woreno/IBM-PC-XT-compatible/8 adapter boards schematics.png

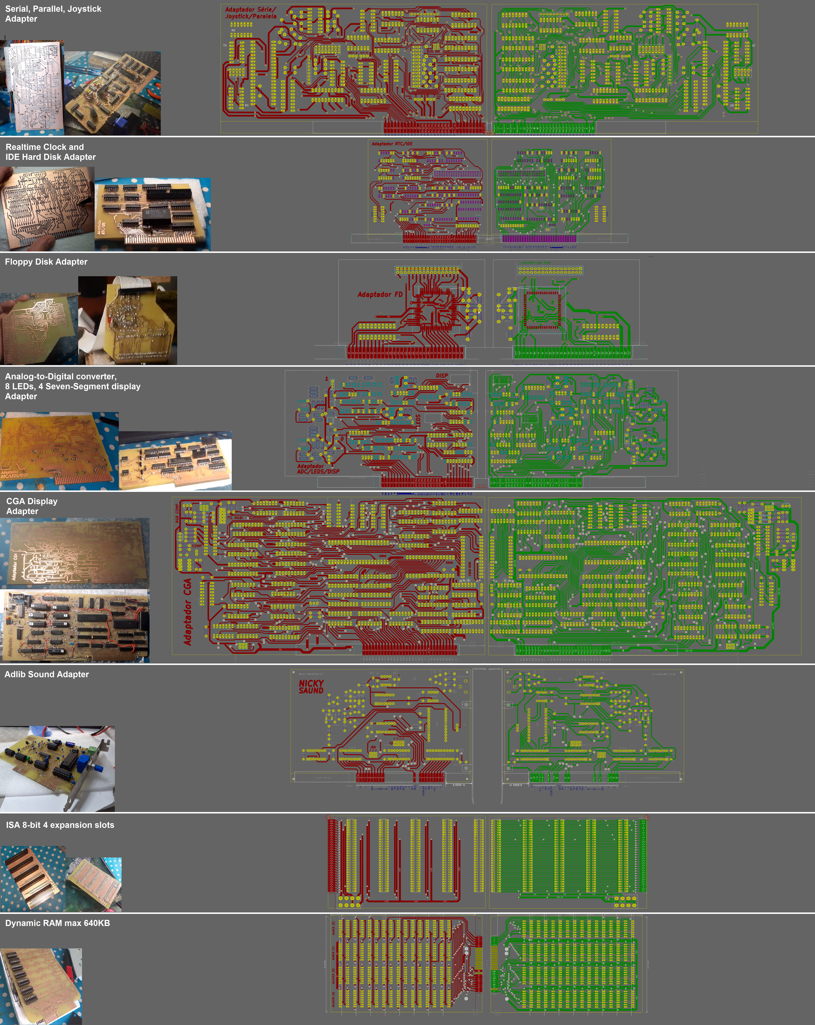
8 adapter boards schematics.png
