woreno/IBM-PC-XT-compatible/README.md

# IBM PC XT compatible (2022)
This is a IBM XT compatible built from scratch along 8 boards, 6 of them ISA 8-bit cards.

The design of the boards done here, is a bit personal. As other pcbs i do in-house, they are projected to be transfered with iron, drilled, then etched with iron perchlorate, using throught-hole chips, as many electronic and microcomputer hobbyists once did. To minimize errors on these manual procedures, circuits tracks and vias are made thicker. This project is about creating an IBM XT Compatible. This began in 2014, when i started to documenting home computer systems, like older and newer PCs, older systems like ZX Spectrum, MSX, Commodore, Amiga, Apple II, Macintosh, home and portable Sega, Nintendo and Sony entretainment systems, mainly for coding emulators. The IBM PC XT, was the second architecture to fully take notes after the ZX Spectrum.
In 2021, after manually designing and building an Apple 2 compatible computer and an Adlib card, i ask my self "it would be possible to build a bigger system like an IBM PC XT compatible using the same methods and tools???" (it seemed a big task by then). When i began, i wanted to be 8086 compatible, but the 16-bit bus and 16-bit memory organization logic, would make it impossible to fit in the maximum dimensions allowed by my own tools (A4 copper sheets), further the capacitance and thus distortion would be more pronounced on circuits.
Most components on IBM PC XT are Intel, DRAM, ROM ICs. Some control, demuxes and muxes, buffers, latches, and other glue logic is done using 74 series.

**BIOS**

* The BIOS is compiled with TASM using DOSBOX. 
* The BIOS was written from scratch except the INT10h (video services). The computer started without a videocard; first i built and relied on a ISA-card that displayed 4 seven-segment digits and 8 leds. Being the only way of displaying information from the computer, this board was very important, so after being built manually i tested rigorously the I/O with an ISA raiser, flipping buttons and multimeter, then, installing it on a Pentium PC and C Code. The BIOS has slowly developed step by step using this display board, so there's code everywhere that makes I/O to this board (including step and errors). After, i built the insane CGA card. At the first it used a primitive INT10h without a VBLANK wait (so a lot of white rain when printing), and at the end, since i was a bit exausted, i prefered to copy the original IBM PC XT INT10h code for having full compatiblity.
* After building the IDE/RTC card i had problems booting DOS. I had to CRC at each block at INT13h and do a comparasion with the groundtruth in another PC. So i end up to include also Single-Step and Breakpoint features, and debugging code traces at INT13h that can be activated by code. 
* The BIOS has a CGA welcome screen (compacted with RLE) and digitilized voices for digits (compacted with DeltaMod) these resources are glued and placed at 0xFB900. At the beggining at 0xF8000 there is the CRC and signature, and pointers to the previous resources. Theres a jump at 0xFFFF0 to the begining of the code. The voices were intended for announcing the time (with the RTC board) after POST, but at the end i decided to no call the feature, because it was too fancy.
* In the last revision of this computer, i added a switch to allow the PROMs to be written, and the BIOS can be updated via serial port, wifi or diskettes, so FAT code has added. Wifi was planned to added to the Paralllel/Serial/Joystick board, by adding a ESP8266 as the serial port (but i didn't finish this part); Wifi settings are stored in RTC memory along other BIOS settings. The make script composes a package to that goal.

**References**.
  * The Indispensable PC Hardware Book - Hans Peter Messmer; 1994
  * Digital Systems Project / Projecto de Sistemas Digitais (ISEL) - Victor Pimenta Rodrigues, Mário Seia de Araujo; 1988 (3th edition 2001)
  * IBM PC XT Technical Reference; 1983
  * Electrónica AC/DC/Analise circuitos - Santos, Guimarães e Oliveira, SA. Porto; 1980s
  * Interfacing to the IBM Personal Computer; Lewis C. Eggebrecht; 1983
  * Vintage Computer Federation (VCF)
  * GALBlast by Manfred Winterhoff
  * AT2XT Keyboard Adapter by Charles Guzis
  * XT-IDE by Charles Guzis, Vintage Computer Federation member (VCF)
  * HelpPC Reference Library by David Jurgens
  * Ben Eater's EEPROM arduino programmer
  * Dr Dobbs journal delta modulation
  * Every datasheet you can think of.

**Thanks to people i actually e-mailed them...**
  - CFG register will set the GALs scheme? Manfred Winterhoff, the author of GALBlast project
  - Can HTC lag on XT-IDE? Charles Guzis, the author of XT-IDE, XT2PS2 project
  - Whats the use of this diode on Adlib? the author of an Adlib, Sergey Malinov
