woreno/IBM-PC-XT-compatible/BIOS.png

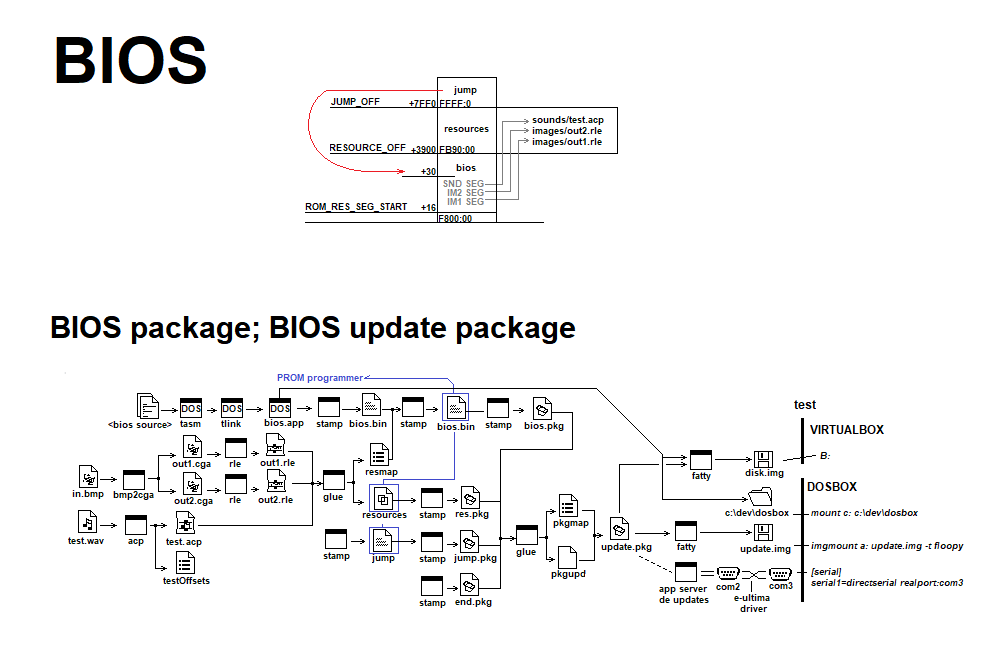
BIOS.png
