woreno/IBM-PC-XT-compatible/KICAD/ide/XT-IDE - Register map.jpg

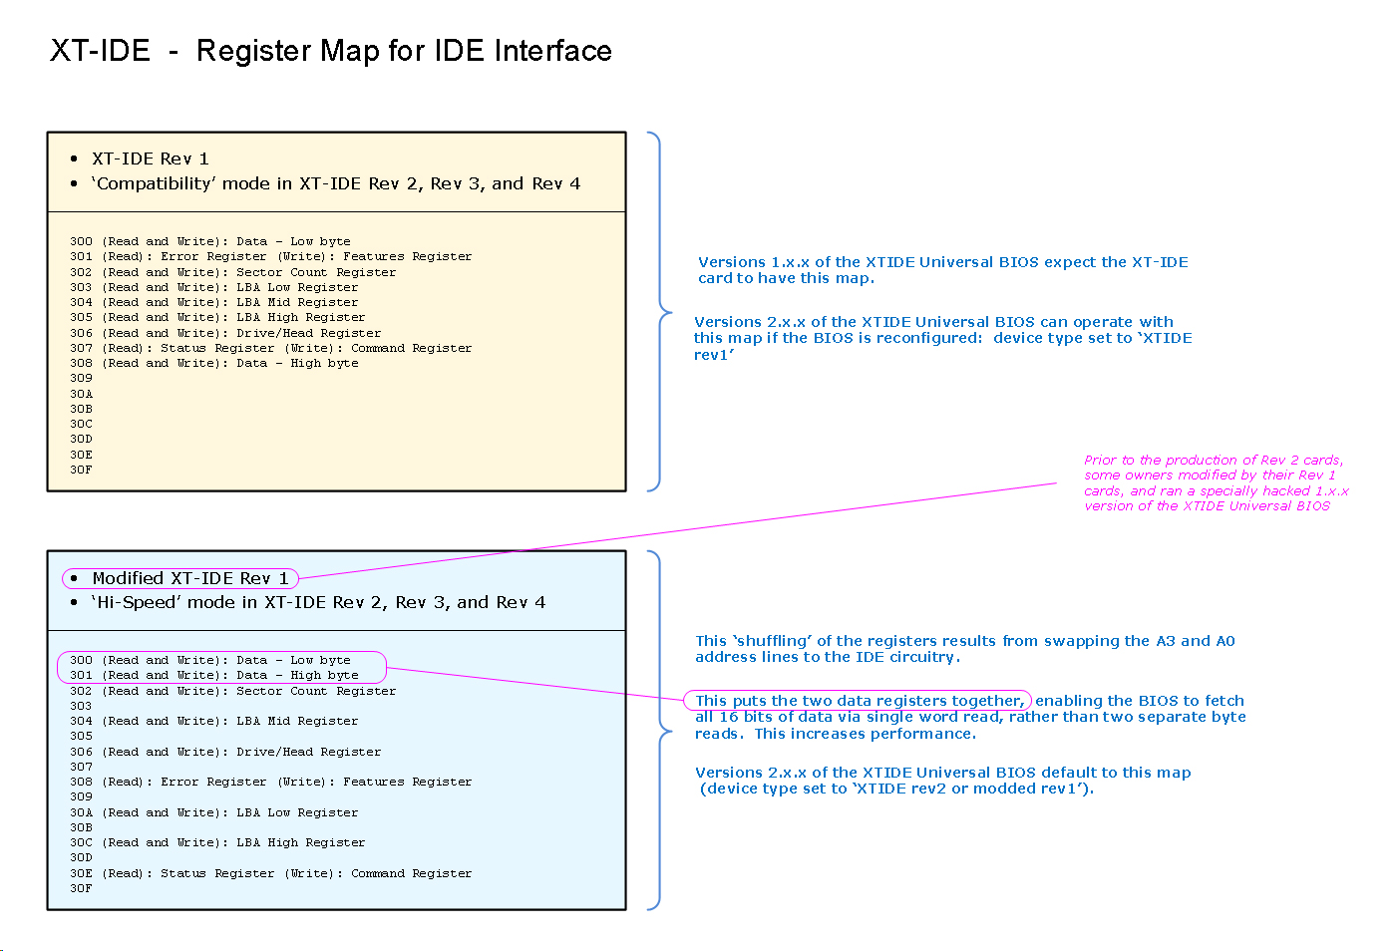
KICAD/ide/XT-IDE - Register map.jpg
