woreno/IBM-PC-XT-compatible/KICAD/ports/plel.png

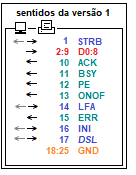
KICAD/ports/plel.png
