woreno/IBM-PC-XT-compatible/Main board schematic.png

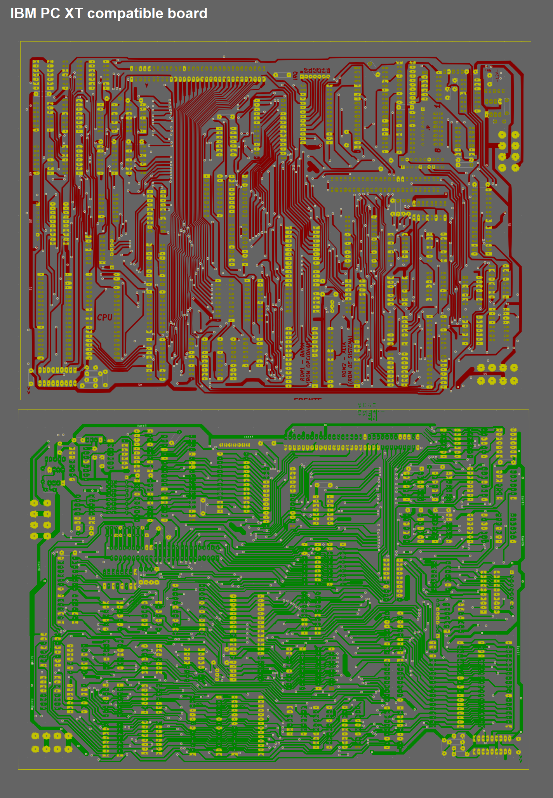
Main board schematic.png
