woreno/IBM-PC-XT-compatible/rom_test/BIOS/images/in.bmp

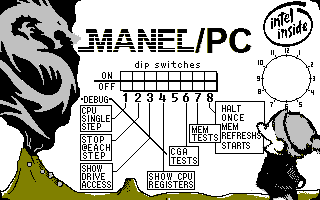
rom_test/BIOS/images/in.bmp
