woreno/IBM-PC-XT-compatible/KICAD/xt.kicad_pcb

## KiCad design KICAD/xt.kicad_pcb (2026-11-09)

Schematic: xt.sch

Parts:
C1: 5-30p; standard_2pins_half
C2, C4, C7, C9: 47p; standard_2pins_half
C3: .047; standard_2pins_half
C53: .01; standard_2pins_half
J1: IRQ8-15-Set; PinSocket_1x07_P2.54mm_Vertical
J9: xt_keyb_con; Conector1x5_Oval
P3: xt_speaker_con; Conector1x5_Oval
R1, R2: 510; standard_2pins
R3, R8, R9, R11, R12, R13, R17, R18, R19, R21, R22, R23, R24: R; standard_2pins
R4, R7: R
R4N_1, R4N_2, R4N_3, R4N_4: 30; standard_2pins
R5: 470; standard_2pins
R6: 33; standard_2pins
R15, R16: 4.7K; standard_2pins
R25: 8.2K; standard_2pins
RN1, RN2, RN3: 4.7K; R_Array_SIP9
RN4, RN5: 4.7K; R_Array_SIP10
RN4_0: 30; standard_2pins
SW1: SW_DIP_x08; Conector2x8_Oval
SW2: SW_DIP_x01
TD1: delay DS1000-100; standard_DIP_14OvalPins
U1: i8284_clockgen; standard_DIP_18pins_thin_body
U2, U9, U15: 74LS245; standard_DIP_20pins_thin_body
U3: i8088-CPU; standard_DIP_40pins_doubleBody_thinpins
U4, U19: PPROM_28C65_256; standard_DIP_28pins_thin_doubleBody
U5, U7: 74LS373; standard_DIP_20pins_thin_body
U6, U12, U14, U16, U17, U41: 74LS244; standard_DIP_20pins_thin_body
U8: 8288_busctrl; standard_DIP_20pins_thin_body
U10: 74LS670; standard_DIP_16OvalPins
U11: XD2ADDR-DMA; standard_DIP_20pins_thin_body
U13: 74LS243; standard_DIP_14OvalPins
U18: i8087-NPU; standard_DIP_40pins_doubleBody_thinpins
U20: ISA8-Edge; Conector2x31_Oval_0.65_rightangle
U21: 74LS175_separado; standard_DIP_16OvalPins
U22, U71, U220: 74LS04; standard_DIP_14OvalPins
U23: 74LS27; standard_DIP_14OvalPins
U24, U74: 74LS00; standard_DIP_14OvalPins
U25: i8259-PIC0; standard_DIP_28pins_thin_doubleBody
U26: 8255-PPI; standard_DIP_40pins_doubleBody_thinpins
U27: 74LS322; standard_DIP_20pins_thin_body
U28: i8254-PIT; standard_DIP_24pins_thin_doubleBody
U29, U57: 74LS20; standard_DIP_14OvalPins
U30: flipSwitch; mini_flipswitch2.54
U31: 74_175; standard_DIP_16OvalPins
U32, U38: manel-xt-pwer; manel-xt-power
U34: 8237-DMAC; standard_DIP_40pins_doubleBody_thinpins
U35, U36, U69: 74S00; standard_DIP_14OvalPins
U37: i8259-PIC1; standard_DIP_28pins_thin_doubleBody
U39, U40, U84: 74LS158; standard_DIP_16OvalPins
U42, U43: 74LS138; standard_DIP_16OvalPins
U44: flipSwitch
U55: 74S08; standard_DIP_14OvalPins
U56: 74S138; standard_DIP_16OvalPins
U58, U90: 74LS32; standard_DIP_14OvalPins
U68: 7407; standard_DIP_14OvalPins
U70: 74S74; standard_DIP_14OvalPins
U72: 74LS10; standard_DIP_14OvalPins
U73, U78, U86: 74LS74; standard_DIP_14OvalPins
U85: 75477_dual_peripheral_drvs; standard_DIP_8pins
U87: 74LS08; standard_DIP_14OvalPins
U89: 74S04; standard_DIP_14OvalPins
U100: xt-ram-exp; Conector2x25_Oval_0.65_rightangle
Y1: Crystal; standard_2pins

Connections:
/5V: C3.1, C4.1, J9.5 (VCC), P3.4 (VCC), R3.1, R4.1, R7.1, R8.2, R9.2, R11.1, R12.2, R13.2, R15.1, R16.2, R17.1, R18.1, R19.1, R21.2, R22.2, R23.1, R24.2, R25.2, RN1.1 (common), RN2.1 (common), RN3.1 (common), RN5.1 (common), TD1.14 (VCC), U1.18 (VCC), U2.20 (VCC), U3.40 (VCC), U4.28 (VCC), U5.20 (VCC), U6.20 (VCC), U7.20 (VCC), U8.20 (VCC), U9.20 (VCC), U10.16 (VCC), U11.20 (VCC), U12.20 (VCC), U13.14 (VCC), U14.20 (VCC), U15.20 (VCC), U16.20 (VCC), U17.20 (VCC), U18.40 (VCC), U19.28 (VCC), U20.3 (+5V), U20.29 (+5V), U21.16 (VCC), U22.14 (VCC), U23.14 (VCC), U24.14 (VCC), U25.28 (VCC), U26.26 (VCC), U27.20 (VCC), U28.11 (GATE0), U28.14 (GATE1), U28.24 (VCC), U29.14 (VCC), U31.16 (VCC), U32.3 (+5V), U32.4 (+5V), U34.5 (PIN5), U34.31 (VCC), U35.14 (VCC), U36.14 (VCC), U37.28 (VCC), U38.3 (+5V), U38.4 (+5V), U39.16 (VCC), U40.16 (VCC), U41.20 (VCC), U42.16 (VCC), U43.16 (VCC), U55.14 (VCC), U56.16 (VCC), U57.14 (VCC), U58.14 (VCC), U68.14 (VCC), U69.14 (VCC), U70.14 (VCC), U71.14 (VCC), U72.14 (VCC), U73.14 (VCC), U74.14 (VCC), U78.14 (VCC), U84.16 (VCC), U85.1 (S), U85.5 (CLAMP), U85.8 (VCC), U86.14 (VCC), U87.14 (VCC), U89.14 (VCC), U90.14 (VCC), U220.14 (VCC); also elsewhere on the board
/12V: U32.1 (+12V), U38.1 (+12V)
/+12V: U20.23 (IRQ5)
/-5V: U20.27 (TC), U32.5 (-5V), U38.5 (-5V)
/-12V: U20.25 (IRQ3), U32.2 (-12V), U38.2 (-12V)
/A0: U5.9 (O3), U12.18 (O0a), U17.11 (I0b), U20.62 (A0)
/A1: U5.12 (O4), U12.3 (O3b), U17.8 (I3a), U20.61 (A1)
/A2: U5.15 (O5), U12.16 (O1a), U17.13 (I1b), U20.60 (A2)
/A3: U5.6 (O2), U12.5 (O2b), U17.6 (I2a), U20.59 (A3)
/A4: U5.5 (O1), U12.14 (O2a), U17.15 (I2b), U20.58 (A4)
/A5: U5.16 (O6), U12.7 (O1b), U17.4 (I1a), U20.57 (A5)
/A6: U5.19 (O7), U12.9 (O0b), U17.2 (I0a), U20.56 (A6)
/A7: U5.2 (O0), U12.12 (O3a), U17.17 (I3b), U20.55 (A7)
/A8: U6.18 (O0a), U11.2 (O0), U16.15 (I2b), U20.54 (A8)
/A9: U6.16 (O1a), U11.5 (O1), U16.6 (I2a), U20.53 (A9)
/A10: U6.14 (O2a), U11.6 (O2), U16.17 (I3b), U20.52 (A10)
/A11: U6.12 (O3a), U11.9 (O3), U16.2 (I0a), U20.51 (A11)
/A12: U7.12 (O4), U11.12 (O4), U16.4 (I1a), U20.50 (A12)
/A13: U7.9 (O3), U11.15 (O5), U14.11 (I0b), U20.49 (A13)
/A14: U7.15 (O5), U11.16 (O6), U14.8 (I3a), U20.48 (A14)
/A15: U7.6 (O2), U11.19 (O7), U14.13 (I1b), U20.47 (A15)
/A16: U7.16 (O6), U10.10 (Q1), U14.6 (I2a), U20.46 (A16), U36.10
/A17: U7.5 (O1), U10.9 (Q2), U14.15 (I2b), U20.45 (A17), U35.4
/A18: U7.2 (O0), U10.7 (Q3), U14.4 (I1a), U20.44 (A18), U35.1, U35.2, U36.4
/A19: U7.19 (O7), U10.6 (Q4), U14.17 (I3b), U20.43 (A19), U35.10, U36.1, U36.2, U36.9
/AA8: U3.8 (A8), U6.2 (I0a), U18.8 (AD8)
/AA9: U3.7 (A9), U6.4 (I1a), U18.7 (AD9)
/AA10: U3.6 (A10), U6.6 (I2a), U18.6 (AD10)
/AA11: U3.5 (A11), U6.8 (I3a), U18.5 (AD11)
/AA12: U3.4 (A12), U7.13 (D4), U18.4 (AD12)
/AA13: U3.3 (A13), U7.8 (D3), U18.3 (AD13)
/AA14: U3.2 (A14), U7.14 (D5), U18.2 (AD14)
/AA15: U3.39 (A15), U7.7 (D2), U18.39 (AD15)
/AA16: U3.38 (A16.S3), U7.17 (D6), U18.38 (A16.S3)
/AA17: U3.37 (A17.S5), U7.4 (D1), U18.37 (A17.S4)
/AA18: U3.36 (A18.S6), U7.3 (D0), U18.36 (A18.S5)
/AA19: U3.35 (A19.S4), U7.18 (D7), U18.35 (A19.S6)
/AD0: U2.2 (A0), U3.16 (AD0), U5.8 (D3), U18.16 (AD0)
/AD1: U2.3 (A1), U3.15 (AD1), U5.13 (D4), U18.15 (AD1)
/AD2: U2.4 (A2), U3.14 (AD2), U5.14 (D5), U18.14 (AD2)
/AD3: U2.5 (A3), U3.13 (AD3), U5.7 (D2), U18.13 (AD3)
/AD4: U2.6 (A4), U3.12 (AD4), U5.4 (D1), U18.12 (AD4)
/AD5: U2.7 (A5), U3.11 (AD5), U5.17 (D6), U18.11 (AD5)
/AD6: U2.8 (A6), U3.10 (AD6), U5.18 (D7), U18.10 (AD6)
/AD7: U2.9 (A7), U3.9 (AD7), U5.3 (D0), U18.9 (AD7)
/ADDRSEL: TD1.3 (60NS), U39.1 (S), U40.1 (S), U84.1 (S)
/ADSTB: U11.11 (LE), U34.8 (ADSTB)
/AEN: U16.9 (O0b), U20.42 (AEN)
/AENBOARD: U5.1 (OE), U6.1 (OEa), U7.1 (OE), U8.6 (~AEN), U15.19 (CE), U16.11 (I0b), U17.1 (OEa), U17.19 (OEb), U31.2 (Q0), U31.5 (D1), U72.5, U74.4
/ALE: U5.11 (LE), U7.11 (LE), U8.5 (ALE), U20.4 (IRQ2/9)
/BA0: RN4.2 (R1), RN5.2 (R1), U39.4 (Za), U100.33 (~CAS0)
/BA1: RN4.3 (R2), RN5.3 (R2), U40.4 (Za), U100.32 (~RAS1)
/BA2: RN4.4 (R3), RN5.4 (R3), U39.7 (Zb), U100.31 (~CAS1)
/BA3: RN4.5 (R4), RN5.5 (R4), U40.7 (Zb), U100.30 (~RAS2)
/BA4: RN4.6 (R5), RN5.6 (R5), U39.9 (Zd), U100.29 (~CAS2)
/BA5: RN4.7 (R6), RN5.7 (R6), U40.9 (Zd), U100.28 (~RAS3)
/BA6: RN4.8 (R7), RN5.8 (R7), U39.12 (Zc), U100.27 (~CAS3)
/BA7: RN4.9 (R8), RN5.9 (R8), U40.12 (Zc), U100.26
/CLK: U16.7 (O1b), U20.12 (~MEMR), U31.9 (Cp), U89.9
/CLK88: U1.8 (CLK), U3.19 (CLK), U8.2 (CLK), U16.13 (I1b), U18.19 (CLK), U89.1
/CPU_GT0: RN1.2 (R1), U3.30 (HLDA.~RQ~/~GT1), U3.31 (HOLD.~RQ~/~GTO), U18.31 (~RQ/GTO)
/CPU_INT: U3.18 (INT), U25.17 (INT)
/CPU_NMI: U3.17 (NMI), U87.8
/D0: U2.18 (B0), U9.2 (A0), U15.2 (A0), U20.40 (D0)
/D1: U2.17 (B1), U9.3 (A1), U15.3 (A1), U20.39 (D1)
/D2: U2.16 (B2), U9.4 (A2), U15.4 (A2), U20.38 (D2)
/D3: U2.15 (B3), U9.5 (A3), U15.5 (A3), U20.37 (D3)
/D4: U2.14 (B4), U9.6 (A4), U15.6 (A4), U20.36 (D4)
/D5: U2.13 (B5), U9.7 (A5), U15.7 (A5), U20.35 (D5)
/D6: U2.12 (B6), U9.8 (A6), U15.8 (A6), U20.34 (D6)
/D7: U2.11 (B7), U9.9 (A7), U15.9 (A7), U20.33 (D7)
/DACK0: U56.4 (E1), U69.13, U220.4
/DATABUS_DIR: U2.1 (A->B), U8.4 (DT/~R)
/DATABUS_EN: U2.19 (CE), U22.12
/DBLCLK: U34.12 (CLK), U74.8
/DRAM_MODHI: U14.3 (O3b), U42.2 (A1), U43.6 (E3), U56.2 (A1)
/DRAM_MODLO: U36.11, U42.1 (A0), U56.1 (A0)
/DREQ0: U34.19 (DREQ0), U73.9 (Q)
/DREQ1: U20.14 (~IOR), U34.18 (DREQ1)
/DREQ2: U20.26 (~DACK2), U34.17 (DREQ2)
/DREQ3: U20.16 (DRQ3), U34.16 (DREQ3)
/ENRAMPCK: U26.22 (PB4)
/HOLDA: U31.4 (D0), U34.7 (HLDA), U73.5 (Q)
/HRQDMA: U29.5, U34.10 (HRQ), U73.1 (~R)
/IOCHRDY: R23.2, U20.41 (IO_READY), U78.10 (~S)
/IRQ0: U25.18 (IR0), U28.10 (OUT0)
/IRQ1: U25.19 (IR1), U27.1 (G), U70.5 (Q)
/IRQ2: U25.20 (IR2), U37.17 (INT)
/IRQ3: U20.7 (-12V), U25.21 (IR3)
/IRQ4: U20.8 (UNUSED), U25.22 (IR4)
/IRQ5: U20.9 (+12V), U25.23 (IR5)
/IRQ6: U20.10 (GND), U25.24 (IR6)
/IRQ7: U20.11 (~MEMW), U25.25 (IR7)
/IRQ8: J1.1, U37.18 (IR0)
/IRQ9: U20.28 (ALE), U37.19 (IR1)
/IRQ10: J1.2, U37.20 (IR2)
/IRQ11: J1.3, U37.21 (IR3)
/IRQ12: J1.4, U37.22 (IR4)
/IRQ13: J1.5, U37.23 (IR5)
/IRQ14: J1.6, U37.24 (IR6)
/IRQ15: J1.7, U37.25 (IR7)
/KBDCLK: C2.2, J9.1 (KBDCLK), R18.2, U21.4 (D0), U68.6
/KBDCLK2: U21.6 (~Q1), U27.11 (Clk), U70.3 (C)
/KBDDATA: C7.2, J9.2 (KBDDATA), R17.2, U27.17 (D1), U68.8
/MA8: RN4.10 (R9), RN5.10 (R9), U84.4 (Za), U100.25 (5V)
/MD0: U9.11 (B7), U100.3 (A2)
/MD1: U9.12 (B6), U100.2 (A1)
/MD2: U9.13 (B5), U100.1 (A0)
/MD3: U9.14 (B4), U100.50 (D0)
/MD4: U9.15 (B3), U100.49 (D1)
/MD5: U9.16 (B2), U100.48 (D2)
/MD6: U9.17 (B1), U100.46 (D4)
/MD7: U9.18 (B0), U100.47 (D3)
/NPU_INT: U18.32 (INT), U69.9
/NP_INSTALLED: RN3.3 (R2), SW1.2, U41.4 (I1a)
/OPTION1: RN3.2 (R1), SW1.1, U41.2 (I0a)
/OSC: U1.12 (OSC), U20.2 (RESET)
/PCLK: U1.2 (PCLK), U21.9 (CLK)
/PIC_CAS0: U25.12 (CAS0), U37.12 (CAS0)
/PIC_CAS1: U25.13 (CAS1), U37.13 (CAS1)
/PIC_CAS2: U25.15 (CAS2), U37.15 (CAS2)
/PIT_T1_OUT: U28.13 (OUT1), U73.11 (C), U100.6 (A5), U100.45 (D5)
/PIT_T2_OUT: U28.17 (OUT2), U87.13, U100.8 (A7), U100.43 (D7)
/PLANARRAM0: RN3.4 (R3), SW1.3, U41.6 (I2a)
/PLANARRAM1: RN3.5 (R4), SW1.4, U41.8 (I3a)
/PPI_JPR4: RN3.9 (R8), SW1.8, U26.17 (PC3), U41.12 (O3a)
/PPI_JPR5: RN3.8 (R7), SW1.7, U26.16 (PC2), U41.14 (O2a)
/PPI_JPR6: RN3.7 (R6), SW1.6, U26.15 (PC1), U41.16 (O1a)
/PPI_JPR7: RN3.6 (R5), SW1.5, U26.14 (PC0), U41.18 (O0a)
/PPI_PA0: U26.4 (PA0), U27.13 (H/Qh)
/PPI_PA1: U26.3 (PA1), U27.7 (G/Qg)
/PPI_PA2: U26.2 (PA2), U27.14 (F/Qf)
/PPI_PA3: U26.1 (PA3), U27.6 (E/Qe)
/PPI_PA4: U26.40 (PA4), U27.15 (D/Qd)
/PPI_PA5: U26.39 (PA5), U27.5 (C/Qc)
/PPI_PA6: U26.38 (PA6), U27.16 (B/Qb)
/PPI_PA7: U26.37 (PA7), U27.4 (A/Qa)
/PPI_PB3: R25.1, U26.21 (PB3), U41.1 (OEa), U100.11, U100.40, U220.1
/PPI_PB5: U26.23 (PB5), U89.13
/PPI_PB6: U26.24 (PB6), U68.5
/PPI_PB7: U26.25 (PB7), U27.8 (OE), U89.5
/PPI_PC4: U26.13 (PC4)
/PPI_PC5: U26.12 (PC5)
/PPI_PC6: U26.11 (PC6), U72.11, U74.2, U74.11
/PULLUP1: RN2.8 (R7), U18.33 (~RQ/GT1), U18.34 (~BHE/~S7)
/PWERGOOD: U1.11 (~RES)
/QS0: U3.25 (QS0.ALE), U18.25 (QS0)
/QS1: U3.24 (QS1.~INTA), U18.24 (QS1)
/RAS: TD1.1 (IN), U56.6 (E3), U69.6, U69.12
/RDYTODMA: U34.6 (READY), U87.3
/READY: U1.5 (READY), U3.22 (RDY), U18.22 (RDY)
/RESET: U1.10 (RESET), U3.21 (RST), U18.21 (RST), U26.35 (RESET), U34.13 (RESET), U89.3
/RESETDRV: U20.30 (OSC), U71.6
/RN1_6: RN1.3 (R2), U3.23 (~TEST), U18.23 (BUSY)
/RN1_7: RN1.8 (R7)
/RN1_9: RN1.9 (R8), U57.13
/ROMCS: U23.5, U24.8; also elsewhere on the board
/SPK: C53.1, R6.1, U85.6 (2Y)
/SPKRDATA: U26.19 (PB1), U87.12
/SS0: U3.34 (~SS0.HIGH)
/TIM2GATESPK: U26.18 (PB0), U28.16 (GATE2), U100.14 (GND), U100.37
/TIMER_CLK: U21.10 (Q2), U28.9 (CLK0), U28.15 (CLK1), U28.18 (CLK2), U100.13 (GND), U100.38 (~WR)
/T\C: U20.5 (-5V), U220.8
/X1: C1.2, R1.1, U1.17 (X1)
/X2: R2.1, U1.16 (X2), Y1.2
/XA0: U4.10 (A0), U10.14 (Wa), U12.2 (I0a), U17.9 (O0b), U19.10 (A0), U25.27 (A0), U26.9 (A0), U28.19 (A0), U34.32 (A0), U37.27 (A0), U39.2 (I0a)
/XA1: U4.9 (A1), U10.13 (Wb), U12.17 (I3b), U17.12 (O3a), U19.9 (A1), U26.8 (A1), U28.20 (A1), U34.33 (A1), U40.2 (I0a), U100.15 (GND), U100.36
/XA2: U4.8 (A2), U12.4 (I1a), U17.7 (O1b), U19.8 (A2), U34.34 (A2), U39.5 (I0b)
/XA3: U4.7 (A3), U12.15 (I2b), U17.14 (O2a), U19.7 (A3), U34.35 (A3), U40.5 (I0b)
/XA4: U4.6 (A4), U12.6 (I2a), U17.5 (O2b), U19.6 (A4), U34.37 (A4), U39.11 (I0d), U58.2, U58.4
/XA5: U4.5 (A5), U12.13 (I1b), U17.16 (O1a), U19.5 (A5), U34.38 (A5), U40.11 (I0d); also elsewhere on the board
/XA6: U4.4 (A6), U12.11 (I0b), U17.18 (O0a), U19.4 (A6), U34.39 (A6), U39.14 (I0c); also elsewhere on the board
/XA7: U4.3 (A7), U12.8 (I3a), U17.3 (O3b), U19.3 (A7), U34.40 (A7), U40.14 (I0c); also elsewhere on the board
/XA8: U4.25 (A8), U16.5 (O2b), U19.25 (A8), U40.3 (I1a), U44.3 (line2), U58.1; also elsewhere on the board
/XA9: U4.24 (A9), U16.14 (O2a), U19.24 (A9), U23.2, U39.6 (I1b); also elsewhere on the board
/XA10: U4.21 (A10), U16.3 (O3b), U19.21 (A10), U40.6 (I1b)
/XA11: U4.23 (A11), U16.18 (O0a), U19.23 (A11), U39.10 (I1d)
/XA12: U4.2 (A12), U16.16 (O1a), U19.2 (A12), U40.10 (I1d)
/XA13: U4.26 (A13), U14.9 (O0b), U19.26 (A13), U39.13 (I1c)
/XA14: U4.1 (A14), U14.12 (O3a), U19.1 (A14), U39.3 (I1a)
/XA15: U14.7 (O1b), U40.13 (I1c), U43.1 (A0)
/XA16: U14.14 (O2a), U43.2 (A1), U84.2 (I0a)
/XA17: U14.5 (O2b), U43.3 (A2), U84.3 (I1a)
/XA18: U14.16 (O1a), U24.1, U24.2; also elsewhere on the board
/XD0: U4.11 (D0), U10.15 (D1), U11.3 (D0), U15.18 (B0), U19.11 (D0), U25.11 (D0), U26.34 (D0), U28.8 (D0), U34.30 (D0), U37.11 (D0)
/XD1: U4.12 (D1), U10.1 (D2), U11.4 (D1), U15.17 (B1), U19.12 (D1), U25.10 (D1), U26.33 (D1), U28.7 (D1), U34.29 (D1), U37.10 (D1)
/XD2: U4.13 (D2), U10.2 (D3), U11.7 (D2), U15.16 (B2), U19.13 (D2), U25.9 (D2), U26.32 (D2), U28.6 (D2), U34.28 (D2), U37.9 (D2)
/XD3: U4.15 (D3), U10.3 (D4), U11.8 (D3), U15.15 (B3), U19.15 (D3), U25.8 (D3), U26.31 (D3), U28.5 (D3), U34.27 (D3), U37.8 (D3)
/XD4: U4.16 (D4), U11.13 (D4), U15.14 (B4), U19.16 (D4), U25.7 (D4), U26.30 (D4), U28.4 (D4), U34.26 (D4), U37.7 (D4)
/XD5: U4.17 (D5), U11.14 (D5), U15.13 (B5), U19.17 (D5), U25.6 (D5), U26.29 (D5), U28.3 (D5), U34.23 (D5), U37.6 (D5)
/XD6: U4.18 (D6), U11.17 (D6), U15.12 (B6), U19.18 (D6), U25.5 (D6), U26.28 (D6), U28.2 (D6), U34.22 (D6), U37.5 (D6)
/XD7: U4.19 (D7), U11.18 (D7), U15.11 (B7), U19.19 (D7), U25.4 (D7), U26.27 (D7), U28.1 (D7), U34.21 (D7), U37.4 (D7), U86.12 (D)
/XMEMR: U71.10, U72.4
/\eop: R19.2, U34.36 (~EOP), U220.9
/efi: U1.14 (EFI)
/~AEN: U8.15 (CEN), U31.3 (~Q0), U57.9; also elsewhere on the board
/~CAS: U42.5 (E2), U69.3
/~CAS0: U42.15 (O0), U100.20 (5V)
/~CAS1: U42.14 (O1), U100.21 (~5V)
/~CAS2: U42.13 (O2), U100.22 (~5V)
/~CAS3: U42.12 (O3), U100.23 (~5V)
/~DACK0: U16.12 (O3a), U20.13 (~IOW)
/~DACK0BRD: U16.8 (I3a), U24.4, U34.25 (~DACK0), U42.6 (E3), U72.3, U73.13 (~R), U78.12 (D), U220.3; also elsewhere on the board
/~DACK1: U20.15 (~DACK3), U34.24 (~DACK1)
/~DACK2: U10.4 (Rb), U20.6 (DRQ2), U34.14 (~DACK2)
/~DACK3: U10.5 (Ra), U20.17 (~DACK1), U34.15 (~DACK3)
/~DATABUS_EN: U8.16 (DEN), U22.13
/~DMACS: U34.11 (~CS), U90.13; also elsewhere on the board
/~DMAEN: U10.11 (~Er), U11.1 (OE), U12.1 (OEa), U12.19 (OEb), U13.1 (OEa), U13.13 (OEb), U74.6
/~DMAWAIT: U1.4 (RDY1), U31.6 (~Q1)
/~HDD_CS: R4.2, U23.9
/~INTA: RN2.6 (R5), U8.14 (~INTA), U24.13, U25.26 (~INTA), U37.26 (~INTA), U100.12 (GND), U100.39; also elsewhere on the board
/~IOCHK: R8.1, U20.32 (~IOCHK), U74.1
/~IOR: RN2.4 (R3), U8.13 (~IORC), U13.8 (B3), U20.18 (DRQ1)
/~IOW: RN2.2 (R1), U8.12 (~AIOWC), U13.10 (B1), U20.19 (~DACK0)
/~KBDRESET: C9.2, J9.3 (~KBDRESET), U21.1 (~MR), U31.1 (~Mr), U71.5, U86.13 (~R), U89.4
/~LOCK: U3.29 (~WR~.~LOCK), U29.1
/~MEMR: RN2.7 (R6), U8.7 (~MRDC), U13.11 (B0), U20.20 (CLK88), U57.12
/~MEMW: RN2.5 (R4), U8.8 (~AMWC), U13.9 (B2), U20.21 (IRQ7), U30.1 (line1)
/~MWTC: RN2.3 (R2), U8.9 (~MWTC), U57.10
/~PIC0CS: U25.1 (~CS); also elsewhere on the board
/~PIC1CS: U37.1 (~CS), U100.9 (A8), U100.42; also elsewhere on the board
/~PPICS: U26.6 (~CS), U58.6, U100.10, U100.41
/~RAMADDRSEL: U9.19 (CE), U24.6, U42.4 (E1), U56.5 (E2); also elsewhere on the board
/~RAS0: R4N_1.1, U100.16 (GND)
/~RAS1: R4N_2.1, U100.17
/~RAS2: R4N_3.1, U100.18
/~RAS3: R4N_4.1, U100.19 (5V)
/~RDY~\WAIT: U1.3 (~AEN1), U31.12 (D2), U78.9 (Q)
/~REFRESH_GATE: U55.1, U55.4, U55.10, U55.13, U69.11
/~ROMCS0: U4.20 (~CE), U4.22 (~OE), U24.9, U43.9 (O6); also elsewhere on the board
/~ROMCS1: U19.20 (~CE), U19.22 (~OE), U24.10, U43.7 (O7); also elsewhere on the board
/~ROMWR: U4.27 (~WE), U19.27 (~WE), U30.2 (short)
/~S0: U3.26 (~DEN.~S0), U8.19 (~S0), U18.26 (~S0), U29.4
/~S1: U3.27 (DT/~R~.~S1), U8.3 (~S1), U18.27 (~S1), U29.2
/~S2: U3.28 (IO/~M~.~S2), U8.18 (~S2), U18.28 (~S2)
/~TCCS: U28.21 (~CS); also elsewhere on the board
/~WE: RN4_0.1, U100.35
/~WRTDMAPGREG: U10.12 (~Ew), U58.8
/~WRTNMIREG: U58.11, U86.11 (C)
/~XIOR: RN1.7 (R6), U13.6 (A3), U23.1, U23.10, U23.11, U25.3 (~RD), U26.5 (~RD), U28.22 (~RD), U34.1 (~IOR), U37.3 (~RD), U72.13, U100.7 (A6), U100.44 (D6)
/~XIOW: RN1.5 (R4), U13.4 (A1), U25.2 (~WR), U26.36 (~WR), U28.23 (~WR), U34.2 (~IOW), U37.2 (~WR), U58.10, U58.12, U72.1, U90.12
/~XMEMR: RN1.4 (R3), U9.1 (A->B), U13.3 (A0), U34.3 (~MEMR), U43.5 (E2), U69.5, U71.11
/~XMEMW: RN1.6 (R5), U13.5 (A2), U22.1, U34.4 (~MEMW), U69.4
Earth: C2.1, C3.2, C4.2, C7.1, C9.1, C53.2, J9.4 (GND), P3.3 (GND), R1.2, R2.2, RN4.1 (common), SW1.13, SW1.14, SW1.15, SW1.16, SW2.1, TD1.7 (GND), U1.1 (CSYNC), U1.6 (RDY2), U1.9 (GND), U1.13 (F/~C), U1.15 (~ASYNC), U2.10 (GND), U3.1 (GND), U3.20 (GND), U3.33 (MIN/~MAX), U4.14 (GND), U5.10 (GND), U6.10 (GND), U7.10 (GND), U8.1 (Multibus), U8.10 (GND), U9.10 (GND), U10.8 (GND), U11.10 (GND), U12.10 (GND), U13.7 (GND), U14.1 (OEa), U14.10 (GND), U14.19 (OEb), U15.10 (GND), U16.1 (OEa), U16.10 (GND), U16.19 (OEb), U17.10 (GND), U18.1 (GND), U18.20 (GND), U19.14 (GND), U20.1 (GND), U20.22 (IRQ6), U20.31 (GND), U21.8 (GND), U22.7 (GND), U23.7 (GND), U24.7 (GND), U25.14 (GND), U26.7 (GND), U26.10 (PC7), U27.10 (GND), U28.12 (GND), U29.7 (GND), U31.8 (GND), U32.7 (GND), U32.8 (GND), U34.20 (GND), U35.7 (GND), U36.7 (GND), U37.14 (GND), U37.16 (~SP~/~EN), U38.7 (GND), U38.8 (GND), U39.8 (GND), U39.15 (E), U40.8 (GND), U40.15 (E), U41.10 (GND), U42.3 (A2), U42.8 (GND), U43.8 (GND), U55.7 (GND), U56.8 (GND), U57.7 (GND), U58.7 (GND), U68.7 (GND), U69.7 (GND), U70.7 (GND), U71.7 (GND), U72.7 (GND), U73.7 (GND), U74.7 (GND), U78.7 (GND), U84.8 (GND), U84.15 (E), U85.4 (GND), U86.7 (GND), U87.7 (GND), U89.7 (GND), U90.7 (GND), U220.7 (GND); also elsewhere on the board
unnamed: C1.1, Y1.1
unnamed: P3.1 (KEY), R6.2
unnamed: R3.2, U30.3 (line2)
unnamed: R4N_1.2, U55.3
unnamed: R4N_2.2, U55.11
unnamed: R4N_3.2, U55.6
unnamed: R4N_4.2, U55.8
unnamed: R5.1, U89.8
unnamed: R5.2, U74.9
unnamed: R9.1, U69.10
unnamed: R11.2, U27.2 (S/P), U27.3 (D0), U27.18 (SE), U27.19 (DS)
unnamed: R12.1, U72.9
unnamed: R13.1, U86.10 (~S)
unnamed: R15.2, U1.7 (~AEN2)
unnamed: R16.1, U25.16 (~SP~/~EN)
unnamed: R21.1, U26.20 (PB2)
unnamed: R22.1, U73.10 (~S), U73.12 (D)
unnamed: R24.1, U56.3 (A2)
unnamed: RN4_0.2, U22.4
unnamed: SW1.9, U68.10
unnamed: SW1.10, U68.12
unnamed: SW1.11, U68.4
unnamed: SW1.12, U68.2
unnamed: SW2.2, U69.8, U72.10
unnamed: TD1.5 (100NS), U69.1
unnamed: U15.1 (A->B), U23.6
unnamed: U21.2 (Q0), U21.5 (D1)
unnamed: U21.11 (~Q2), U21.12 (D2)
unnamed: U22.2, U22.3
unnamed: U22.5, U90.11
unnamed: U22.6, U90.10
unnamed 302: U23.4, U24.11; also elsewhere on the board
unnamed: U23.3, U23.12
unnamed: U23.13, U44.2 (short)
unnamed 305: U24.3, U43.4 (E1); also elsewhere on the board
unnamed 306: U24.5, U35.8; also elsewhere on the board
unnamed: U27.9 (Clr), U70.1 (~R), U89.6
unnamed: U27.12 (Qh), U70.2 (D)
unnamed: U29.6, U90.9
unnamed: U31.7 (Q1), U74.5
unnamed: U31.11 (~Q2), U78.13 (~R), U87.2
unnamed: U31.13 (D3), U71.2
unnamed: U31.15 (Q3), U73.2 (D)
unnamed 318: U58.13; also elsewhere on the board
unnamed 319: U58.9; also elsewhere on the board
unnamed 320: U58.5; also elsewhere on the board
unnamed: U35.9, U35.11
unnamed: U35.6, U35.12
unnamed: U35.3, U35.5, U35.13
unnamed: U36.3, U36.5
unnamed: U36.6, U36.12
unnamed: U36.8, U36.13
unnamed: U44.1 (line1), U58.3
unnamed: U55.2, U56.11 (O4)
unnamed: U55.5, U56.9 (O6)
unnamed: U55.9, U56.7 (O7)
unnamed: U55.12, U56.10 (O5)
unnamed: U57.8, U69.2
unnamed: U68.9, U70.4 (~S), U70.6 (~Q)
unnamed: U71.1, U90.8
unnamed: U72.2, U72.6
unnamed: U72.8, U87.10
unnamed: U72.12, U78.11 (C)
unnamed: U73.3 (C), U74.10, U89.2
unnamed: U73.4 (~S), U73.6 (~Q)
unnamed: U74.3, U74.12
unnamed: U74.13, U89.12
unnamed: U78.8 (~Q), U87.1
unnamed: U85.7 (2A), U87.11
unnamed: U86.9 (Q), U87.9
unnamed: U68.1, U68.3, U68.11, U68.13, U220.2
unnamed: U24.12, U220.12
unnamed: U23.8, U220.13

Notes on the sheet:
O gerador de clocks produz apartir de OSC CLK : 1/3 de OSC, 33% duty PCLK : 1/6 de OSC, 50% duty
OSC é gerado apartir dum oscilador cristal a 14.31818MHz
presa do endereço alto
~OE + S/~P=LO => parallel load data in: clock ascendente
este driver para 2 cargas era suposto além de levar o sinal de out2 para speaker, levar o sinal MOTORON para o recorder por 1A-1Y, (no PC original desde PB3, substituido)
aqui esta esquizita forma de comutar os jumpers se PB3=LO passa o transceiver 244 com a parte baixa dos jumpers e o inversor fica a HI, não fazendo diferença os jumpers da parte alta; se PB3=HI a parte baxa não passa e o inversor fica à terra, deixando passar os jumpers na parte alta (porque ligam 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
este PIP está a contar que vai ser programado para que as linhas PPI_A e PPI_C serem de leitura (IN), PPI_B serem de escrita (OUT)
desde cpu e controlador DMA se CPU em ESTADO PASSIVO ou HALT e não lock, e houver request DMA então proceder
um pedido dum canal DMA, desde controlador DMA
confirmação de cedência para o controlador DMA
para gerador clocks
e ativar controlador DMA
para READY no controlador DMA (sinal anologo a /IOCHRDY mas para o DMA)
para fachada com bus local
para controlador bus
para clock controlador DMA
pedido de atualização de memória (canal 0) apenas se não houver confirmação do mesmo ainda
esta delay line foi substuido por resistência em versões post.
divisor da frequência de PCLK resulta numa freq. de 1.193180MHz vai para todos os contadores do PIT
temporizador 1 vai para pedido DMA canal 0, atualização de memória
> (aos slots)
transceiver <<>> se em dma (A->B, ex. MEMR <- XMEMR) normalmente (B->A, ex. MEMR -> XMEMR) (se em dma o BUS CTRL tem de se afastar de MEMRx, IOWx, etc)
presa 4x4 bits; guarda as páginas para cada canal DMA; se a flag de acesso I/O "WRTDMAPGREG" escreve em A16:A19, a página respetiva ao número em XA0:1 vinda de XD0:4 se em DMA "~DMAEN~", a página é exposta em A16:19 (no bus sistema)
presa de 8 bits; prende a "parte meia" do endereço (configurada no DMA para o canal ativo), passada por XD0:7 com o sinal "ADSTB" pelo controlador de DMA; expõem o endereço A8:15 (no bus de sistema)
ativa o registo para escrever os MSBs do endereço de memória para cada canal
0xC0 apaga ou faz set para (na verdade como clk) ao ff que ativa/inibe todas as NMIs
para expansão bus
este ff, guarda em Q o inibidor da NMI
descodifica endereço base I/O 0h, 20h, 40h, 60h e ativa o respetivo chip DMA,INT,PIT,PPI ou 80h registo de página DMA para escrever MSBs altos, ou A0h o ff para inibir/permitir as NMI
desde NPU
erro dispositivo (IOCHK lógica positiva)
desde slots, o dispositiivo tem de a pushar a zero se erro (na notação original este sinal está sem traço)
desde PPI (jumpers)
desde PPI
Alimentação tb vai à parte para a placa de expansão
dados/endereço multiplexado: parte baixa AD0:7
multiplexa o endereço para o endereço linha ou coluna É IMPORTANTE que XA0:7 seja o endereço RAS, porque o DMA roda o endereço baixo XA0:7 para atualização de memória
fachada com bus CPU <-> bus sistema ----------------------------------------- * ALE (desde controlador de bus) prende o endereço multiplexado nas presas e expõem ao bus de sistema * AENBRD (desde GEN SINALS) deixa em alta impedância os transceivers e presas com o CPU, para separâ-lo do bus de siste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
transceiver de dados desde/para a memória
buffer >>
> (para slots)
presa do endereço baixo
transceiver <<>>
CLK é CLK88 buffered
PC7: retirado PCK
Não permitir DMA em I/O que nao tenha (~AEN~=1 se dma não ativo)
6 e 7 são a ROM0 e ROM1 de 32KB
dma ativo (I/O que não faz DMA, afastar)
dma NÃO ativo (I/O sem DMA pode descodificar)
AEN=0 (slots) ~AEN=1 AENBRD=0 ~DMAEN=1
INICIO do CICLO BUS
ALE=1
No XT, existe um slot especial o 8, que leva ~YMEMW~, ~YMEMR~ e o restante XBUS
| | | | | | | |
para controlador bus e gerador de sinais dma >>
2ª parte não usada
flip flop ~SR~ com portas NAND (~IOCHK~, ~ENIOCHK~)
modificação REV2
não iniciar DMA se se está a configurar o controlador
modificação rev. 2
antes uma delay line e anti colisão 2 resistências
modificação rev. 2
para ~IOR/W, são aproveitadas as linhas livres de U32 (chipselect + ~IOR/W~)
aqui KBDATA por jumper (e usando um driver 75477) (saída c\ omplemento) pode ser conduzida por porta do PPI
opcao teclado
canal 0 e canal 1 partilham o mesmo registo
CLK88 (buffered)
~RESET~ (buffered)
esta modificações se calhar usar um 74S00
escolhe a coluna de módulos <DRAM_MODHI, DRAM_MODLO> 0: 256KB 1: 256KB 2:64KB 3:64KB
indica se o endereço pertence à região destinada para à DRAM < 640KB
estas linhas são ligadas à mão ex. IRQ8 ao RTC, IRQ14 ao disco, IRQ9 não está ligado e mapeado para IRQ2 (para compatibilidade com placas antigas)
dummy
aqui é um NAND OPEN COLETOR e falta um pullup 4.7K
transceiver<<>>
ligado com DATABUS_EN DATABUS_DIR=0 (leitura) <-- DATABUS_DIR=1 (escrita) -->
ligado normalmente (NÃO DMA) normalmente no sentido de escrita (D->XD) =0 (A<-B, leitura D<-XD) se <se leitura de integrado I/O> ou <ROM> ou <Envio ao cpu do vetor de interrupção> =1 caso contrário fica para (A->B, escrita D->XD)
~XMEMR~=0 , A<-B leitura ~XMEMR~=1 , A->B escrita
ligado se endereço é da RAM
ESTE NOT FOI TIRADO ESTAVA ERRADO!
OS PINOS ESTÃO ERRADOS - A CORRIGIR TAP3 60ns = pino 10 TAP5 100ns = pino 8
atenção o sinal RAS acontece mesmo nos acessos ROM, mas MODHI nesses casos desativa as linhas ~RASi
inserir WAITSTATE SE....
apenas ~CAS~ se leitura/escrita de memória ou DMA (este sinal só é USADO se NÃO /DACK0)
tem duty 50% igual a PCLK
isto foi uma modificação à ultima da hora, porque aloquei o RTC em 70h (antes o PPI estava a consumir 6xh e 7xh)!
se em atualização todas as linhas /RASi são selecionadas
---------------------------
aqui foi mudado para permitir que I/O integrado se refira apenas 00, 20, 40, etc e outras portas entre meio possam ser descodificadas por exemplo 70h (RTC) numa placa caso o switch esteja no outro lado, a placa descodifica todo o endereços IO de [0:0x100[
AEN=1 (slots) ~AEN=0 AENBRD=1 ~DMAEN=0
buffer A >> XA (quando DMA NÃO está em transferência)
estes buffers sao mutualmente exclusivos
buffer XA >> A (quando DMA está em transferência)
SEMPRE SE IOCHRDY=0
INSERIR se uma transferencia DMA de leitura mas não para atualização de memória
ou INSERIR se for um acesso I/O
este vai sincronizar com /RDY o qual fará o CPU inserir WAITSTATE.
há RESET assim que /WAIT
a ZERO para alguma NMI
se ff ativo deixa passar a NMI
temporizador 0 é usado pelo DOS para definir hora/data
temporizador 2 para o speaker

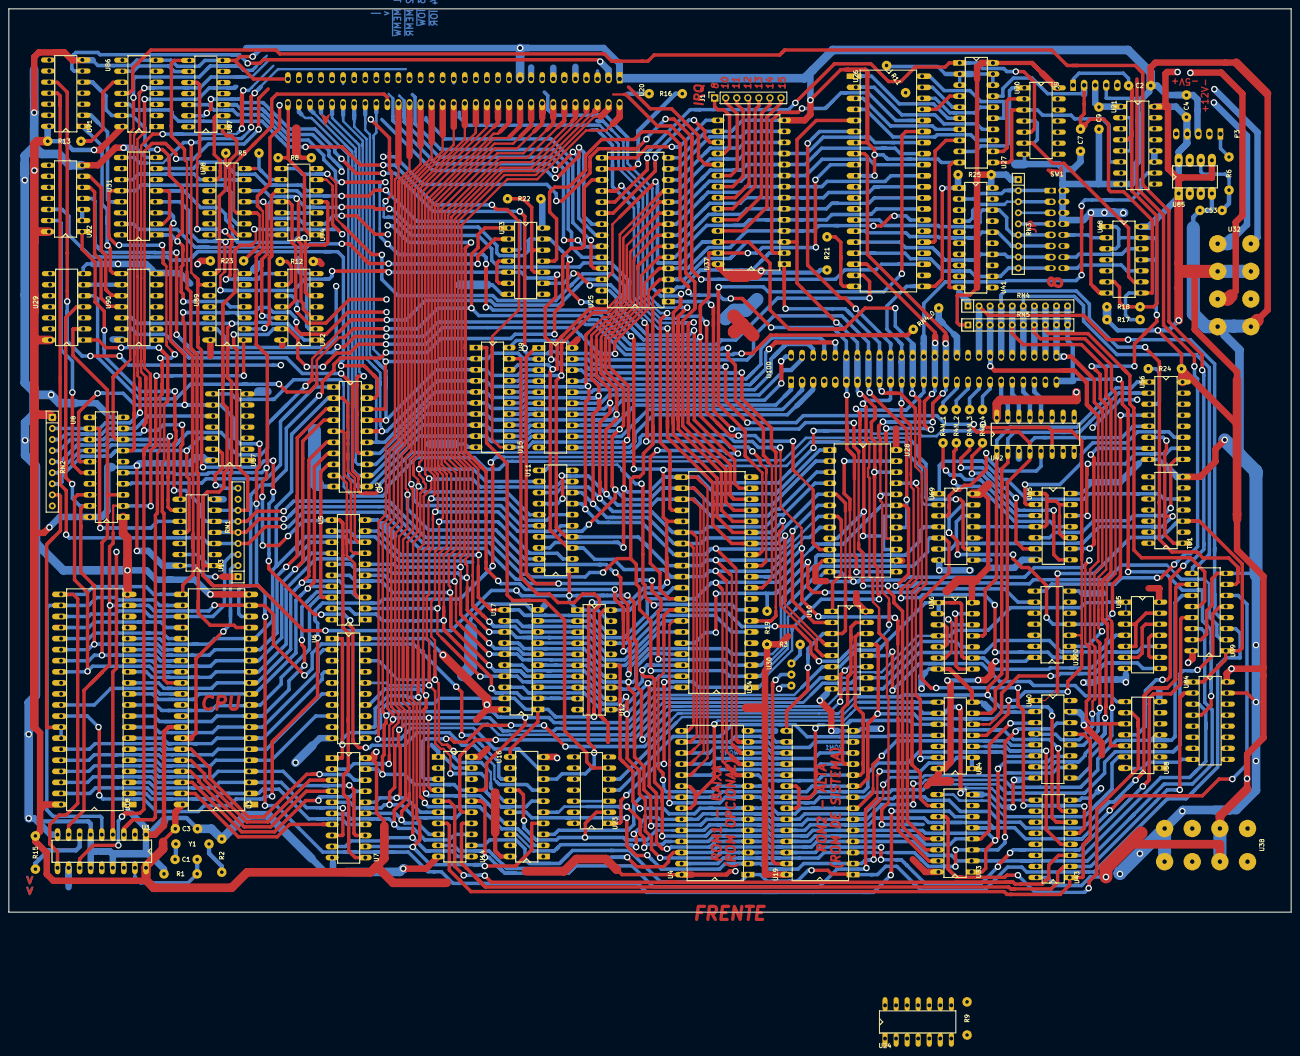
[picture p7: board xt.kicad_pcb from above]

Board: 2 copper layers, 294.5 x 207.5 mm, 107 parts (0 on the bottom side), 307 nets.

Other parts of the board:
U24#2: 74LS00; standard_DIP_14OvalPins
U33: 74LS138; standard_DIP_16OvalPins

Their connections:
/5V: U24#2.14, U33.16; also elsewhere on the board
/ROMCS: U24#2.8; also elsewhere on the board
/XA5: U33.1; also elsewhere on the board
/XA6: U33.2; also elsewhere on the board
/XA7: U33.3; also elsewhere on the board
/XA8: U33.4; also elsewhere on the board
/XA9: U33.5; also elsewhere on the board
/XA18: U24#2.1, U24#2.2; also elsewhere on the board
/~AEN: U33.6; also elsewhere on the board
/~DACK0BRD: U24#2.4; also elsewhere on the board
/~DMACS: U33.15; also elsewhere on the board
/~INTA: U24#2.12, U24#2.13; also elsewhere on the board
/~PIC0CS: U33.14; also elsewhere on the board
/~PIC1CS: U33.10; also elsewhere on the board
/~RAMADDRSEL: U24#2.6; also elsewhere on the board
/~ROMCS0: U24#2.9; also elsewhere on the board
/~ROMCS1: U24#2.10; also elsewhere on the board
/~TCCS: U33.13; also elsewhere on the board
Earth: U24#2.7, U33.8; also elsewhere on the board
unnamed 302: U24#2.11; also elsewhere on the board
unnamed 305: U24#2.3; also elsewhere on the board
unnamed 306: U24#2.5; also elsewhere on the board
unnamed 318: U33.9; also elsewhere on the board
unnamed 319: U33.11; also elsewhere on the board
unnamed 320: U33.12; also elsewhere on the board
