woreno/IBM-PC-XT-compatible/KICAD/ports/ports.kicad_pcb

## KiCad design KICAD/ports/ports.kicad_pcb (2026-11-09)

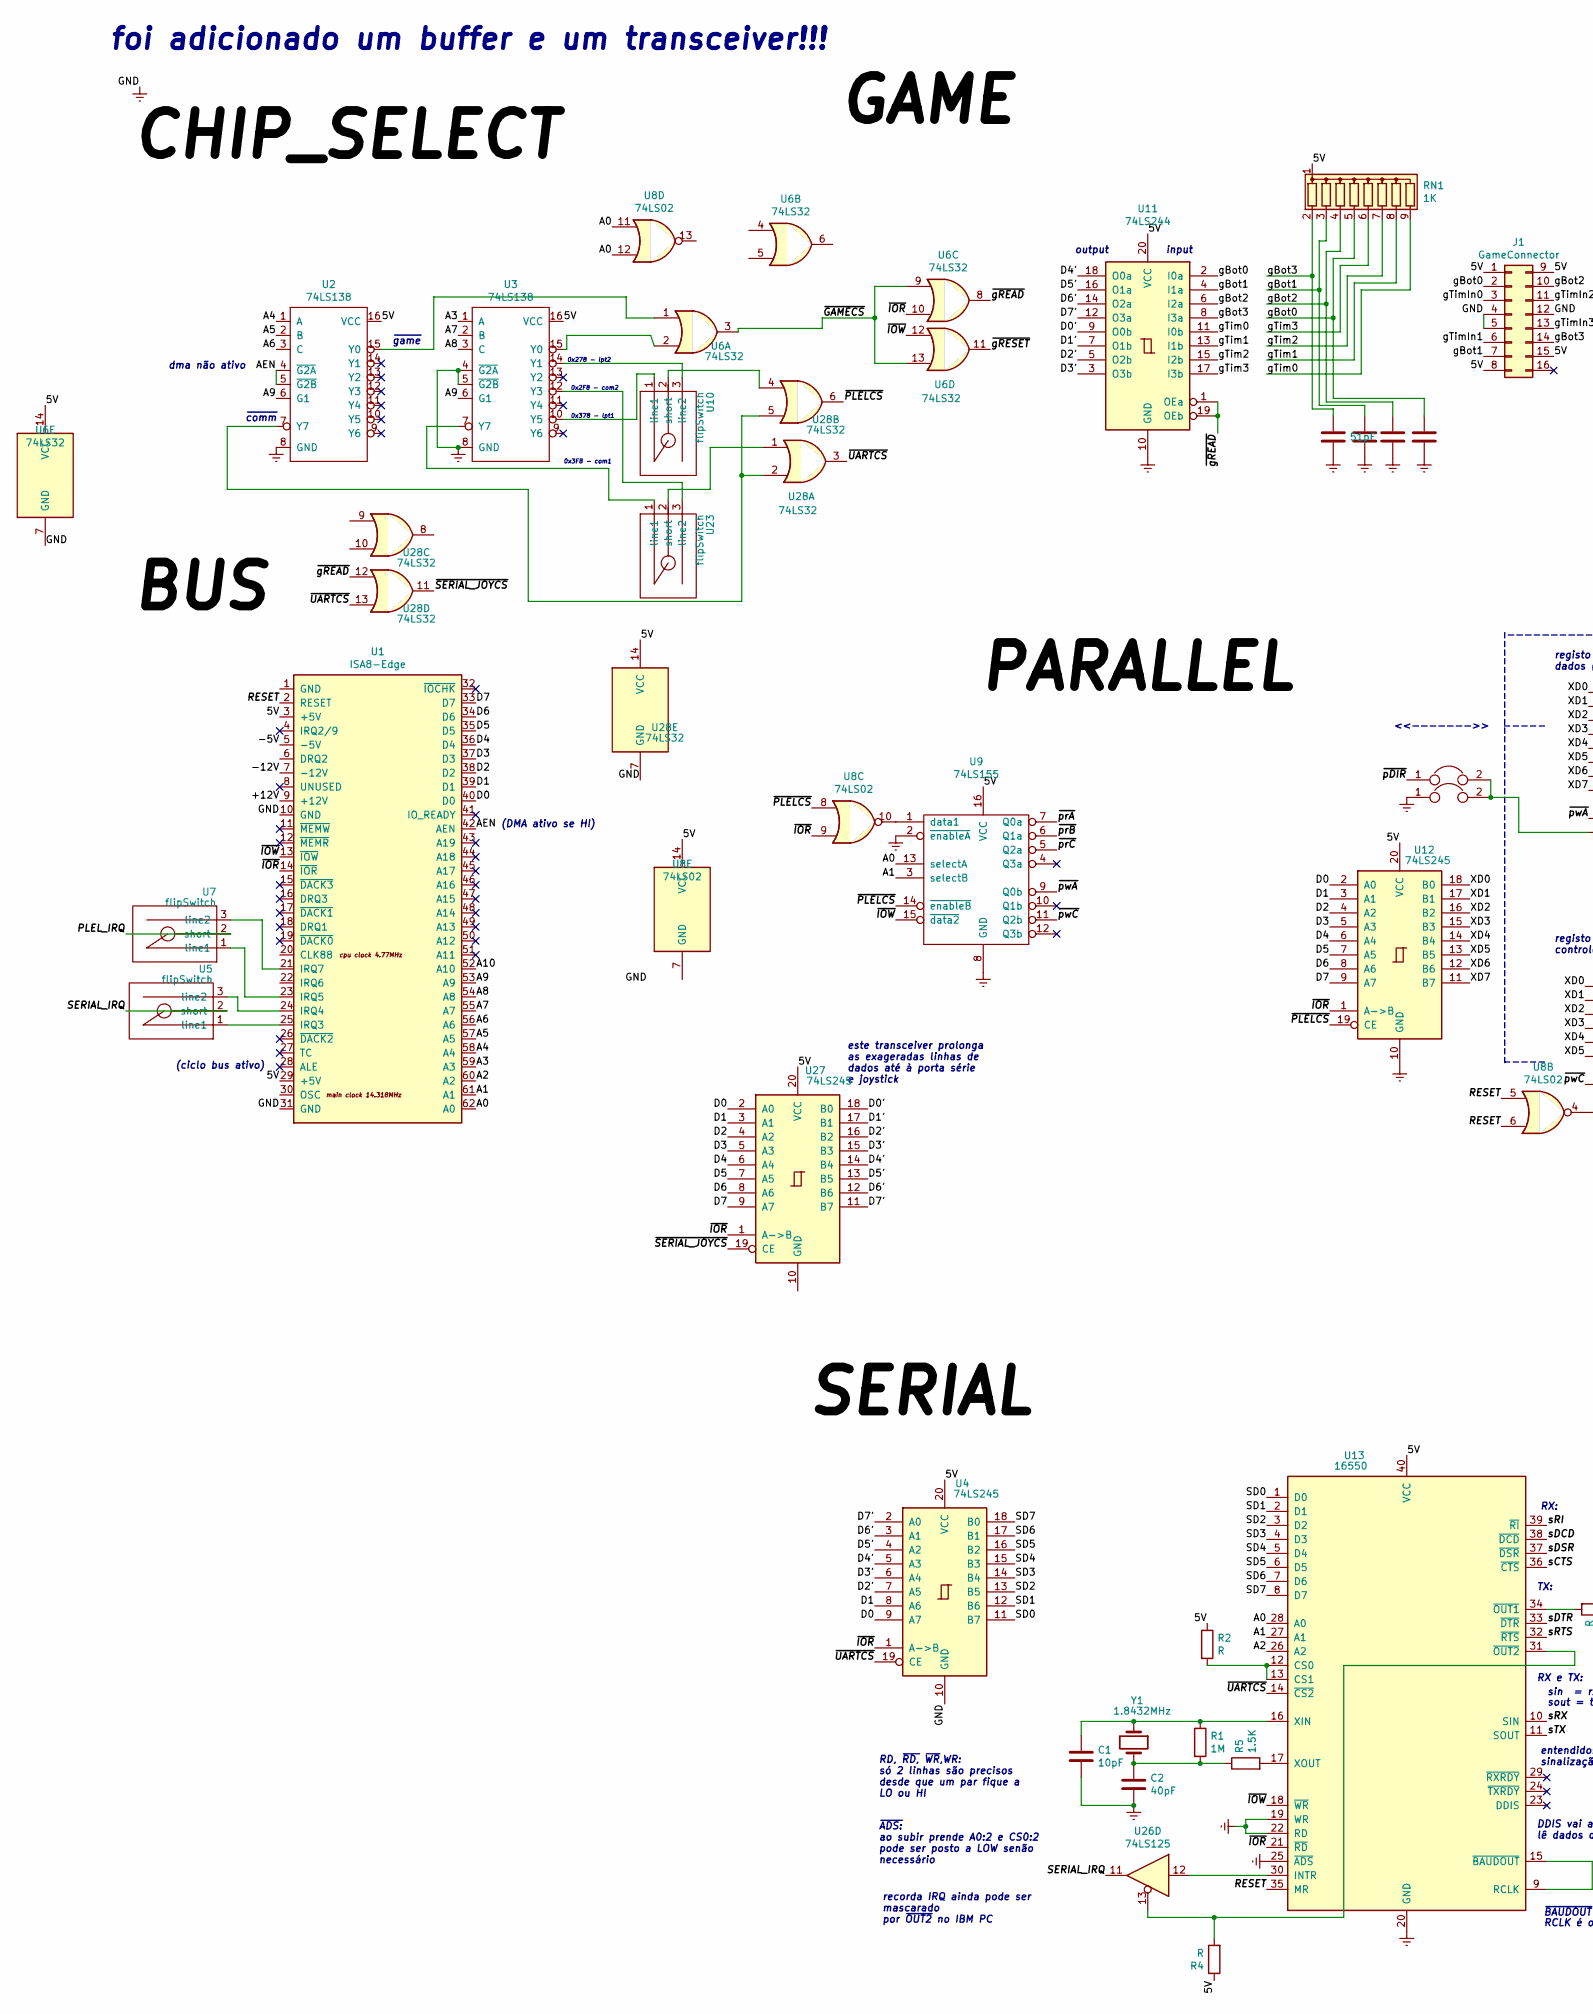
[picture p8: schematic ports.sch, part in row 1, column 1]

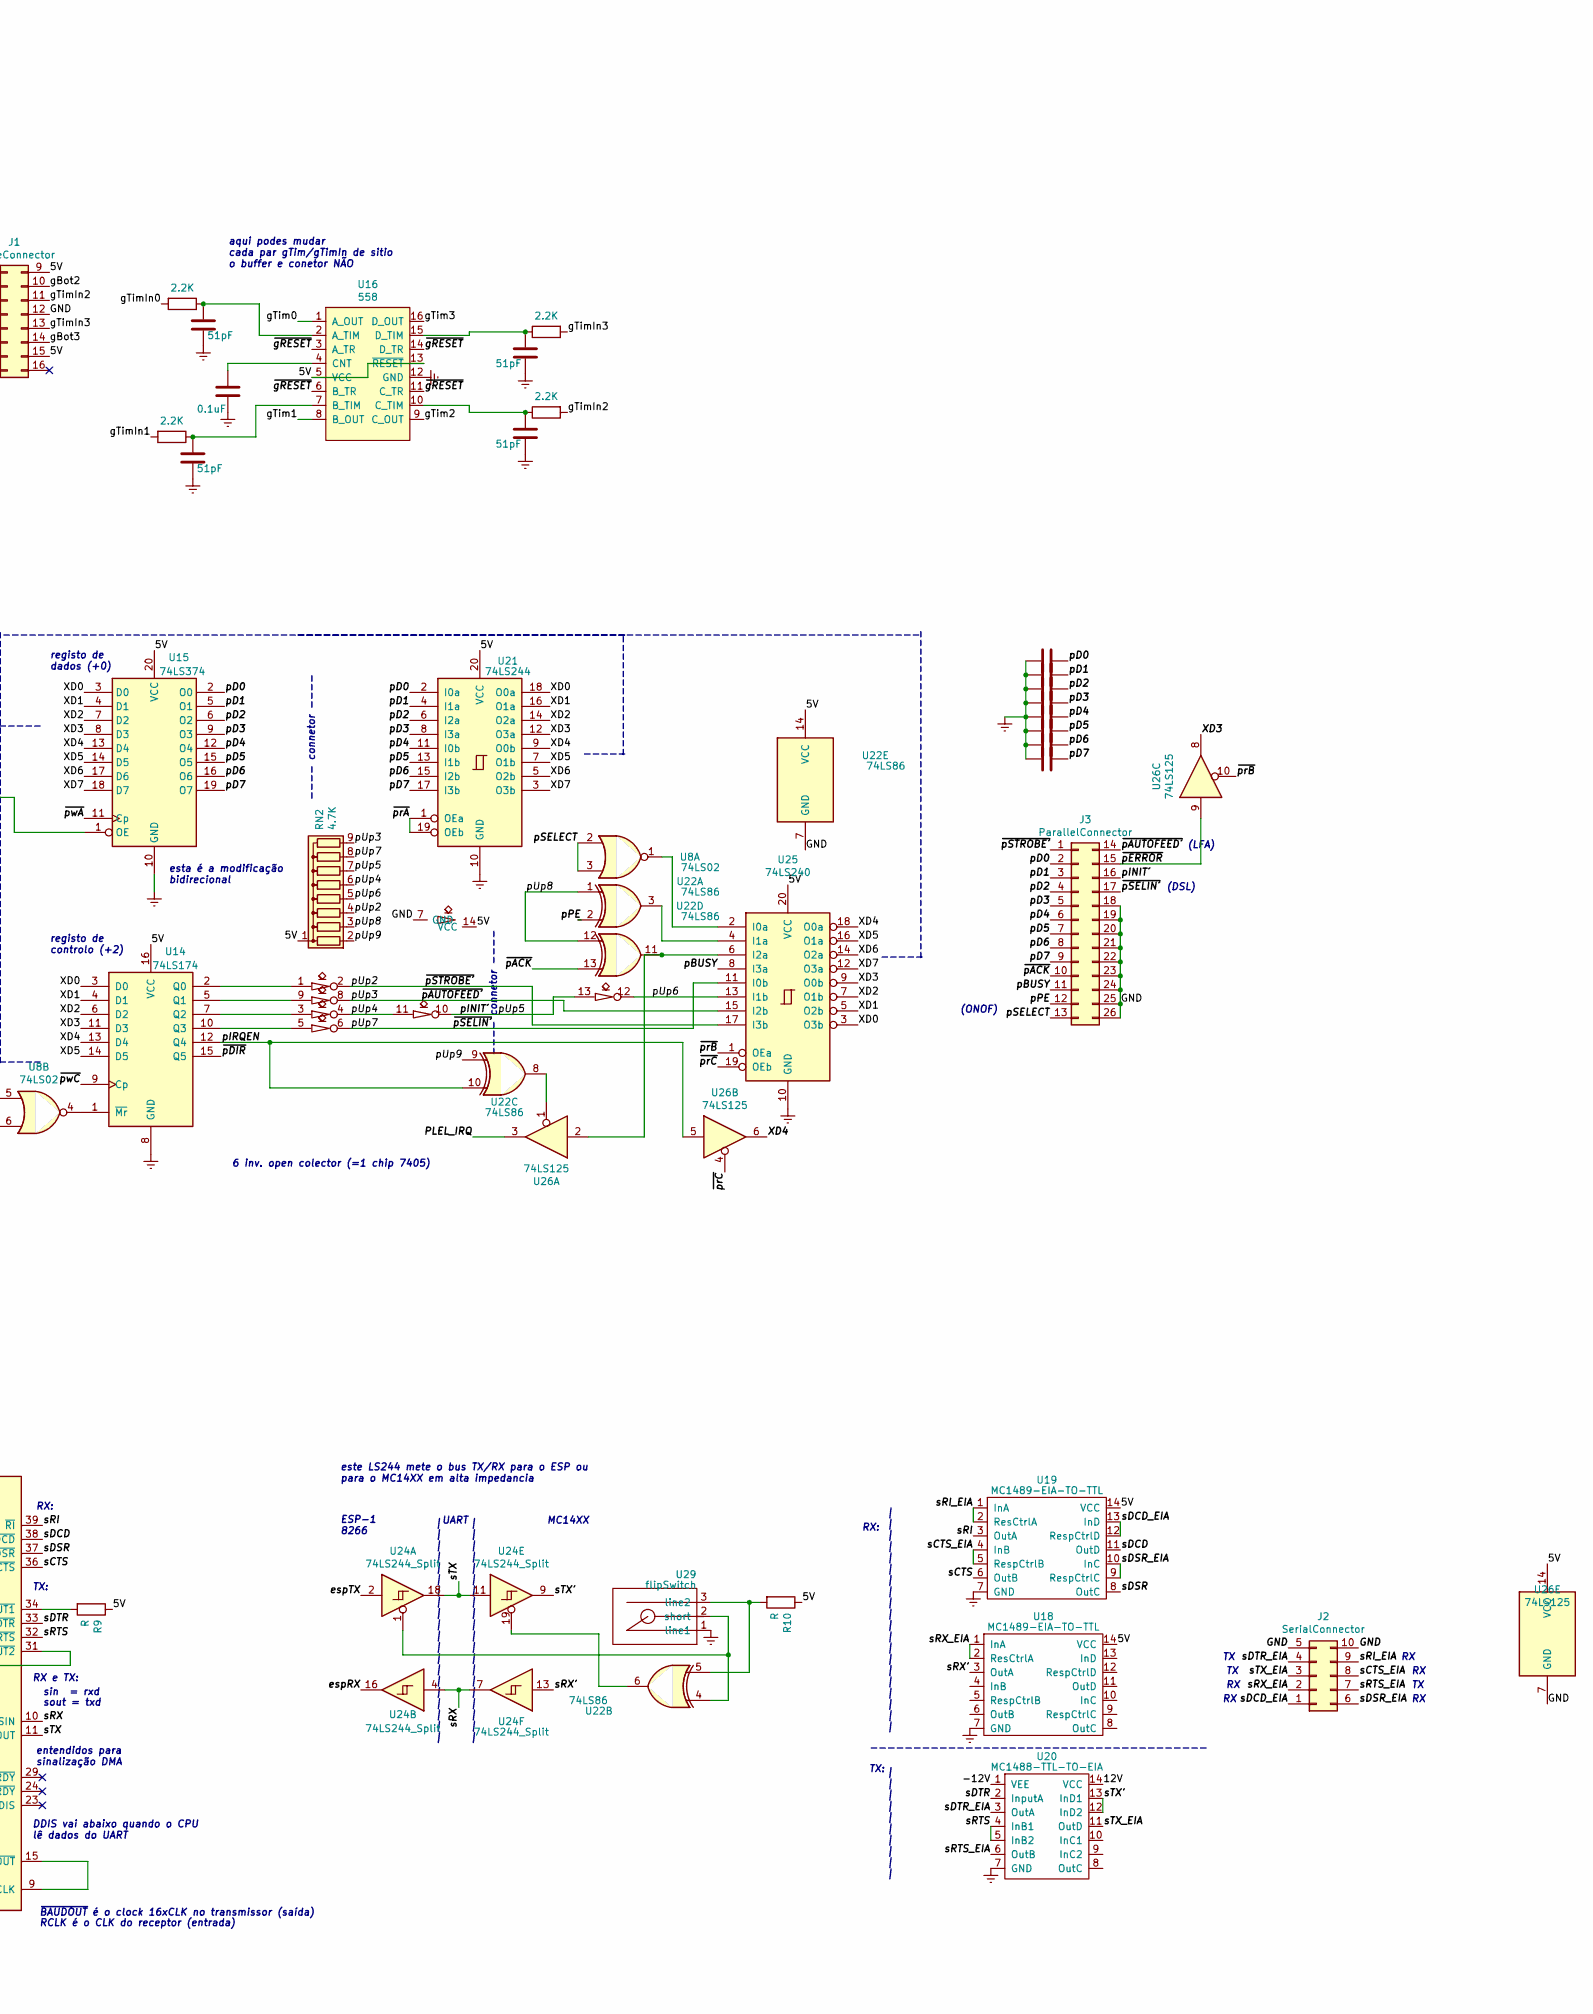
[picture p9: schematic ports.sch, part in row 1, column 2]

Parts:
C1: 10pF; standard_2pins_half
C2: 40pF; standard_2pins
C3, C4, C5, C8, C10, C12, C14, C15: C; standard_2pins
C6: 51pF; standard_2pins
C7: 0.1uF; standard_2pins_half
C9, C11, C13: C; standard_2pins_half
C16, C17, C18, C19: 51pF; standard_2pins_half
J1: GameConnector; Conector2x8_Oval_updown
J2: SerialConnector; Conector2x5_Oval_downup
J3: ParallelConnector; Conector2x13_Oval_updown
JP5, JP6: Jumper; jumper_set_1
R1: 1M; standard_2pins
R2, R4, R9, R10: R; standard_2pins
R3, R6, R7, R8: 2.2K; standard_2pins
R5: 1.5K; standard_2pins
RN1: 1K; R_Array_SIP9
RN2: 4.7K; R_Array_SIP9
U1: ISA8-Edge; ISA_8bit_edge
U2, U3: 74LS138; standard_DIP_16OvalPins
U4, U12, U27: 74LS245; standard_DIP_20pins_thin_body
U5, U7, U10, U23, U29: flipSwitch; mini_flipswitch2.54
U6, U28: 74LS32; standard_DIP_14OvalPins
U8: 74LS02; standard_DIP_14OvalPins
U9: 74LS155; standard_DIP_16OvalPins
U11, U21: 74LS244; standard_DIP_20pins_thin_body
U13: 16550; standard_DIP_40pins_doubleBody_thinpins
U14: 74LS174; standard_DIP_16OvalPins
U15: 74LS374; standard_DIP_20pins_thin_body
U16: 558; standard_DIP_16OvalPins
U17: 7405; standard_DIP_14OvalPins
U18, U19: MC1489-EIA-TO-TTL; standard_DIP_14OvalPins
U20: MC1488-TTL-TO-EIA; standard_DIP_14OvalPins
U22: 74LS86; standard_DIP_14OvalPins
U24: 74LS244_Split; standard_DIP_20pins_thin_body
U25: 74LS240; standard_DIP_20pins_thin_body
U26: 74LS125; standard_DIP_14OvalPins
Y1: 1.8432MHz; standard_2pins

Connections:
/5V: J1.1, J1.8, J1.9, J1.15, R2.1, R4.1, R9.1, R10.1, RN1.1 (common), RN2.1 (common), U1.3 (+5V), U1.29 (+5V), U2.16 (VCC), U3.16 (VCC), U4.20 (VCC), U6.14 (VCC), U8.14 (VCC), U9.16 (VCC), U11.20 (VCC), U12.20 (VCC), U13.40 (VCC), U14.16 (VCC), U15.20 (VCC), U16.5 (VCC), U16.13 (~RESET), U17.14 (VCC), U18.14 (VCC), U19.14 (VCC), U21.20 (VCC), U22.14 (VCC), U25.20 (VCC), U26.14 (VCC), U27.20 (VCC), U28.14 (VCC)
/12V: U20.14 (VCC)
/+12V: U1.9 (+12V)
/-5V: U1.5 (-5V)
/-12V: U1.7 (-12V), U20.1 (VEE)
/A0: U1.62 (A0), U8.11, U8.12, U9.13 (selectA), U13.28 (A0)
/A1: U1.61 (A1), U9.3 (selectB), U13.27 (A1)
/A2: U1.60 (A2), U13.26 (A2)
/A3: U1.59 (A3), U3.1 (A)
/A4: U1.58 (A4), U2.1 (A)
/A5: U1.57 (A5), U2.2 (B)
/A6: U1.56 (A6), U2.3 (C)
/A7: U1.55 (A7), U3.2 (B)
/A8: U1.54 (A8), U3.3 (C)
/A9: U1.53 (A9), U2.6 (G1), U3.6 (G1)
/A10: U1.52 (A10)
/AEN: U1.42 (AEN), U2.4 (~G2A), U2.5 (~G2B)
/D0: U1.40 (D0), U4.9 (A7), U12.2 (A0), U27.2 (A0)
/D0': U11.9 (O0b), U27.18 (B0)
/D1: U1.39 (D1), U4.8 (A6), U12.3 (A1), U27.3 (A1)
/D1': U11.7 (O1b), U27.17 (B1)
/D2: U1.38 (D2), U12.4 (A2), U27.4 (A2)
/D2': U4.7 (A5), U11.5 (O2b), U27.16 (B2)
/D3: U1.37 (D3), U12.5 (A3), U27.5 (A3)
/D3': U4.6 (A4), U11.3 (O3b), U27.15 (B3)
/D4: U1.36 (D4), U12.6 (A4), U27.6 (A4)
/D4': U4.5 (A3), U11.18 (O0a), U27.14 (B4)
/D5: U1.35 (D5), U12.7 (A5), U27.7 (A5)
/D5': U4.4 (A2), U11.16 (O1a), U27.13 (B5)
/D6: U1.34 (D6), U12.8 (A6), U27.8 (A6)
/D6': U4.3 (A1), U11.14 (O2a), U27.12 (B6)
/D7: U1.33 (D7), U12.9 (A7), U27.9 (A7)
/D7': U4.2 (A0), U11.12 (O3a), U27.11 (B7)
/PLEL_IRQ: U7.2 (short), U26.3
/RESET: U1.2 (RESET), U8.5, U8.6, U13.35 (MR)
/SD0: U4.11 (B7), U13.1 (D0)
/SD1: U4.12 (B6), U13.2 (D1)
/SD2: U4.13 (B5), U13.3 (D2)
/SD3: U4.14 (B4), U13.4 (D3)
/SD4: U4.15 (B3), U13.5 (D4)
/SD5: U4.16 (B2), U13.6 (D5)
/SD6: U4.17 (B1), U13.7 (D6)
/SD7: U4.18 (B0), U13.8 (D7)
/SERIAL_IRQ: U5.2 (short), U26.11
/XD0: U12.18 (B0), U14.3 (D0), U15.3 (D0), U21.18 (O0a), U25.3 (O3b)
/XD1: U12.17 (B1), U14.4 (D1), U15.4 (D1), U21.16 (O1a), U25.5 (O2b)
/XD2: U12.16 (B2), U14.6 (D2), U15.7 (D2), U21.14 (O2a), U25.7 (O1b)
/XD3: U12.15 (B3), U14.11 (D3), U15.8 (D3), U21.12 (O3a), U25.9 (O0b), U26.8
/XD4: U12.14 (B4), U14.13 (D4), U15.13 (D4), U21.9 (O0b), U25.18 (O0a), U26.6
/XD5: U12.13 (B5), U14.14 (D5), U15.14 (D5), U21.7 (O1b), U25.16 (O1a)
/XD6: U12.12 (B6), U15.17 (D6), U21.5 (O2b), U25.14 (O2a)
/XD7: U12.11 (B7), U15.18 (D7), U21.3 (O3b), U25.12 (O3a)
/espRX: U24.16
/espTX: U24.2
/gBot0: C3.1, J1.2, RN1.5 (R4), U11.2 (I0a)
/gBot1: C4.1, J1.7, RN1.3 (R2), U11.4 (I1a)
/gBot2: C5.1, J1.10, RN1.4 (R3), U11.6 (I2a)
/gBot3: C6.1, J1.14, RN1.2 (R1), U11.8 (I3a)
/gTim0: RN1.9 (R8), U11.11 (I0b), U16.1 (A_OUT)
/gTim1: RN1.8 (R7), U11.13 (I1b), U16.8 (B_OUT)
/gTim2: RN1.7 (R6), U11.15 (I2b), U16.9 (C_OUT)
/gTim3: RN1.6 (R5), U11.17 (I3b), U16.16 (D_OUT)
/gTimIn0: J1.3, R6.2
/gTimIn1: J1.6, R3.2
/gTimIn2: J1.11, R8.2
/gTimIn3: J1.13, R7.2
/pBUSY: J3.11, U25.8 (I3a)
/pD0: C8.2, J3.2, U15.2 (O0), U21.2 (I0a)
/pD1: C9.2, J3.3, U15.5 (O1), U21.4 (I1a)
/pD2: C10.2, J3.4, U15.6 (O2), U21.6 (I2a)
/pD3: C11.2, J3.5, U15.9 (O3), U21.8 (I3a)
/pD4: C12.2, J3.6, U15.12 (O4), U21.11 (I0b)
/pD5: C13.2, J3.7, U15.15 (O5), U21.13 (I1b)
/pD6: C14.2, J3.8, U15.16 (O6), U21.15 (I2b)
/pD7: C15.2, J3.9, U15.19 (O7), U21.17 (I3b)
/pINIT´: J3.16, RN2.7 (R6), U17.10, U17.13
/pIRQEN: U14.12 (Q4), U22.10, U26.5
/pPE: J3.12, U22.2
/pSELECT: J3.13, U8.2, U8.3
/pUp2: J3.1, RN2.4 (R3), U17.2, U25.17 (I3b)
/pUp3: J3.14, RN2.9 (R8), U17.8, U25.15 (I2b)
/pUp4: RN2.6 (R5), U17.4, U17.11
/pUp6: RN2.5 (R4), U17.12, U25.13 (I1b)
/pUp7: J3.17, RN2.8 (R7), U17.6, U25.11 (I0b)
/pUp8: RN2.3 (R2), U22.1, U22.12
/pUp9: RN2.2 (R1), U22.9
/sCTS: U13.36 (~CTS~), U19.6 (OutB)
/sCTS_EIA: J2.8, U19.4 (InB), U19.5 (RespCtrlB)
/sDCD: U13.38 (~DCD~), U19.11 (OutD)
/sDCD_EIA: J2.1, U19.12 (RespCtrlD), U19.13 (InD)
/sDSR: U13.37 (~DSR~), U19.8 (OutC)
/sDSR_EIA: J2.6, U19.9 (RespCtrlC), U19.10 (InC)
/sDTR: U13.33 (~DTR~), U20.2 (InputA)
/sDTR_EIA: J2.4, U20.3 (OutA)
/sRI: U13.39 (~RI~), U19.3 (OutA)
/sRI_EIA: J2.9, U19.1 (InA), U19.2 (ResCtrlA)
/sRTS: U13.32 (~RTS~), U20.4 (InB1), U20.5 (InB2)
/sRTS_EIA: J2.7, U20.6 (OutB)
/sRX: U13.10 (SIN), U24.4, U24.7
/sRX': U18.3 (OutA), U24.13
/sRX_EIA: J2.2, U18.1 (InA), U18.2 (ResCtrlA)
/sTX: U13.11 (SOUT), U24.11, U24.18
/sTX': U20.12 (InD2), U20.13 (InD1), U24.9
/sTX_EIA: J2.3, U20.11 (OutD)
/~GAMECS: U6.3, U6.9, U6.13
/~IOR: U1.14 (~IOR), U4.1 (A->B), U6.10, U8.9, U12.1 (A->B), U13.21 (~RD~), U27.1 (A->B)
/~IOW: U1.13 (~IOW), U6.12, U9.15 (~data2), U13.18 (~WR~)
/~PLELCS: U8.8, U9.14 (~enableB), U12.19 (CE), U28.6
/~SERIAL_JOYCS: U27.19 (CE), U28.11
/~UARTCS: U4.19 (CE), U13.14 (~CS2~), U28.3, U28.13
/~gREAD: U6.8, U11.1 (OEa), U11.19 (OEb), U28.12
/~gRESET: U6.11, U16.3 (A_TR), U16.6 (B_TR), U16.11 (C_TR), U16.14 (D_TR)
/~pACK: J3.10, U22.13
/~pDIR: JP5.1, U14.15 (Q5)
/~pERROR: J3.15, U26.9
/~prA: U9.7 (Q0a), U21.1 (OEa), U21.19 (OEb)
/~prB: U9.6 (Q1a), U25.1 (OEa), U26.10
/~prC: U9.5 (Q2a), U25.19 (OEb), U26.4
/~pwA: U9.9 (Q0b), U15.11 (Cp)
/~pwC: U9.11 (Q2b), U14.9 (Cp)
Earth: C1.2, C2.2, C3.2, C4.2, C5.2, C6.2, C7.2, C8.1, C9.1, C10.1, C11.1, C12.1, C13.1, C14.1, C15.1, C16.2, C17.2, C18.2, C19.2, J1.4, J1.5, J1.12, J2.5, J2.10, J3.18, J3.19, J3.20, J3.21, J3.22, J3.23, J3.24, J3.25, J3.26, JP6.1, U1.10 (GND), U1.31 (GND), U2.8 (GND), U3.4 (~G2A), U3.5 (~G2B), U3.8 (GND), U4.10 (GND), U6.7 (GND), U9.2 (~enableA), U9.8 (GND), U11.10 (GND), U12.10 (GND), U13.19 (WR), U13.20 (GND), U13.22 (RD), U13.25 (~ADS~), U14.8 (GND), U15.10 (GND), U16.12 (GND), U17.7 (GND), U18.7 (GND), U19.7 (GND), U20.7 (GND), U21.10 (GND), U22.7 (GND), U25.10 (GND), U26.7 (GND), U28.7 (GND), U29.1 (line1)
unnamed: C1.1, R1.1, U13.16 (XIN), Y1.1
unnamed: C2.1, R1.2, R5.1, Y1.2
unnamed: C7.1, U16.4 (CNT)
unnamed: C16.1, R3.1, U16.7 (B_TIM)
unnamed: C17.1, R6.1, U16.2 (A_TIM)
unnamed: C18.1, R7.1, U16.15 (D_TIM)
unnamed: C19.1, R8.1, U16.10 (C_TIM)
unnamed: JP5.2, JP6.2, U15.1 (OE)
unnamed: R2.2, U13.12 (CS0), U13.13 (CS1)
unnamed: R4.2, U13.31 (~OUT2~), U26.13
unnamed: R5.2, U13.17 (XOUT)
unnamed: R9.2, U13.34 (~OUT1~)
unnamed: R10.2, U22.5, U29.3 (line2)
unnamed: U1.21 (IRQ7), U7.3 (line2)
unnamed: U1.23 (IRQ5), U7.1 (line1)
unnamed: U1.24 (IRQ4), U5.3 (line2)
unnamed: U1.25 (IRQ3), U5.1 (line1)
unnamed: U2.7 (Y7), U28.2, U28.5
unnamed: U2.15 (Y0), U6.1
unnamed: U3.15 (Y0), U6.2
unnamed: U8.10, U9.1 (data1)
unnamed: U3.10 (Y5), U10.1 (line1)
unnamed: U10.2 (short), U28.4
unnamed: U3.14 (Y1), U10.3 (line2)
unnamed: U13.9 (RCLK), U13.15 (~BAUDOUT~)
unnamed: U13.30 (INTR), U26.12
unnamed: U8.4, U14.1 (~Mr)
unnamed: U14.2 (Q0), U17.1
unnamed: U14.5 (Q1), U17.9
unnamed: U14.7 (Q2), U17.3
unnamed: U14.10 (Q3), U17.5
unnamed: U22.3, U25.4 (I1a)
unnamed: U22.4, U24.1, U29.2 (short)
unnamed: U22.6, U24.19
unnamed: U22.8, U26.1
unnamed: U22.11, U25.6 (I2a), U26.2
unnamed: U3.7 (Y7), U23.1 (line1)
unnamed: U23.2 (short), U28.1
unnamed: U3.12 (Y3), U23.3 (line2)
unnamed: U8.1, U25.2 (I0a)

Notes on the sheet:
RX:
TX:
sout = txd
sin = rxd
~BAUDOUT~ é o clock 16xCLK no transmissor (saída)
RCLK é o CLK do receptor (entrada)
DDIS vai abaixo quando o CPU lê dados do UART
RD, ~RD, ~WR~,WR: só 2 linhas são precisos desde que um par fique a LO ou HI
~ADS:~ ao subir prende A0:2 e CS0:2 pode ser posto a LOW senão necessário
entendidos para sinalização DMA
RX e TX:
| | | | | | | | | | | | | | | | | | | |
| | | | | | | | | |
---------------------------------------
recorda IRQ ainda pode ser mascarado por ~OUT2~ no IBM PC
(DMA ativo se HI)
(ciclo bus ativo)
dma não ativo
~game
~comm
esta é a modificação bidirecional
<<------->>
--------------------------------------------------
-----
---- connetor ----
------------------------------------------------------------------------
--------------
--------------------------------------
(ONOF)
(DSL)
(LFA)
0x3F8 - com1
0x378 - lpt1
0x2F8 - com2
0x278 - lpt2
output
input
aqui podes mudar cada par gTim/gTimIn de sitio o buffer e conetor NÃO
6 inv. open colector (=1 chip 7405)
registo de dados (+0)
registo de controlo (+2)
este LS244 mete o bus TX/RX para o ESP ou para o MC14XX em alta impedancia
MC14XX
UART
ESP-1 8266
este transceiver prolonga as exageradas linhas de dados até à porta série e joystick
foi adicionado um buffer e um transceiver!!!

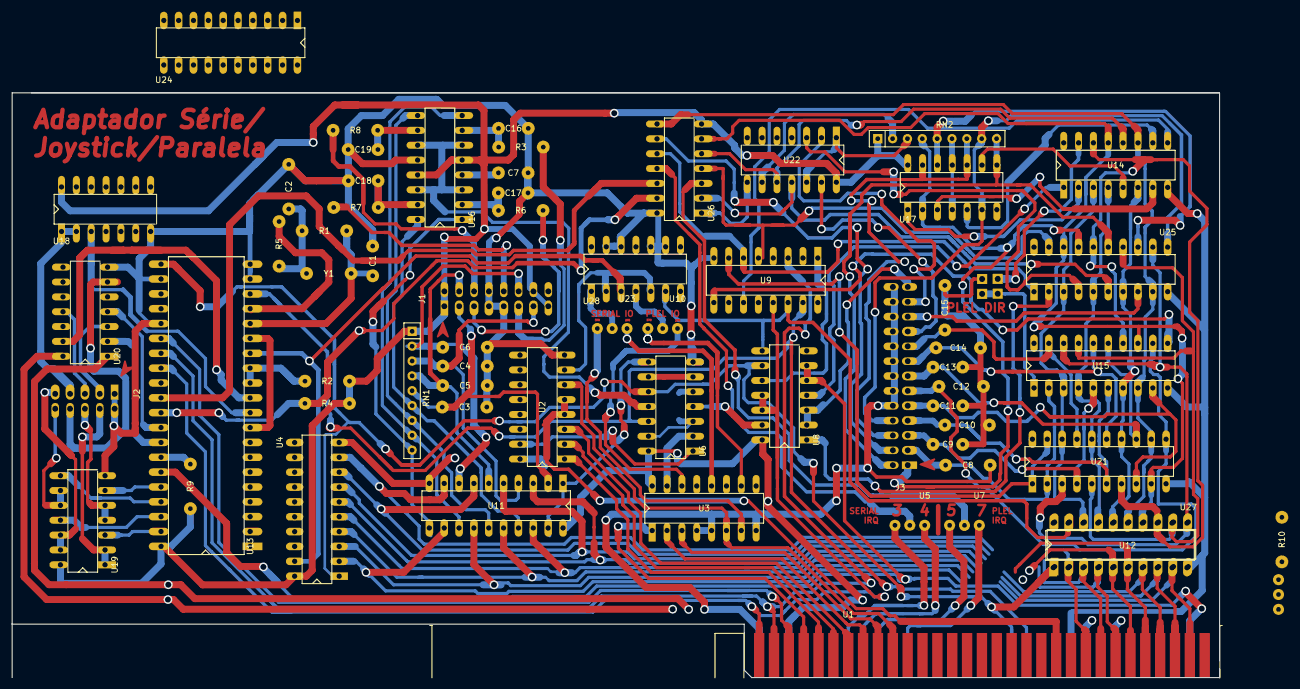
[picture p10: board ports.kicad_pcb from above]

Board: 2 copper layers, 206.5 x 100.0 mm, 66 parts (0 on the bottom side), 155 nets.
