woreno/IBM-PC-XT-compatible/KICAD/cga/cga.kicad_pcb

## KiCad design KICAD/cga/cga.kicad_pcb (2026-11-09)

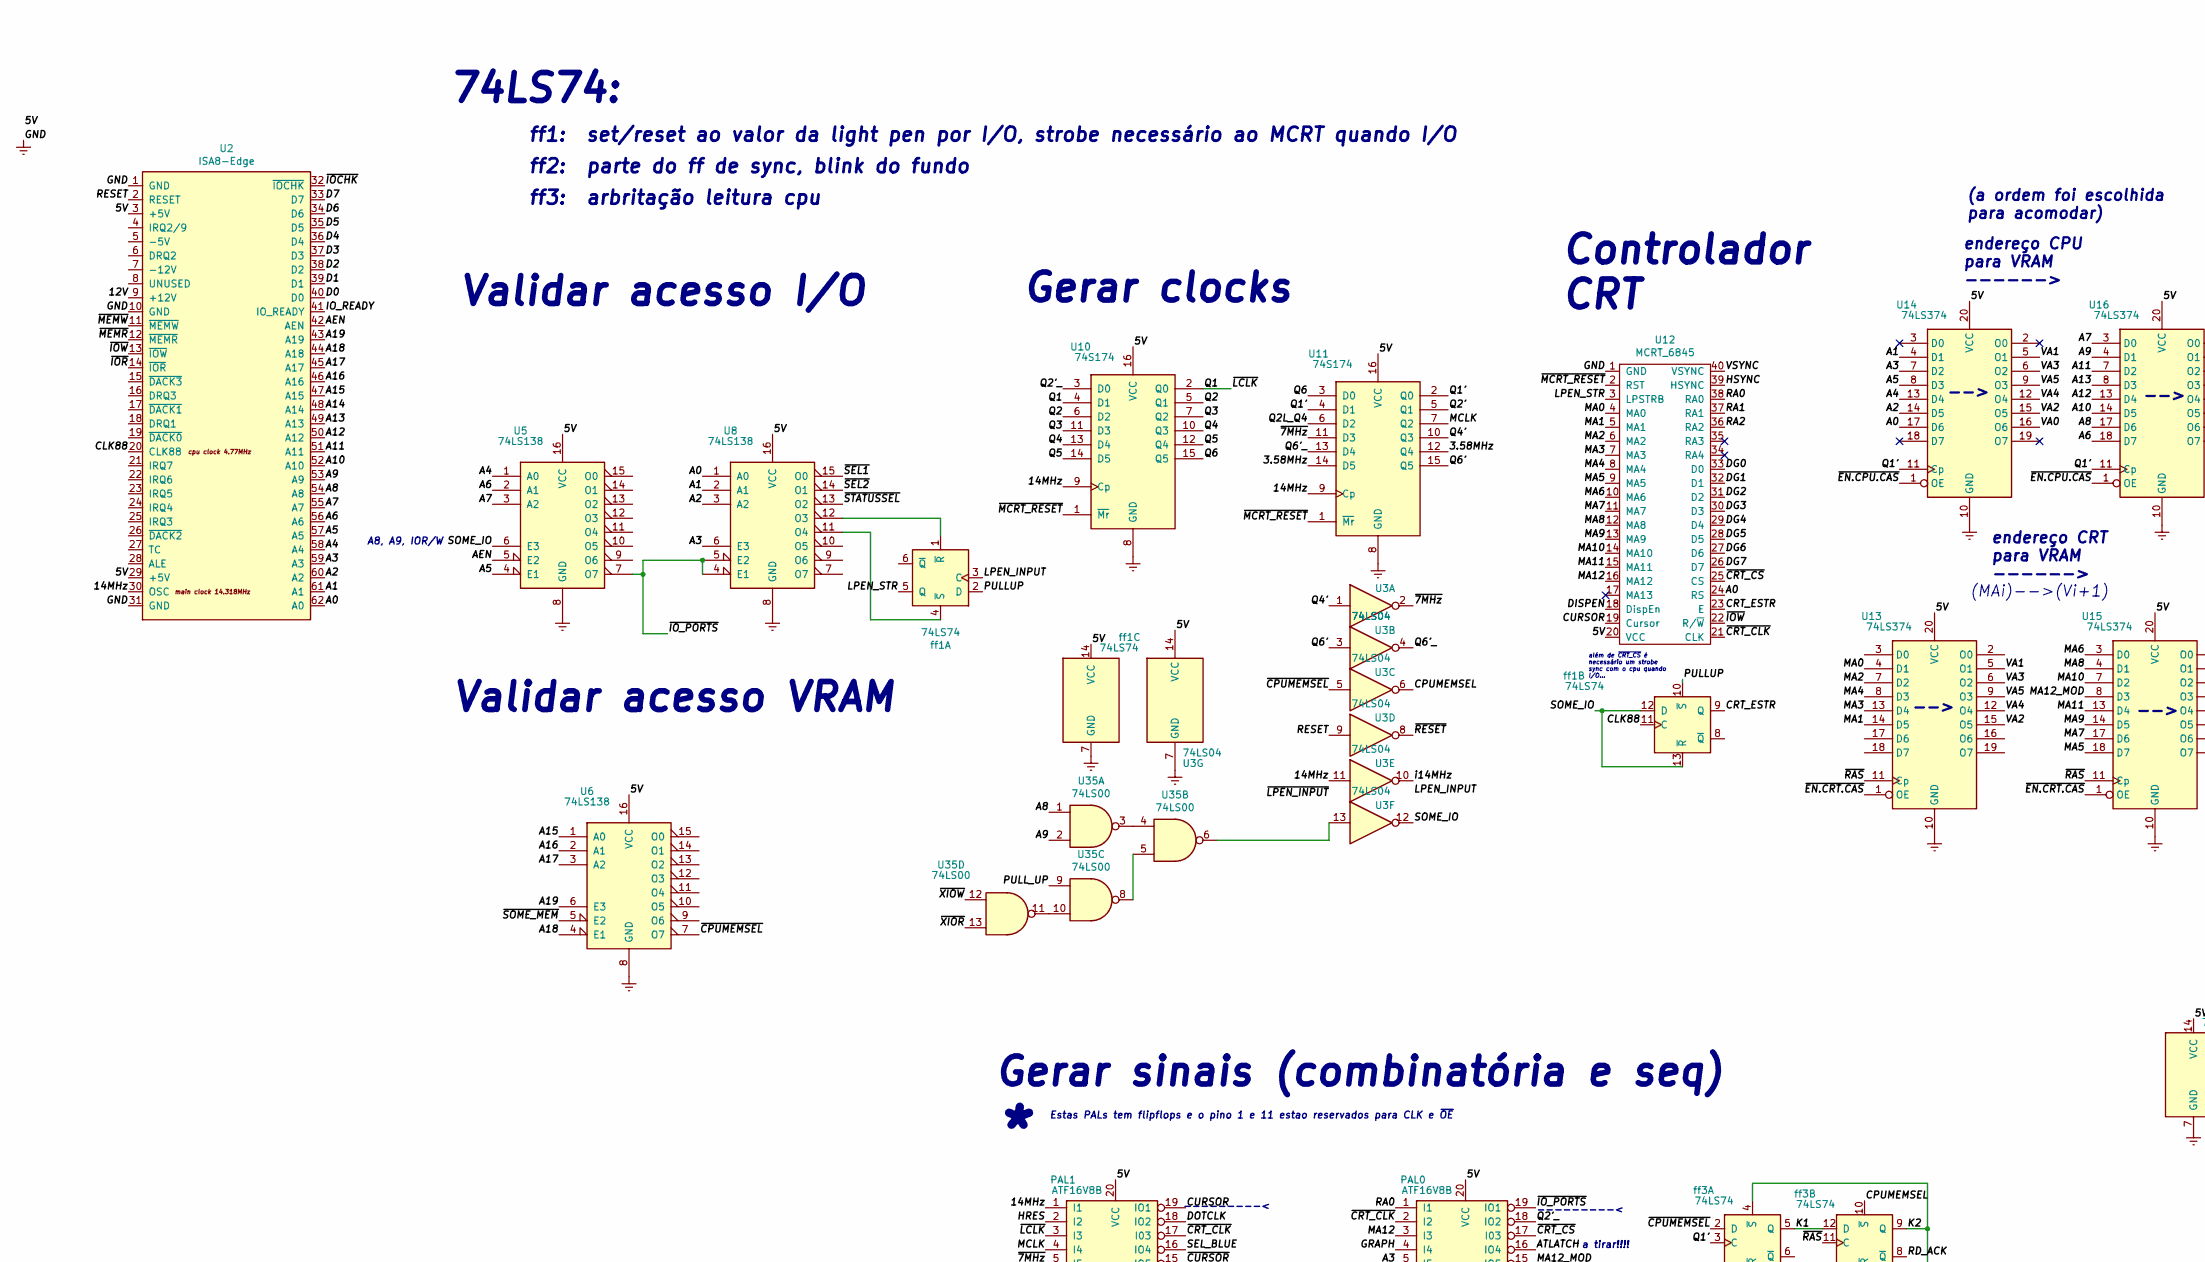
[picture p11: schematic cga.sch, part in row 1, column 1]

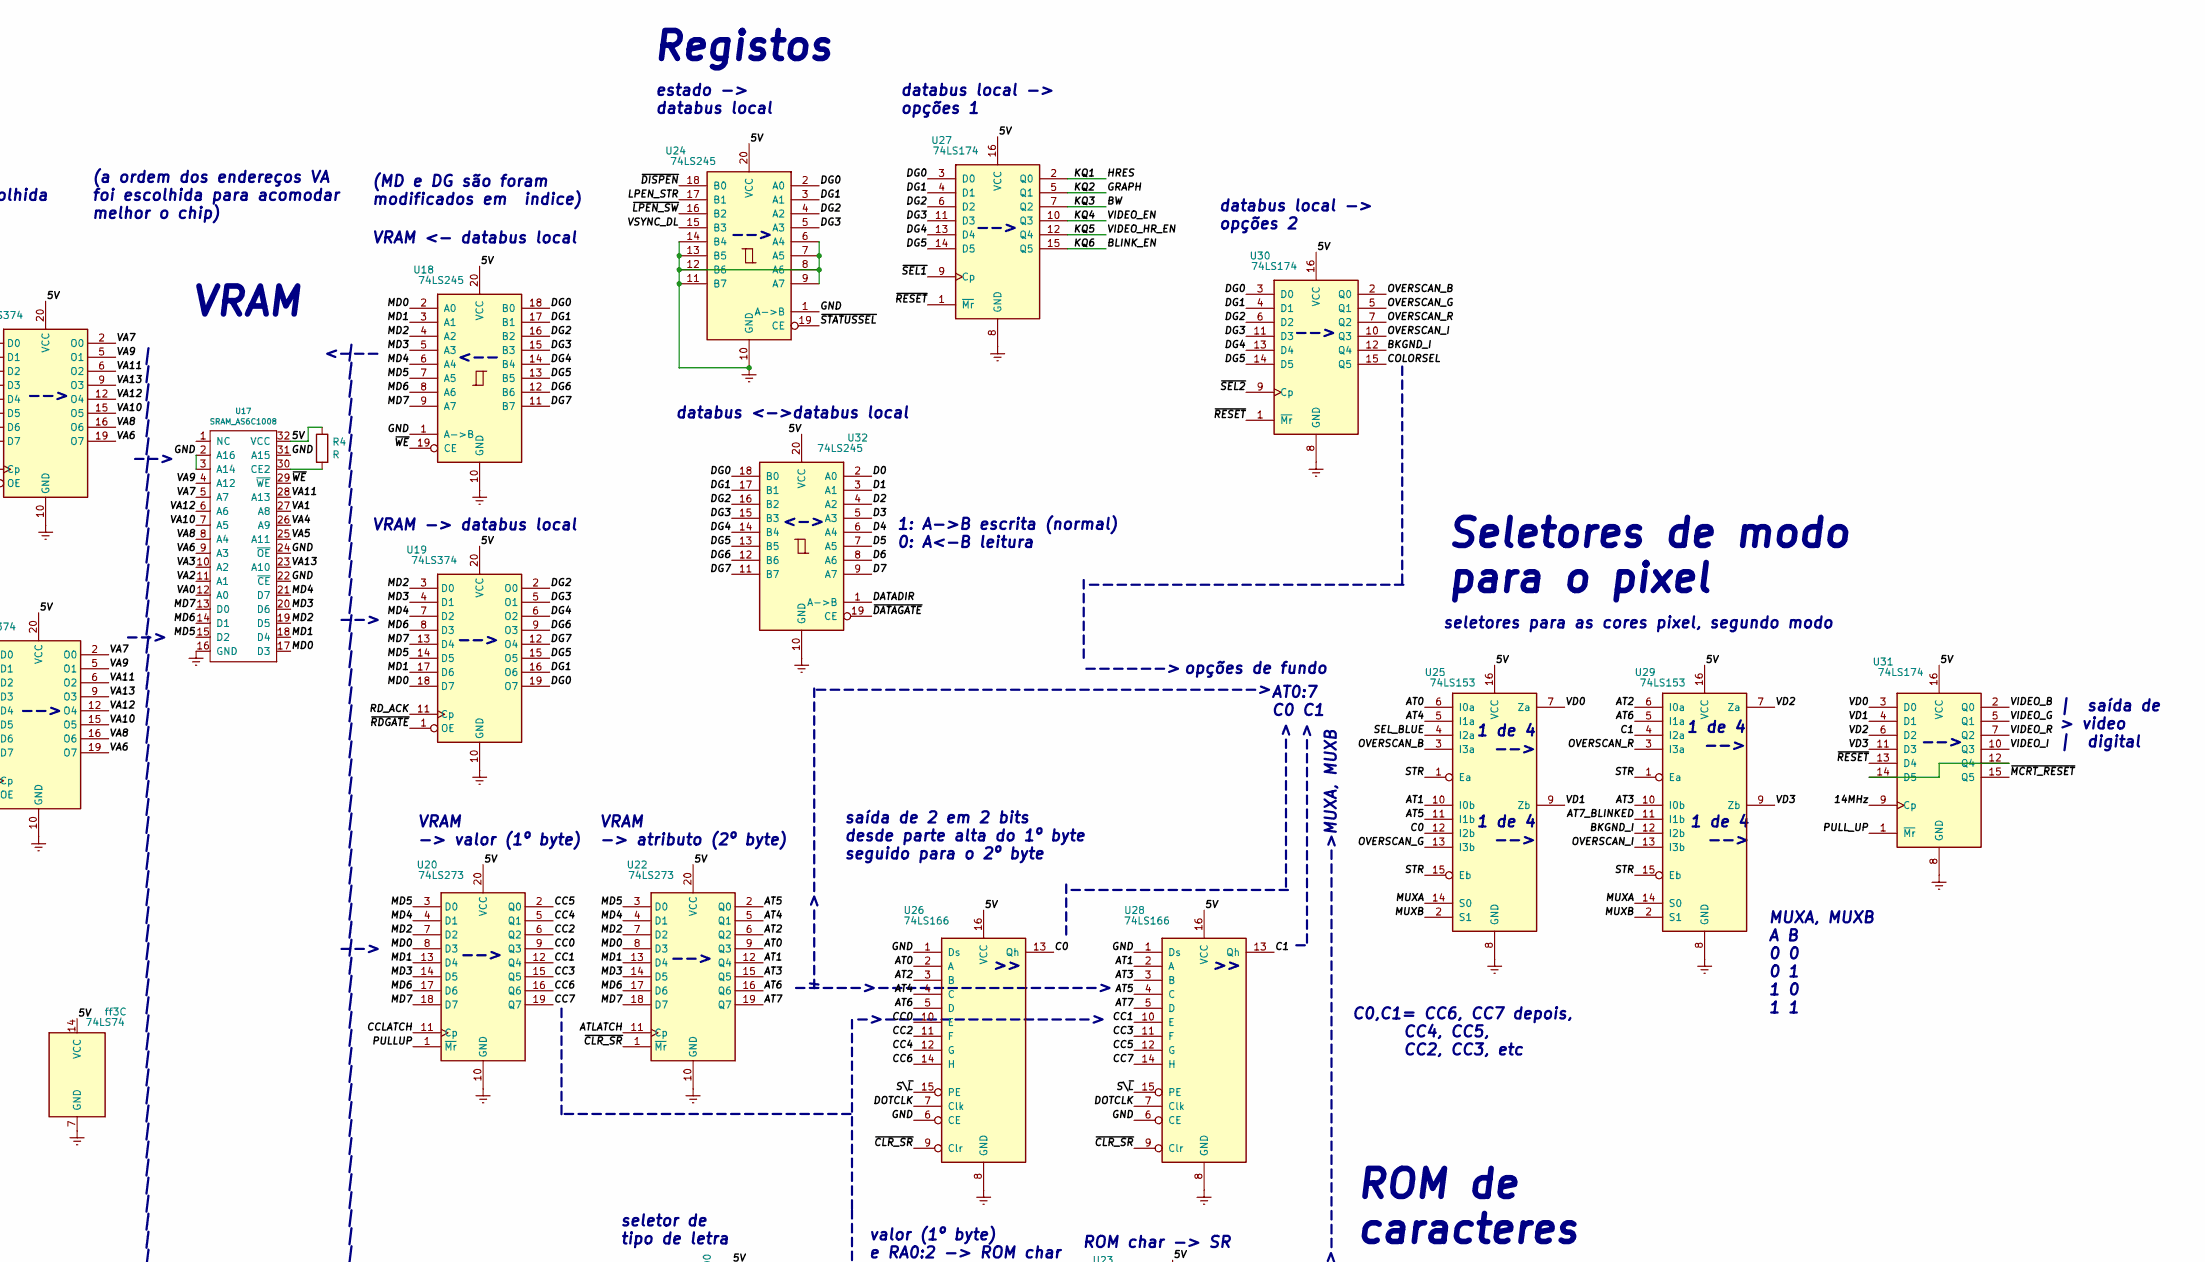
[picture p12: schematic cga.sch, part in row 1, column 2]

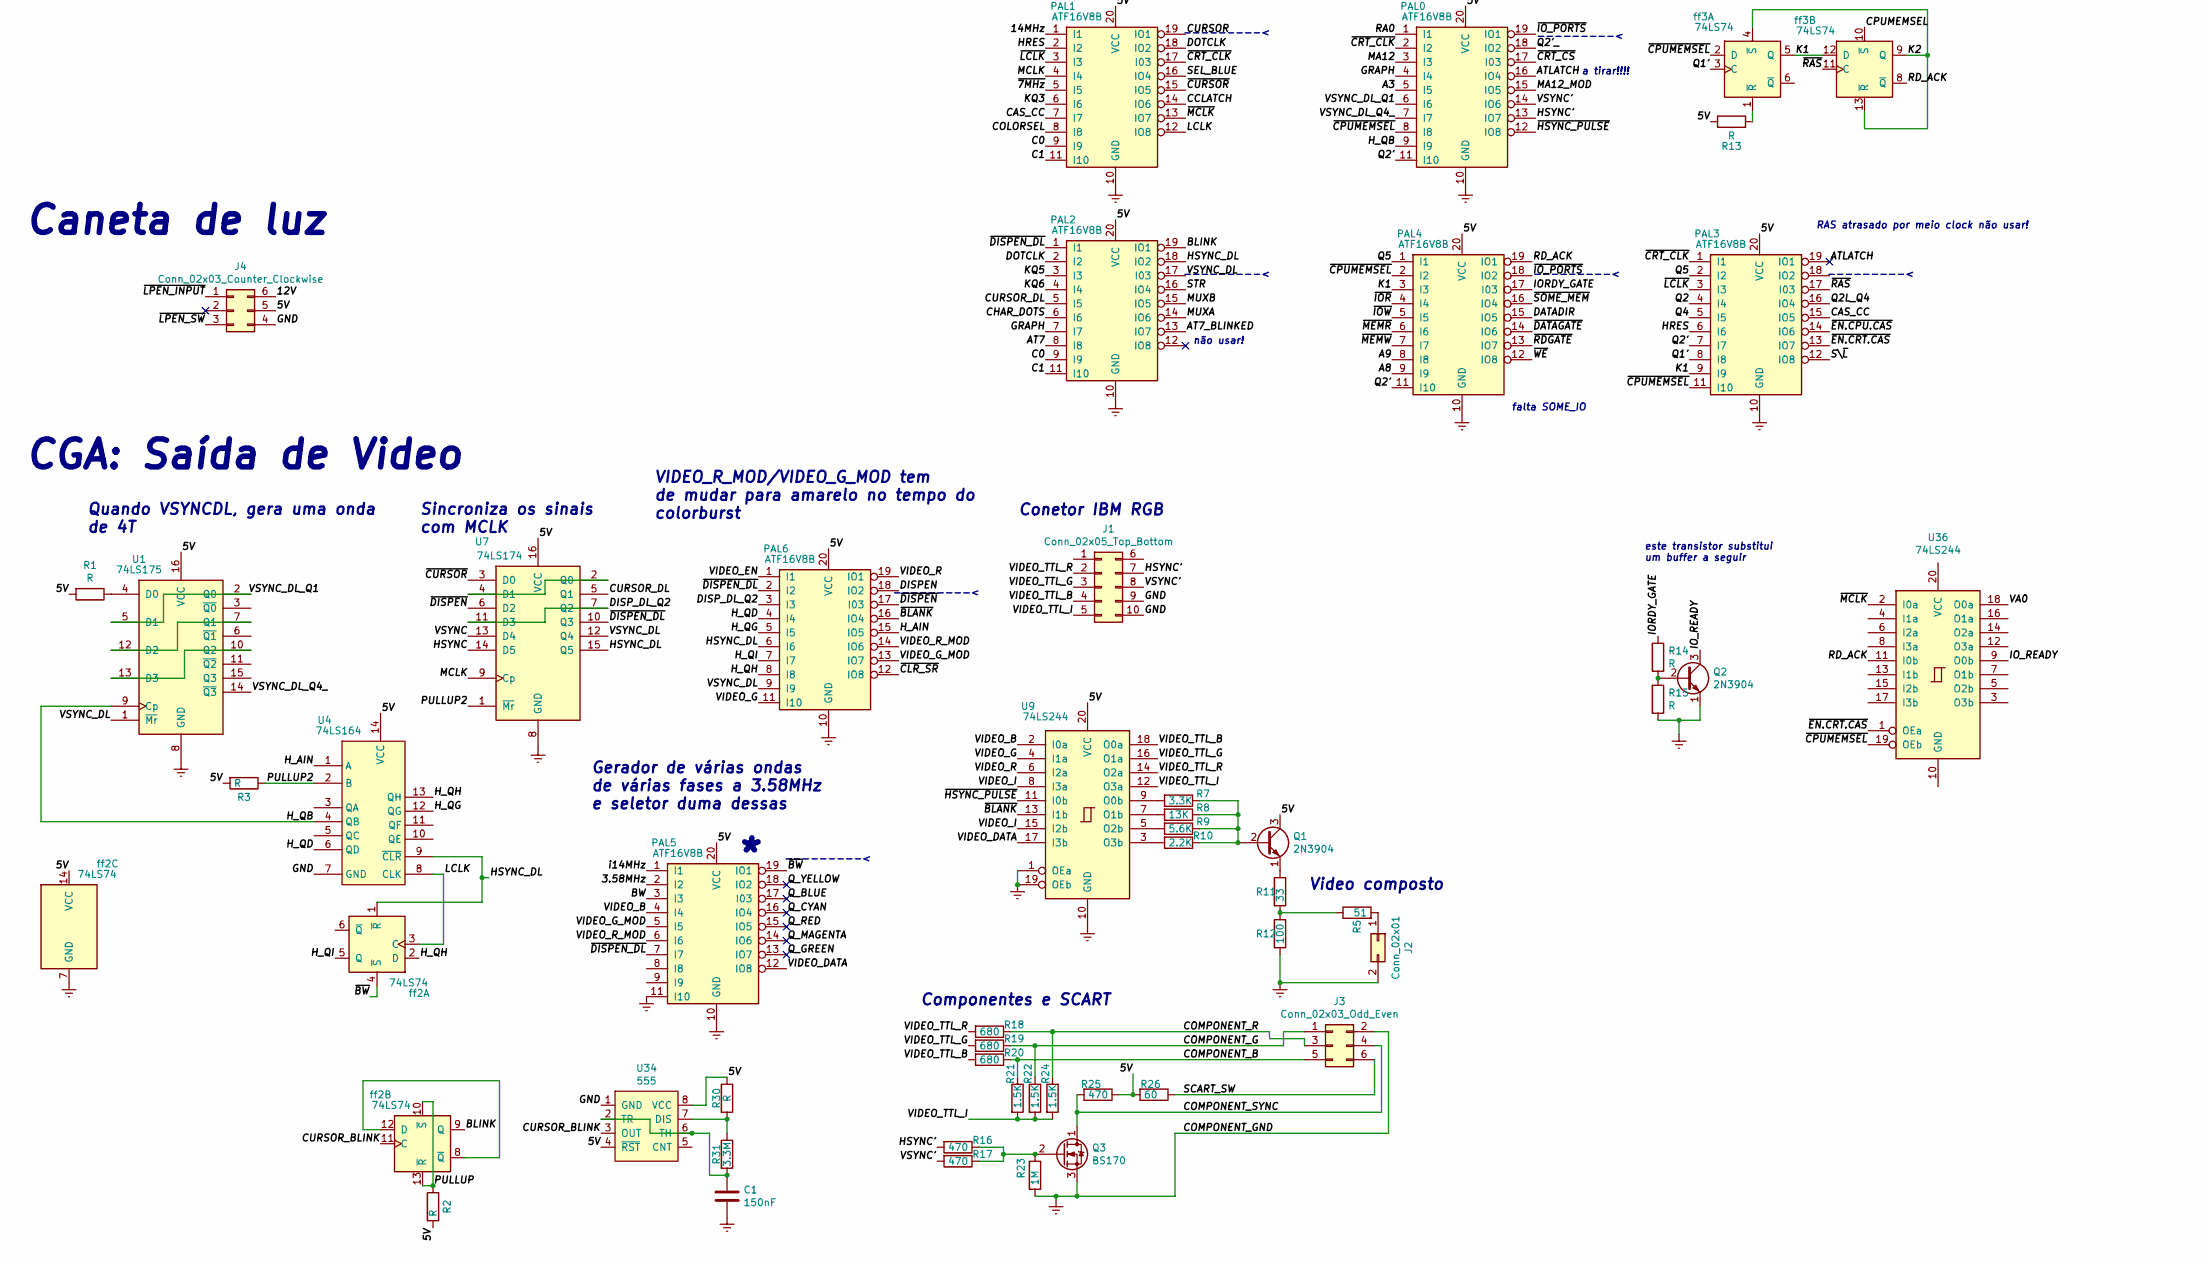
[picture p13: schematic cga.sch, part in row 2, column 1]

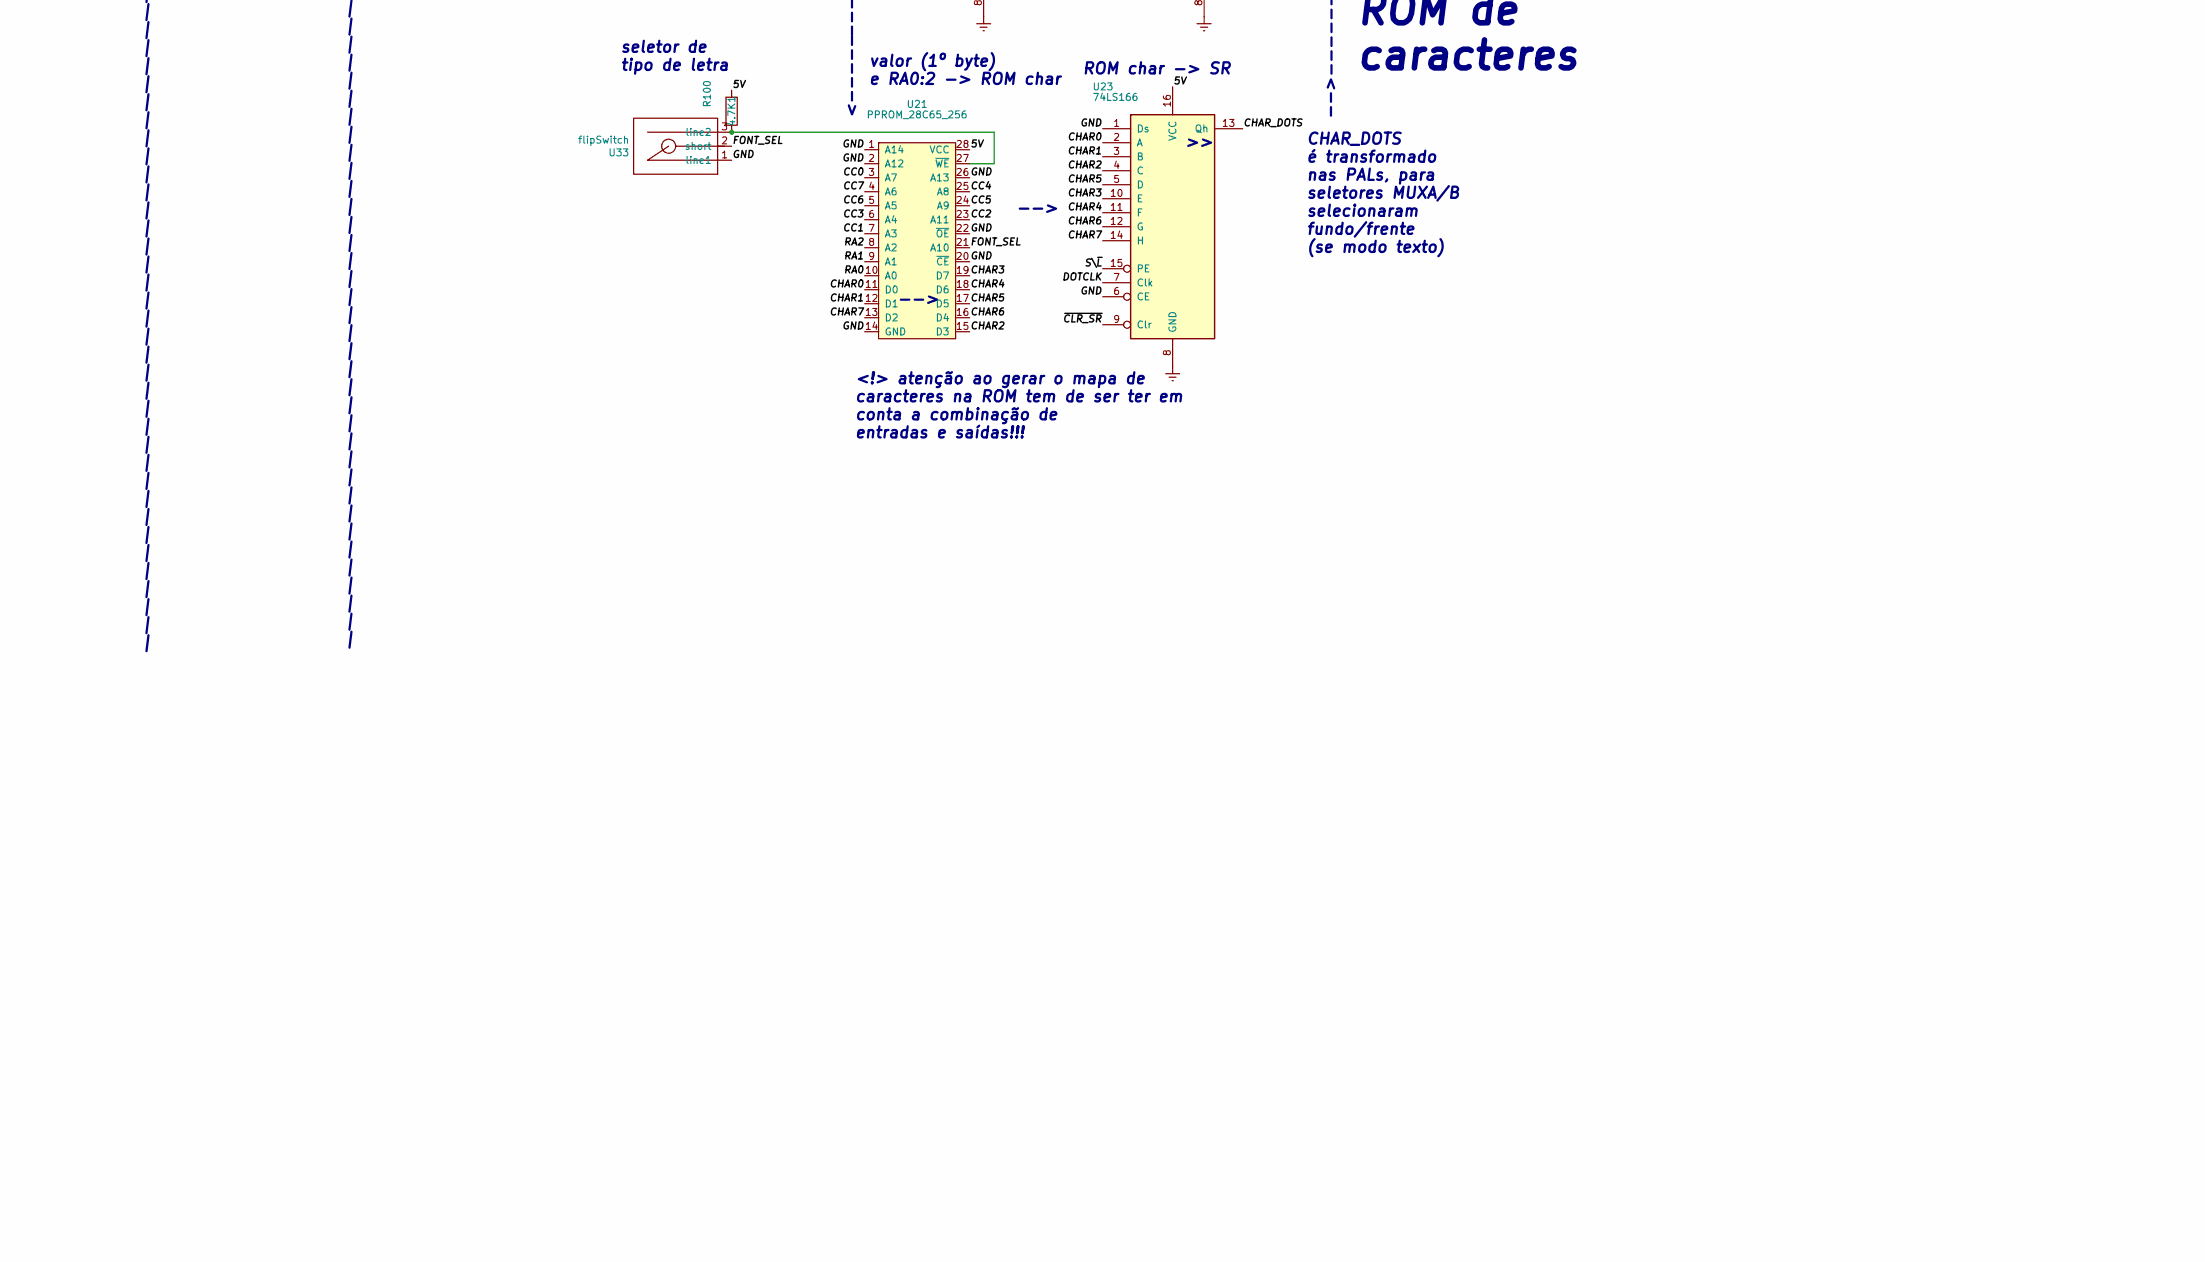
[picture p14: schematic cga.sch, part in row 2, column 2]

Parts:
4.7K1: R100; standard_2pins
C1: 150nF; standard_2pins_half
J1: Conn_02x05_Top_Bottom; conetor_2x05_P2.54_toDB9
J2: Conn_02x01; jumper_set_1
J3: Conn_02x03_Odd_Even; jumper_set_3
J4: Conn_02x03_Counter_Clockwise; jumper_set_3
PAL0, PAL1, PAL2, PAL3, PAL4, PAL5, PAL6: ATF16V8B; standard_DIP_20pins_thin_body
Q1, Q2: 2N3904; TO-92_Inline
Q3: BS170; TO-92_Inline
R1, R2, R3, R4, R13, R14, R15, R30: R; standard_2pins
R5: 51; standard_2pins
R7: 3.3K; standard_2pins
R8: 13K; standard_2pins
R9: 5.6K; standard_2pins
R10: 2.2K; standard_2pins
R11: 33; standard_2pins
R12: 100; standard_2pins
R16, R17, R25: 470; standard_2pins
R18, R19, R20: 680; standard_2pins
R21, R22, R24: 1.5K; standard_2pins
R23: 1M; standard_2pins
R26: 60; standard_2pins
R31: 3.3M; standard_2pins
U1: 74LS175; standard_DIP_16OvalPins
U2: ISA8-Edge; ISA_8bit_edge
U3: 74LS04; standard_DIP_14OvalPins
U4: 74LS164; standard_DIP_14OvalPins
U5, U6, U8: 74LS138; standard_DIP_16OvalPins
U7, U27, U30, U31: 74LS174; standard_DIP_16OvalPins
U9, U36: 74LS244; standard_DIP_20pins_thin_body
U10, U11: 74S174; standard_DIP_16OvalPins
U12: MCRT_6845; standard_DIP_40pins_doubleBody_thinpins
U13, U14, U15, U16, U19: 74LS374; standard_DIP_20pins_thin_body
U17: SRAM_AS6C1008; standard_DIP_32pins_thin_doubleBody
U18, U24, U32: 74LS245; standard_DIP_20pins_thin_body
U20, U22: 74LS273; standard_DIP_20pins_thin_body
U21: PPROM_28C65_256; standard_DIP_28pins_thin_doubleBody
U23, U26, U28: 74LS166; standard_DIP_16OvalPins
U25, U29: 74LS153; standard_DIP_16OvalPins
U33: flipSwitch; mini_flipswitch2.54
U34: 555; standard_DIP_8pins
U35: 74LS00; standard_DIP_14OvalPins
ff1, ff2, ff3: 74LS74; standard_DIP_14OvalPins

Connections:
/3.58MHz: PAL5.2 (I2), U11.12 (Q4), U11.14 (D5)
/5V: 4.7K1.1, J4.5, PAL0.20 (VCC), PAL1.20 (VCC), PAL2.20 (VCC), PAL3.20 (VCC), PAL4.20 (VCC), PAL5.20 (VCC), PAL6.20 (VCC), Q1.3 (C), R1.2, R2.2, R3.2, R4.1, R13.1, R25.1, R26.2, R30.1, U1.16 (VCC), U2.3 (+5V), U2.29 (+5V), U3.14 (VCC), U4.14 (VCC), U5.16 (VCC), U6.16 (VCC), U7.16 (VCC), U8.16 (VCC), U9.20 (VCC), U10.16 (VCC), U11.16 (VCC), U12.20 (VCC), U13.20 (VCC), U14.20 (VCC), U15.20 (VCC), U16.20 (VCC), U17.32 (VCC), U18.20 (VCC), U19.20 (VCC), U20.20 (VCC), U21.28 (VCC), U22.20 (VCC), U23.16 (VCC), U24.20 (VCC), U25.16 (VCC), U26.16 (VCC), U27.16 (VCC), U28.16 (VCC), U29.16 (VCC), U30.16 (VCC), U31.16 (VCC), U32.20 (VCC), U34.4 (~RST), U34.8 (VCC), ff1.14 (VCC), ff2.14 (VCC), ff3.14 (VCC); also elsewhere on the board
/12V: J4.6, U2.9 (+12V)
/14MHz: PAL1.1 (I1), U2.30 (OSC), U3.11, U10.9 (Cp), U11.9 (Cp), U31.9 (Cp)
/A0: U2.62 (A0), U8.1 (A0), U12.24 (RS), U14.17 (D6)
/A1: U2.61 (A1), U8.2 (A1), U14.4 (D1)
/A2: U2.60 (A2), U8.3 (A2), U14.14 (D5)
/A3: PAL0.5 (I5), U2.59 (A3), U8.6 (E3), U14.7 (D2)
/A4: U2.58 (A4), U5.1 (A0), U14.13 (D4)
/A5: U2.57 (A5), U5.4 (E1), U14.8 (D3)
/A6: U2.56 (A6), U5.2 (A1), U16.18 (D7)
/A7: U2.55 (A7), U5.3 (A2), U16.3 (D0)
/A8: PAL4.9 (I9), U2.54 (A8), U16.17 (D6), U35.1
/A9: PAL4.8 (I8), U2.53 (A9), U16.4 (D1), U35.2
/A10: U2.52 (A10), U16.14 (D5)
/A11: U2.51 (A11), U16.7 (D2)
/A12: U2.50 (A12), U16.13 (D4)
/A13: U2.49 (A13), U16.8 (D3)
/A14: U2.48 (A14)
/A15: U2.47 (A15), U6.1 (A0)
/A16: U2.46 (A16), U6.2 (A1)
/A17: U2.45 (A17), U6.3 (A2)
/A18: U2.44 (A18), U6.4 (E1)
/A19: U2.43 (A19), U6.6 (E3)
/AEN: U2.42 (AEN), U5.5 (E2)
/AT0: U22.9 (Q3), U25.6 (I0a), U26.2 (A)
/AT1: U22.12 (Q4), U25.10 (I0b), U28.2 (A)
/AT2: U22.6 (Q2), U26.3 (B), U29.6 (I0a)
/AT3: U22.15 (Q5), U28.3 (B), U29.10 (I0b)
/AT4: U22.5 (Q1), U25.5 (I1a), U26.4 (C)
/AT5: U22.2 (Q0), U25.11 (I1b), U28.4 (C)
/AT6: U22.16 (Q6), U26.5 (D), U29.5 (I1a)
/AT7: PAL2.8 (I8), U22.19 (Q7), U28.5 (D)
/AT7_BLINKED: PAL2.13 (IO7), U29.11 (I1b)
/ATLATCH: PAL0.16 (IO4), PAL3.19 (IO1), U22.11 (Cp)
/BKGND_I: U29.12 (I2b), U30.12 (Q4)
/BLINK: PAL2.19 (IO1), ff2.9 (Q)
/BLINK_EN: PAL2.4 (I4), U27.15 (Q5)
/BW: PAL1.6 (I6), PAL5.3 (I3), U27.7 (Q2)
/C0: PAL1.9 (I9), PAL2.9 (I9), U25.12 (I2b), U26.13 (Qh)
/C1: PAL1.11 (I10), PAL2.11 (I10), U28.13 (Qh), U29.4 (I2a)
/CAS_CC: PAL1.7 (I7), PAL3.15 (IO5)
/CC0: U20.9 (Q3), U21.3 (A7), U26.10 (E)
/CC1: U20.12 (Q4), U21.7 (A3), U28.10 (E)
/CC2: U20.6 (Q2), U21.23 (A11), U26.11 (F)
/CC3: U20.15 (Q5), U21.6 (A4), U28.11 (F)
/CC4: U20.5 (Q1), U21.25 (A8), U26.12 (G)
/CC5: U20.2 (Q0), U21.24 (A9), U28.12 (G)
/CC6: U20.16 (Q6), U21.5 (A5), U26.14 (H)
/CC7: U20.19 (Q7), U21.4 (A6), U28.14 (H)
/CCLATCH: PAL1.14 (IO6), U20.11 (Cp)
/CHAR0: U21.11 (D0), U23.2 (A)
/CHAR1: U21.12 (D1), U23.3 (B)
/CHAR2: U21.15 (D3), U23.4 (C)
/CHAR3: U21.19 (D7), U23.10 (E)
/CHAR4: U21.18 (D6), U23.11 (F)
/CHAR5: U21.17 (D5), U23.5 (D)
/CHAR6: U21.16 (D4), U23.12 (G)
/CHAR7: U21.13 (D2), U23.14 (H)
/CHAR_DOTS: PAL2.6 (I6), U23.13 (Qh)
/CLK88: U2.20 (CLK88), ff1.11 (C)
/COLORSEL: PAL1.8 (I8), U30.15 (Q5)
/COMPONENT_B: J3.5, R20.1, R21.1
/COMPONENT_G: J3.1, R19.1, R22.1
/COMPONENT_R: J3.3, R18.1, R24.1
/COMPONENT_SYNC: J3.4, Q3.1 (D), R25.2
/CPUMEMSEL: U3.6, ff3.10 (~S)
/CRT_ESTR: U12.23 (E), ff1.9 (Q)
/CURSOR: PAL1.19 (IO1), U12.19 (Cursor)
/CURSOR_BLINK: U34.3 (OUT), ff2.11 (C)
/CURSOR_DL: PAL2.5 (I5), U7.5 (Q1)
/D0: U2.40 (D0), U32.2 (A0)
/D1: U2.39 (D1), U32.3 (A1)
/D2: U2.38 (D2), U32.4 (A2)
/D3: U2.37 (D3), U32.5 (A3)
/D4: U2.36 (D4), U32.6 (A4)
/D5: U2.35 (D5), U32.7 (A5)
/D6: U2.34 (D6), U32.8 (A6)
/D7: U2.33 (D7), U32.9 (A7)
/DATADIR: PAL4.15 (IO5), U32.1 (A->B)
/DG0: U12.33 (D0), U18.18 (B0), U19.19 (O7), U24.2 (A0), U27.3 (D0), U30.3 (D0), U32.18 (B0)
/DG1: U12.32 (D1), U18.17 (B1), U19.16 (O6), U24.3 (A1), U27.4 (D1), U30.4 (D1), U32.17 (B1)
/DG2: U12.31 (D2), U18.16 (B2), U19.2 (O0), U24.4 (A2), U27.6 (D2), U30.6 (D2), U32.16 (B2)
/DG3: U12.30 (D3), U18.15 (B3), U19.5 (O1), U24.5 (A3), U27.11 (D3), U30.11 (D3), U32.15 (B3)
/DG4: U12.29 (D4), U18.14 (B4), U19.6 (O2), U27.13 (D4), U30.13 (D4), U32.14 (B4)
/DG5: U12.28 (D5), U18.13 (B5), U19.15 (O5), U27.14 (D5), U30.14 (D5), U32.13 (B5)
/DG6: U12.27 (D6), U18.12 (B6), U19.9 (O3), U32.12 (B6)
/DG7: U12.26 (D7), U18.11 (B7), U19.12 (O4), U32.11 (B7)
/DISPEN: PAL6.18 (IO2), U12.18 (DispEn)
/DISP_DL_Q2: PAL6.3 (I3), U7.7 (Q2), U7.11 (D3)
/DOTCLK: PAL1.18 (IO2), PAL2.2 (I2), U23.7 (Clk), U26.7 (Clk), U28.7 (Clk)
/FONT_SEL: U21.21 (A10), U33.2 (short)
/GRAPH: PAL0.4 (I4), PAL2.7 (I7), U27.5 (Q1)
/HRES: PAL1.2 (I2), PAL3.6 (I6), U27.2 (Q0)
/HSYNC: U7.14 (D5), U12.39 (HSYNC)
/HSYNC': J1.7, PAL0.13 (IO7), R16.2
/HSYNC_DL: PAL2.18 (IO2), PAL6.6 (I6), U4.9 (~CLR), U7.15 (Q5), ff2.1 (~R)
/H_AIN: PAL6.15 (IO5), U4.1 (A)
/H_QB: PAL0.9 (I9), U1.9 (Cp), U4.4 (QB)
/H_QD: PAL6.4 (I4), U4.6 (QD)
/H_QG: PAL6.5 (I5), U4.12 (QG)
/H_QH: PAL6.8 (I8), U4.13 (QH), ff2.2 (D)
/H_QI: PAL6.7 (I7), ff2.5 (Q)
/IORDY_GATE: PAL4.17 (I03), R14.1
/IO_READY: Q2.3 (C), U2.41 (IO_READY), U36.9 (O0b)
/K1: PAL3.9 (I9), PAL4.3 (I3), ff3.5 (Q), ff3.12 (D)
/K2: ff3.4 (~S), ff3.9 (Q), ff3.13 (~R)
/KQ4: PAL6.1 (I1), U27.10 (Q3)
/KQ5: PAL2.3 (I3), U27.12 (Q4)
/LCLK: PAL1.12 (IO8), U4.8 (CLK), ff2.3 (C)
/LPEN_INPUT: ff1.3 (C)
/LPEN_STR: U12.3 (LPSTRB), U24.17 (B1), ff1.5 (Q)
/MA0: U12.4 (MA0), U13.4 (D1)
/MA1: U12.5 (MA1), U13.14 (D5)
/MA2: U12.6 (MA2), U13.7 (D2)
/MA3: U12.7 (MA3), U13.13 (D4)
/MA4: U12.8 (MA4), U13.8 (D3)
/MA5: U12.9 (MA5), U15.18 (D7)
/MA6: U12.10 (MA6), U15.3 (D0)
/MA7: U12.11 (MA7), U15.17 (D6)
/MA8: U12.12 (MA8), U15.4 (D1)
/MA9: U12.13 (MA9), U15.14 (D5)
/MA10: U12.14 (MA10), U15.7 (D2)
/MA11: U12.15 (MA11), U15.13 (D4)
/MA12: PAL0.3 (I3), U12.16 (MA12)
/MA12_MOD: PAL0.15 (IO5), U15.8 (D3)
/MCLK: PAL1.4 (I4), U7.9 (Cp), U11.7 (Q2)
/MD0: U17.17 (D3), U18.2 (A0), U19.18 (D7), U20.8 (D3), U22.8 (D3)
/MD1: U17.18 (D4), U18.3 (A1), U19.17 (D6), U20.13 (D4), U22.13 (D4)
/MD2: U17.19 (D5), U18.4 (A2), U19.3 (D0), U20.7 (D2), U22.7 (D2)
/MD3: U17.20 (D6), U18.5 (A3), U19.4 (D1), U20.14 (D5), U22.14 (D5)
/MD4: U17.21 (D7), U18.6 (A4), U19.7 (D2), U20.4 (D1), U22.4 (D1)
/MD5: U17.15 (D2), U18.7 (A5), U19.14 (D5), U20.3 (D0), U22.3 (D0)
/MD6: U17.14 (D1), U18.8 (A6), U19.8 (D3), U20.17 (D6), U22.17 (D6)
/MD7: U17.13 (D0), U18.9 (A7), U19.13 (D4), U20.18 (D7), U22.18 (D7)
/MUXA: PAL2.14 (IO6), U25.14 (S0), U29.14 (S0)
/MUXB: PAL2.15 (IO5), U25.2 (S1), U29.2 (S1)
/OVERSCAN_B: U25.3 (I3a), U30.2 (Q0)
/OVERSCAN_G: U25.13 (I3b), U30.5 (Q1)
/OVERSCAN_I: U29.13 (I3b), U30.10 (Q3)
/OVERSCAN_R: U29.3 (I3a), U30.7 (Q2)
/PULLUP: R2.1, U20.1 (~Mr), ff1.2 (D), ff1.10 (~S), ff2.10 (~S), ff2.13 (~R)
/PULLUP2: R3.1, U4.2 (B), U7.1 (~Mr)
/PULL_UP: U31.1 (~Mr), U35.9
/Q1: PAL1.3 (I3), PAL3.3 (I3), U10.2 (Q0), U10.4 (D1)
/Q1': PAL3.8 (I8), U11.2 (Q0), U11.4 (D1), U14.11 (Cp), U16.11 (Cp), ff3.3 (C)
/Q2: PAL3.4 (I4), U10.5 (Q1), U10.6 (D2)
/Q2': PAL0.11 (I10), PAL3.7 (I7), PAL4.11 (I10), U11.5 (Q1)
/Q2'_: PAL0.18 (IO2), U10.3 (D0)
/Q2L_Q4: PAL3.16 (IO4), U11.6 (D2)
/Q3: U10.7 (Q2), U10.11 (D3)
/Q4: PAL3.5 (I5), U10.10 (Q3), U10.13 (D4)
/Q4': U3.1, U11.10 (Q3)
/Q5: PAL3.2 (I2), PAL4.1 (I1), U10.12 (Q4), U10.14 (D5)
/Q6: U10.15 (Q5), U11.3 (D0)
/Q6': U3.3, U11.15 (Q5)
/Q6'_: U3.4, U11.13 (D4)
/Q_BLUE: PAL5.17 (I03)
/Q_CYAN: PAL5.16 (IO4)
/Q_GREEN: PAL5.13 (IO7)
/Q_MAGENTA: PAL5.14 (IO6)
/Q_RED: PAL5.15 (IO5)
/Q_YELLOW: PAL5.18 (IO2)
/RA0: PAL0.1 (I1), U12.38 (RA0), U21.10 (A0)
/RA1: U12.37 (RA1), U21.9 (A1)
/RA2: U12.36 (RA2), U21.8 (A2)
/RD_ACK: PAL4.19 (IO1), U19.11 (Cp), U36.11 (I0b), ff3.8 (~Q)
/RESET: U2.2 (RESET), U3.9
/SCART_SW: J3.6, R26.1
/SEL_BLUE: PAL1.16 (IO4), U25.4 (I2a)
/SOME_IO: U3.12, U5.6 (E3), ff1.12 (D), ff1.13 (~R)
/STR: PAL2.16 (IO4), U25.1 (Ea), U25.15 (Eb), U29.1 (Ea), U29.15 (Eb)
/S\~L: PAL3.12 (IO8), U23.15 (PE), U26.15 (PE), U28.15 (PE)
/VA0: U14.16 (O6), U17.12 (A0), U36.18 (O0a); also elsewhere on the board
/VA1: U13.5 (O1), U14.5 (O1), U17.27 (A8)
/VA2: U13.15 (O5), U14.15 (O5), U17.11 (A1)
/VA3: U13.6 (O2), U14.6 (O2), U17.10 (A2)
/VA4: U13.12 (O4), U14.12 (O4), U17.26 (A9)
/VA5: U13.9 (O3), U14.9 (O3), U17.25 (A11)
/VA6: U15.19 (O7), U16.19 (O7), U17.9 (A3)
/VA7: U15.2 (O0), U16.2 (O0), U17.5 (A7)
/VA8: U15.16 (O6), U16.16 (O6), U17.8 (A4)
/VA9: U15.5 (O1), U16.5 (O1), U17.4 (A12)
/VA10: U15.15 (O5), U16.15 (O5), U17.7 (A5)
/VA11: U15.6 (O2), U16.6 (O2), U17.28 (A13)
/VA12: U15.12 (O4), U16.12 (O4), U17.6 (A6)
/VA13: U15.9 (O3), U16.9 (O3), U17.23 (A10)
/VD0: U25.7 (Za), U31.3 (D0)
/VD1: U25.9 (Zb), U31.4 (D1)
/VD2: U29.7 (Za), U31.6 (D2)
/VD3: U29.9 (Zb), U31.11 (D3)
/VIDEO_B: PAL5.4 (I4), U9.2 (I0a), U31.2 (Q0)
/VIDEO_DATA: PAL5.12 (IO8), U9.17 (I3b)
/VIDEO_G: PAL6.11 (I10), U9.4 (I1a), U31.5 (Q1)
/VIDEO_G_MOD: PAL5.5 (I5), PAL6.13 (IO7)
/VIDEO_I: U9.8 (I3a), U9.15 (I2b), U31.10 (Q3)
/VIDEO_R: PAL6.19 (IO1), U9.6 (I2a), U31.7 (Q2)
/VIDEO_R_MOD: PAL5.6 (I6), PAL6.14 (IO6)
/VIDEO_TTL_B: J1.4, R20.2, U9.18 (O0a)
/VIDEO_TTL_G: J1.3, R19.2, U9.16 (O1a)
/VIDEO_TTL_I: J1.5, R21.2, R22.2, R24.2, U9.12 (O3a)
/VIDEO_TTL_R: J1.2, R18.2, U9.14 (O2a)
/VSYNC: U7.13 (D4), U12.40 (VSYNC)
/VSYNC': J1.8, PAL0.14 (IO6), R17.2
/VSYNC_DL: PAL2.17 (I03), PAL6.9 (I9), U1.1 (~Mr), U7.12 (Q4), U24.15 (B3)
/VSYNC_DL_Q1: PAL0.6 (I6), U1.2 (Q0), U1.5 (D1)
/VSYNC_DL_Q4_: PAL0.7 (I7), U1.14 (~Q3)
/i14MHz: PAL5.1 (I1), U3.10
/~7MHz: PAL1.5 (I5), U3.2, U11.11 (D3)
/~BLANK: PAL6.16 (IO4), U9.13 (I1b)
/~BW: PAL5.19 (IO1), ff2.4 (~S)
/~CLR_SR: PAL6.12 (IO8), U22.1 (~Mr), U23.9 (Clr), U26.9 (Clr), U28.9 (Clr)
/~CPUMEMSEL: PAL0.8 (I8), PAL3.11 (I10), PAL4.2 (I2), U3.5, U6.7 (O7), U36.19 (OEb), ff3.2 (D)
/~CRT_CLK: PAL0.2 (I2), PAL1.17 (I03), PAL3.1 (I1), U12.21 (CLK)
/~CRT_CS: PAL0.17 (I03), U12.25 (CS)
/~CURSOR: PAL1.15 (IO5), U7.3 (D0)
/~DATAGATE: PAL4.14 (IO6), U32.19 (CE)
/~DISPEN: PAL6.17 (I03), U7.6 (D2), U24.18 (B0)
/~DISPEN_DL: PAL2.1 (I1), PAL5.7 (I7), PAL6.2 (I2), U7.10 (Q3)
/~EN.CPU.CAS: PAL3.14 (IO6), U14.1 (OE), U16.1 (OE)
/~EN.CRT.CAS: PAL3.13 (IO7), U13.1 (OE), U15.1 (OE), U36.1 (OEa); also elsewhere on the board
/~HSYNC_PULSE: PAL0.12 (IO8), U9.11 (I0b)
/~IOCHK: U2.32 (~IOCHK)
/~IOR: PAL4.4 (I4), U2.14 (~IOR)
/~IOW: PAL4.5 (I5), U2.13 (~IOW), U12.22 (R/~W)
/~IO_PORTS: PAL0.19 (IO1), PAL4.18 (IO2), U5.7 (O7), U8.4 (E1), U8.5 (E2)
/~LPEN_INPUT: J4.1
/~LPEN_SW: J4.3, U24.16 (B2)
/~MCLK: PAL1.13 (IO7), U36.2 (I0a); also elsewhere on the board
/~MEMR: PAL4.6 (I6), U2.12 (~MEMR)
/~MEMW: PAL4.7 (I7), U2.11 (~MEMW)
/~RAS: PAL3.17 (I03), U13.11 (Cp), U15.11 (Cp), ff3.11 (C)
/~RDGATE: PAL4.13 (IO7), U19.1 (OE)
/~RESET: U3.8, U27.1 (~Mr), U30.1 (~Mr), U31.13 (D4)
/~RESET2: U10.1 (~Mr), U11.1 (~Mr), U12.2 (RST), U31.15 (Q5)
/~SEL1: U8.15 (O0), U27.9 (Cp)
/~SEL2: U8.14 (O1), U30.9 (Cp)
/~SOME_MEM: PAL4.16 (IO4), U6.5 (E2)
/~STATUSSEL: U8.13 (O2), U24.19 (CE)
/~WE: PAL4.12 (IO8), U17.29 (~WE), U18.19 (CE)
/~XIOR: U35.13
/~XIOW: U35.12
unnamed: 4.7K1.2, U21.27 (~WE), U33.3 (line2)
unnamed: C1.1, R31.2, U34.2 (TR), U34.6 (TH)
unnamed: J2.1, R5.2
unnamed: Q1.1 (E), R11.1
unnamed: Q1.2 (B), R7.1, R8.1, R9.1, R10.1
unnamed: Q2.2 (B), R14.2, R15.1
unnamed: Q3.2 (G), R16.1, R17.1, R23.1
unnamed: R1.1, U1.4 (D0)
unnamed: R4.2, U17.30 (CE2)
unnamed: R7.2, U9.9 (O0b)
unnamed: R8.2, U9.7 (O1b)
unnamed: R9.2, U9.5 (O2b)
unnamed: R10.2, U9.3 (O3b)
unnamed: R5.1, R11.2, R12.1
unnamed: R13.2, ff3.1 (~R)
unnamed: R30.2, R31.1, U34.7 (DIS)
unnamed: U1.10 (Q2), U1.13 (D3)
unnamed: U1.7 (Q1), U1.12 (D2)
unnamed: U3.13, U35.6
unnamed: U7.2 (Q0), U7.4 (D1)
unnamed: U8.11 (O4), ff1.4 (~S)
unnamed: U8.12 (O3), ff1.1 (~R)
unnamed: U31.12 (Q4), U31.14 (D5)
unnamed: U35.3, U35.4
unnamed: U35.5, U35.8
unnamed: U35.10, U35.11
unnamed: ff2.8 (~Q), ff2.12 (D)

Notes on the sheet:
Gerar clocks
Validar acesso I/O
Validar acesso VRAM
Controlador CRT
estado -> databus local
endereço CPU para VRAM ------>
VRAM -> databus local
VRAM <- databus local
VRAM
endereço CRT para VRAM ------>
VRAM -> valor (1º byte)
VRAM -> atributo (2º byte)
| | | | | | | | | | | | | | | | | | | | | | | | | | | | | | | | | | | | | | | | | | | | | | | | | | | | | | | | | | | | | | | | | | | | | | | | | | | | | | | | | |
valor (1º byte) e RA0:2 -> ROM char
ROM char -> SR
saída de 2 em 2 bits desde parte alta do 1º byte seguido para o 2º byte
seletores para as cores pixel, segundo modo
databus local -> opções 1
databus local -> opções 2
Gerar sinais (combinatória e seq)
Estas PALs tem flipflops e o pino 1 e 11 estao reservados para CLK e ~OE
(a ordem foi escolhida para acomodar)
(a ordem dos endereços VA foi escolhida para acomodar melhor o chip)
<!> atenção ao gerar o mapa de caracteres na ROM tem de ser ter em conta a combinação de entradas e saídas!!!
CGA: Saída de Video
Video composto
Conetor IBM RGB
Gerador de várias ondas de várias fases a 3.58MHz e seletor duma dessas
Quando VSYNCDL, gera uma onda de 4T
Componentes e SCART
Sincroniza os sinais com MCLK
VIDEO_R_MOD/VIDEO_G_MOD tem de mudar para amarelo no tempo do colorburst
seletor de tipo de letra
74LS74:
ff1: set/reset ao valor da light pen por I/O, strobe necessário ao MCRT quando I/O
ff2: parte do ff de sync, blink do fundo
ff3: arbritação leitura cpu
---------<
não usar!
RAS atrasado por meio clock não usar!
(MAi)-->(Vi+1)
| saída de > video | digital
Caneta de luz
--------
-->
<--
<-----
---------------------
----->---------------->
->--------------->
--------------
--------------->
AT0:7 C0 C1
+----->---------------
-------------------------------->
----------->
----------------
----
----------------------------->MUXA, MUXB
CHAR_DOTS é transformado nas PALs, para seletores MUXA/B selecionaram fundo/frente (se modo texto)
opções de fundo
------>
-->
1 de 4 -->
-----------------------
------
<---
além de ~CRT_CS~ é necessário um strobe sync com o cpu quando I/O...
falta SOME_IO
ROM de caracteres
Seletores de modo para o pixel
1: A->B escrita (normal) 0: A<-B leitura
<->
databus <->databus local
(MD e DG são foram modificados em indice)
MUXA, MUXB A B 0 0 0 1 1 0 1 1
A8, A9, IOR/W
C0,C1= CC6, CC7 depois, CC4, CC5, CC2, CC3, etc
a tirar!!!!
este transistor substitui um buffer a seguir
Registos

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
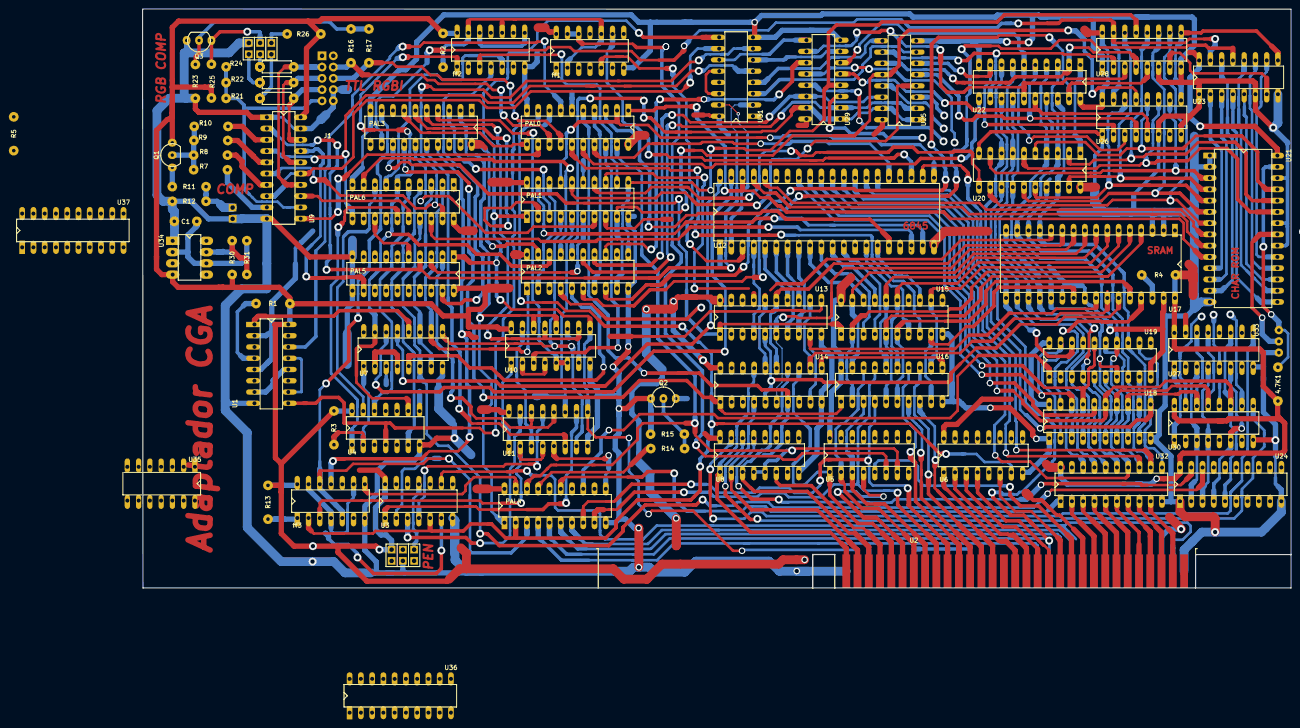
[picture p15: board cga.kicad_pcb from above]

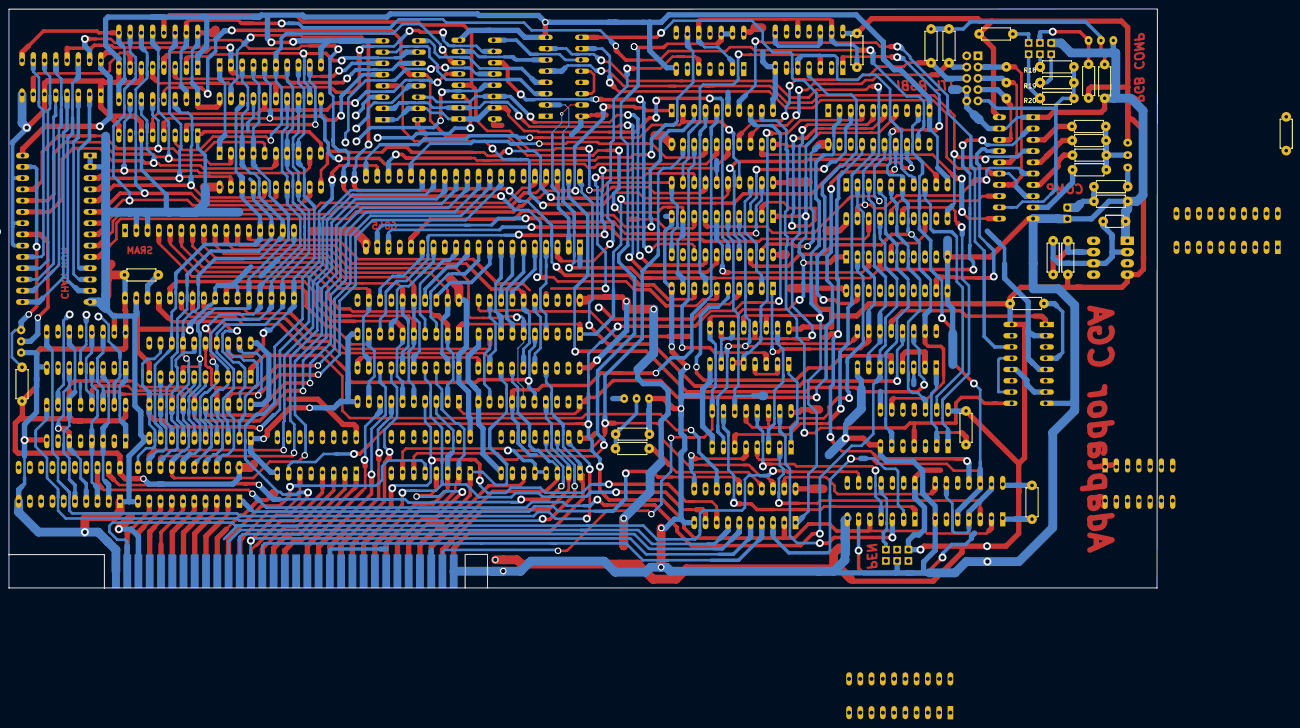
[picture p16: board cga.kicad_pcb from below]

Board: 2 copper layers, 259.1 x 130.6 mm, 83 parts (3 on the bottom side), 258 nets.

Other parts of the board:
U37: 74LS245; standard_DIP_20pins_thin_body

Their connections:
/5V: U37.20; also elsewhere on the board
/VA0: U37.2; also elsewhere on the board
/~EN.CRT.CAS: U37.19; also elsewhere on the board
/~MCLK: U37.18; also elsewhere on the board
