woreno/IBM-PC-XT-compatible/KICAD/ide/ide/ide.kicad_pcb

## KiCad design KICAD/ide/ide/ide.kicad_pcb (2026-11-09)

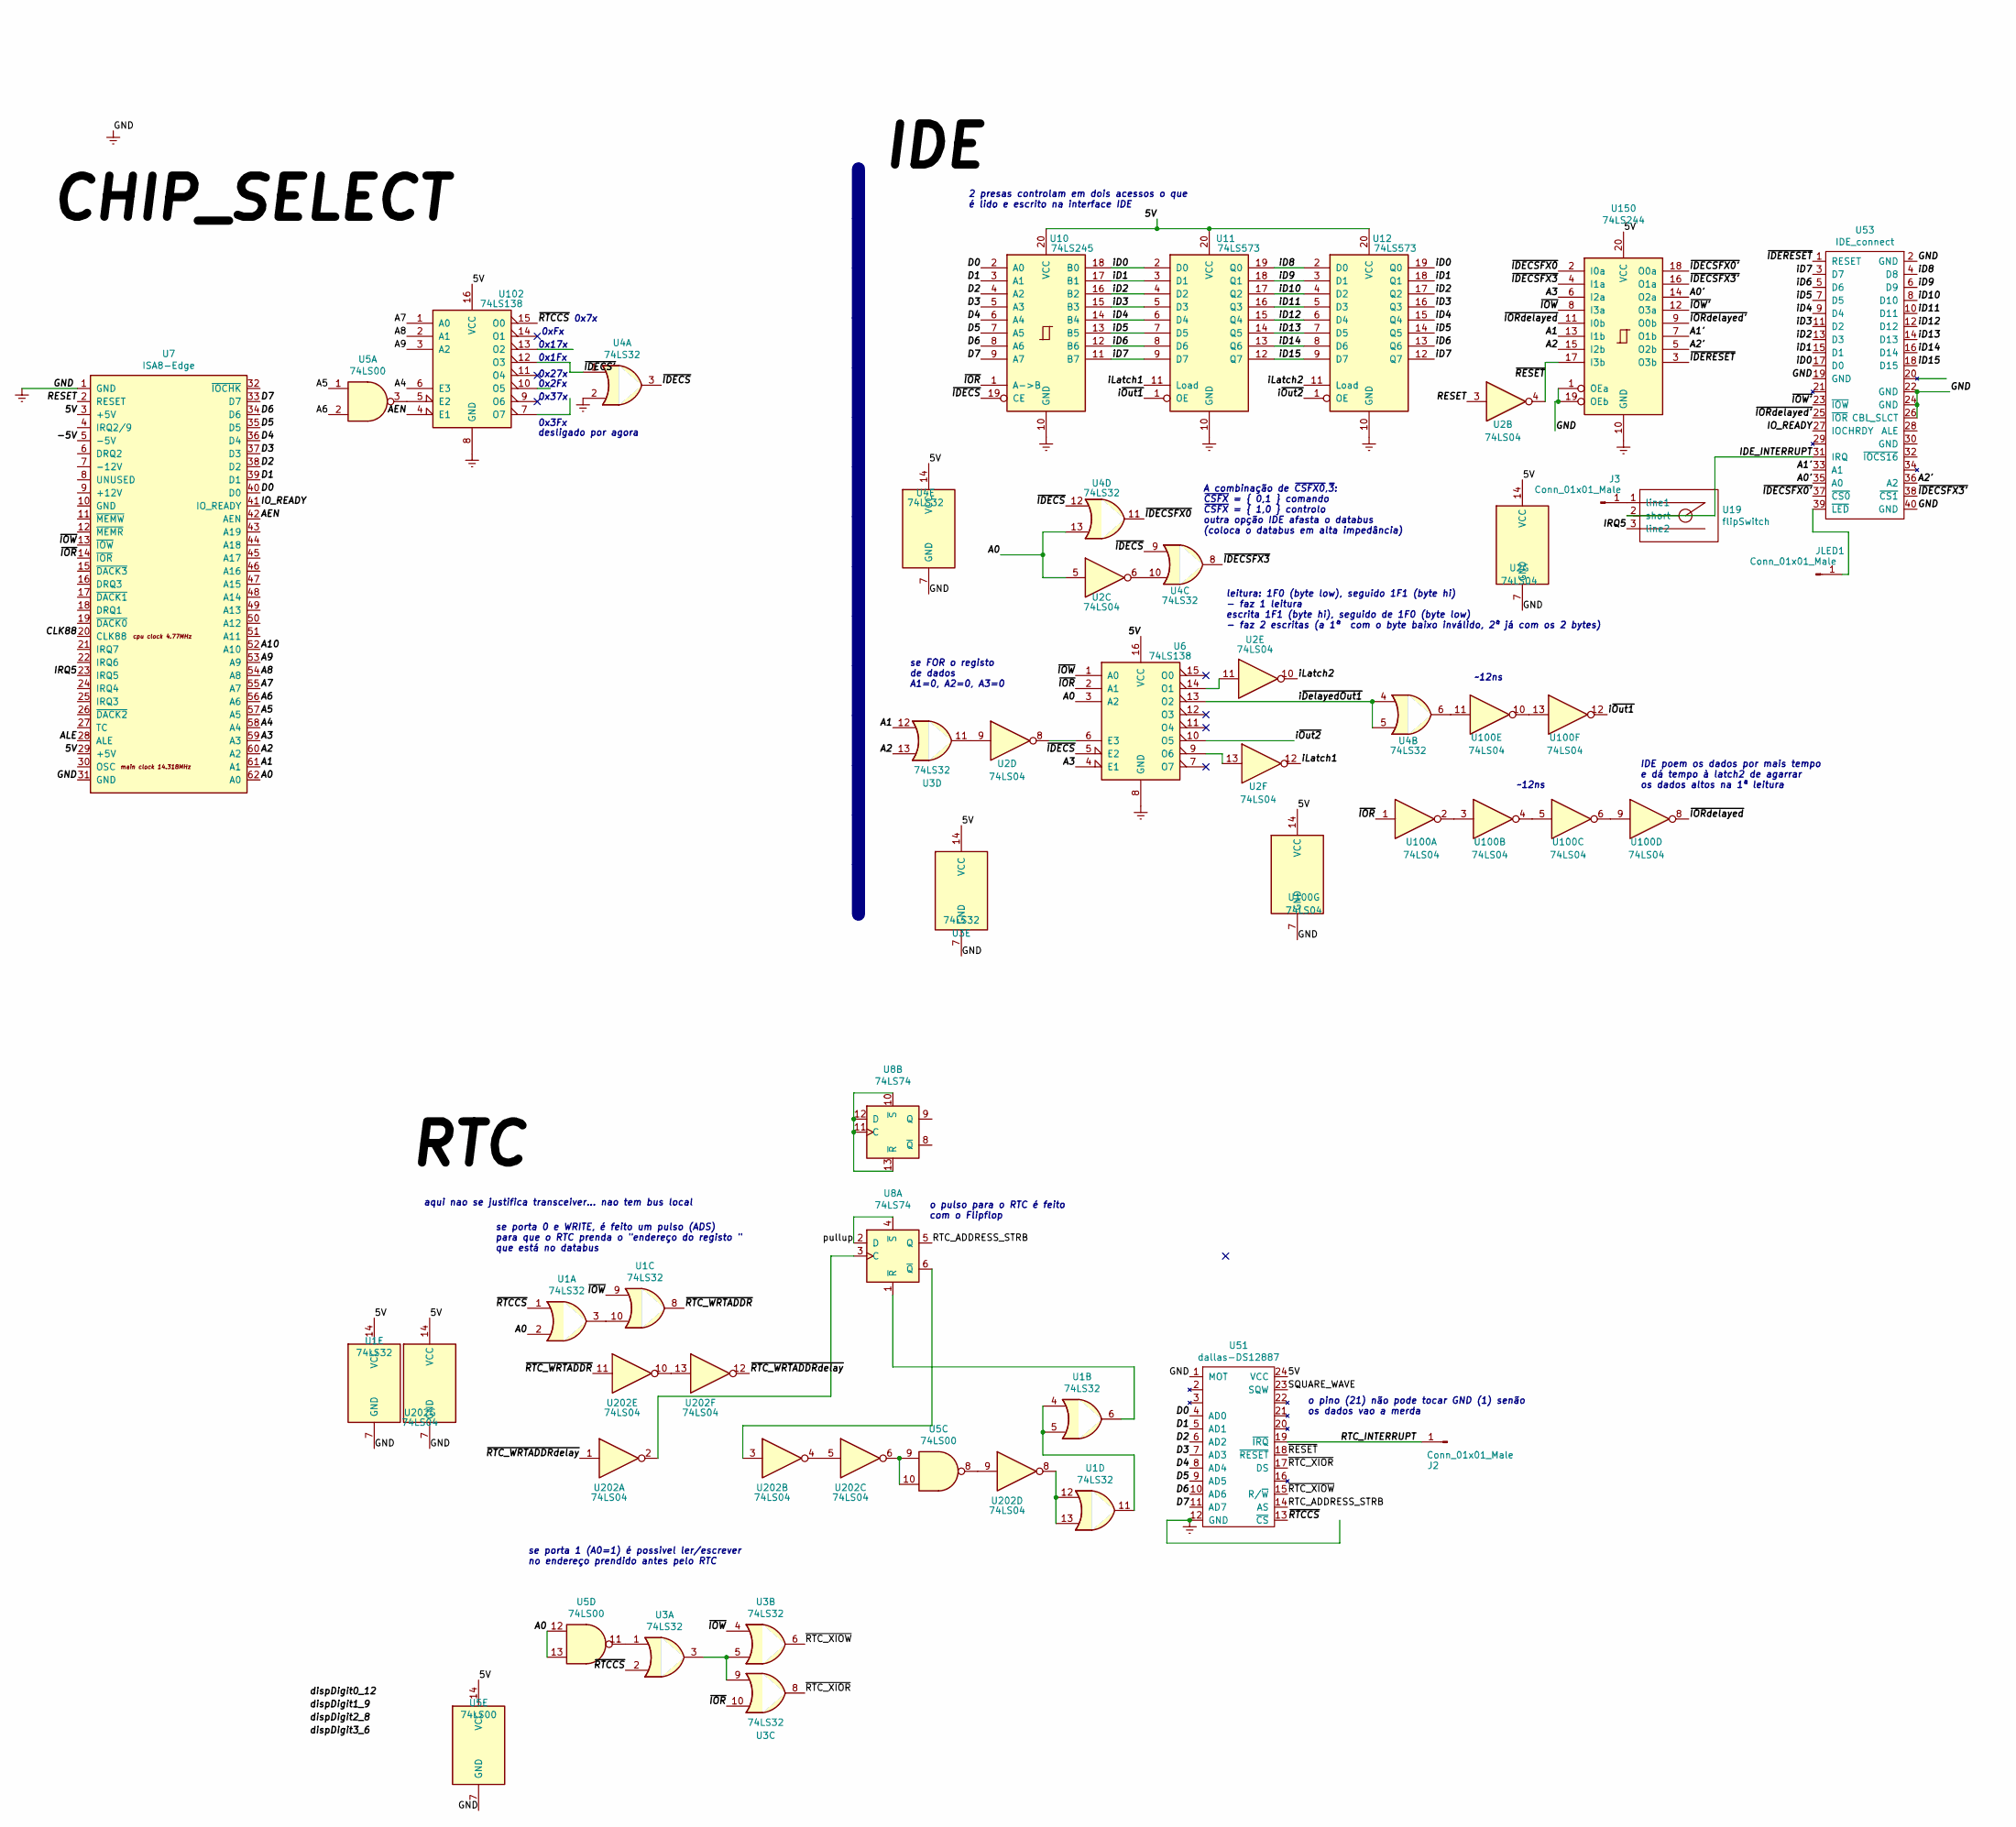
[picture p17: schematic ide.sch]

Parts:
J2, J3: Conn_01x01_Male; Conector1x1_Oval
JLED1: Conn_01x01_Male; Conector1x1_Oval
U1, U3, U4: 74LS32; standard_DIP_14OvalPins
U2, U100, U202: 74LS04; standard_DIP_14OvalPins
U5: 74LS00; standard_DIP_14OvalPins
U6, U102: 74LS138; standard_DIP_16OvalPins
U7: ISA8-Edge; ISA_8bit_edge
U8: 74LS74; standard_DIP_14OvalPins
U10: 74LS245; standard_DIP_20pins_thin_body
U11, U12: 74LS573; standard_DIP_20pins_thin_body
U19: flipSwitch; mini_flipswitch2.54
U51: dallas-DS12887; standard_DIP_24pins_thin_doubleBody
U53: IDE_connect; Conector2x20_Oval_alternado
U150: 74LS244; standard_DIP_20pins_thin_body

Connections:
/5V: U1.14 (VCC), U2.14 (VCC), U3.14 (VCC), U4.14 (VCC), U5.14 (VCC), U6.16 (VCC), U7.3 (+5V), U7.29 (+5V), U10.20 (VCC), U11.20 (VCC), U12.20 (VCC), U51.24 (VCC), U100.14 (VCC), U102.16 (VCC), U150.20 (VCC), U202.14 (VCC)
/-5V: U7.5 (-5V)
/A0: U1.2, U2.5, U4.13, U5.12, U5.13, U6.3 (A2), U7.62 (A0)
/A0': U53.35 (A0), U150.14 (O2a)
/A1: U3.12, U7.61 (A1), U150.13 (I1b)
/A1': U53.33 (A1), U150.7 (O1b)
/A2: U3.13, U7.60 (A2), U150.15 (I2b)
/A2': U53.36 (A2), U150.5 (O2b)
/A3: U6.4 (E1), U7.59 (A3), U150.6 (I2a)
/A4: U7.58 (A4), U102.6 (E3)
/A5: U5.1, U7.57 (A5)
/A6: U5.2, U7.56 (A6)
/A7: U7.55 (A7), U102.1 (A0)
/A8: U7.54 (A8), U102.2 (A1)
/A9: U7.53 (A9), U102.3 (A2)
/A10: U7.52 (A10)
/AEN: U7.42 (AEN), U102.4 (E1)
/ALE: U7.28 (ALE)
/CLK88: U7.20 (CLK88)
/D0: U7.40 (D0), U10.2 (A0), U51.4 (AD0)
/D1: U7.39 (D1), U10.3 (A1), U51.5 (AD1)
/D2: U7.38 (D2), U10.4 (A2), U51.6 (AD2)
/D3: U7.37 (D3), U10.5 (A3), U51.7 (AD3)
/D4: U7.36 (D4), U10.6 (A4), U51.8 (AD4)
/D5: U7.35 (D5), U10.7 (A5), U51.9 (AD5)
/D6: U7.34 (D6), U10.8 (A6), U51.10 (AD6)
/D7: U7.33 (D7), U10.9 (A7), U51.11 (AD7)
/IDE_INTERRUPT: U19.2 (short), U53.31 (IRQ)
/IO_READY: U7.41 (IO_READY), U53.27 (IOCHRDY)
/IRQ5: U7.23 (IRQ5), U19.3 (line2)
/RESET: U2.3, U7.2 (RESET)
/RTC_ADDRESS_STRB: U8.5 (Q), U51.14 (AS)
/RTC_INTERRUPT: J2.1, U51.19 (~IRQ)
/SQUARE_WAVE: U51.23 (SQW)
/iD0: U10.18 (B0), U11.2 (D0), U12.19 (Q0), U53.17 (D0)
/iD1: U10.17 (B1), U11.3 (D1), U12.18 (Q1), U53.15 (D1)
/iD2: U10.16 (B2), U11.4 (D2), U12.17 (Q2), U53.13 (D3)
/iD3: U10.15 (B3), U11.5 (D3), U12.16 (Q3), U53.11 (D2)
/iD4: U10.14 (B4), U11.6 (D4), U12.15 (Q4), U53.9 (D4)
/iD5: U10.13 (B5), U11.7 (D5), U12.14 (Q5), U53.7 (D5)
/iD6: U10.12 (B6), U11.8 (D6), U12.13 (Q6), U53.5 (D6)
/iD7: U10.11 (B7), U11.9 (D7), U12.12 (Q7), U53.3 (D7)
/iD8: U11.19 (Q0), U12.2 (D0), U53.4 (D8)
/iD9: U11.18 (Q1), U12.3 (D1), U53.6 (D9)
/iD10: U11.17 (Q2), U12.4 (D2), U53.8 (D10)
/iD11: U11.16 (Q3), U12.5 (D3), U53.10 (D11)
/iD12: U11.15 (Q4), U12.6 (D4), U53.12 (D12)
/iD13: U11.14 (Q5), U12.7 (D5), U53.14 (D13)
/iD14: U11.13 (Q6), U12.8 (D6), U53.16 (D14)
/iD15: U11.12 (Q7), U12.9 (D7), U53.18 (D15)
/iLatch1: U2.12, U11.11 (Load)
/iLatch2: U2.10, U12.11 (Load)
/i~DelayedOut1: U4.4, U4.5, U6.13 (O2)
/i~Out1: U11.1 (OE), U100.12
/i~Out2: U6.10 (O5), U12.1 (OE)
/pullup: U8.2 (D), U8.4 (~S)
/~IDECS: U4.3, U4.9, U4.12, U6.5 (E2), U10.19 (CE)
/~IDECS': U4.1, U102.12 (O3)
/~IDECSFX0: U4.11, U150.2 (I0a)
/~IDECSFX0': U53.37 (~CS0), U150.18 (O0a)
/~IDECSFX3: U4.8, U150.4 (I1a)
/~IDECSFX3': U53.38 (~CS1), U150.16 (O1a)
/~IDERESET: U53.1 (RESET), U150.3 (O3b)
/~IOR: U3.10, U6.2 (A1), U7.14 (~IOR), U10.1 (A->B), U100.1
/~IORdelayed: U100.8, U150.11 (I0b)
/~IORdelayed': U53.25 (~IOR), U150.9 (O0b)
/~IOW: U1.9, U3.4, U6.1 (A0), U7.13 (~IOW), U150.8 (I3a)
/~IOW': U53.23 (~IOW), U150.12 (O3a)
/~RESET: U2.4, U51.18 (~RESET), U150.17 (I3b)
/~RTCCS: U1.1, U3.2, U51.13 (~CS), U102.15 (O0)
/~RTC_WRTADDR: U1.8, U202.11
/~RTC_WRTADDRdelay: U202.1, U202.12
/~RTC_XIOR: U3.8, U51.17 (DS)
/~RTC_XIOW: U3.6, U51.15 (R/~W)
Earth: U1.7 (GND), U2.7 (GND), U3.7 (GND), U4.2, U4.7 (GND), U5.7 (GND), U6.8 (GND), U7.1 (GND), U7.31 (GND), U10.10 (GND), U11.10 (GND), U12.10 (GND), U51.1 (MOT), U51.12 (GND), U53.2 (GND), U53.19 (GND), U53.22 (GND), U53.24 (GND), U53.26 (CBL_SLCT), U53.40 (GND), U100.7 (GND), U102.8 (GND), U150.1 (OEa), U150.10 (GND), U150.19 (OEb), U202.7 (GND)
unnamed: J3.1, U19.1 (line1)
unnamed: JLED1.1, U53.39 (~LED)
unnamed: U1.6, U8.1 (~R)
unnamed: U1.3, U1.10
unnamed: U1.4, U1.5, U1.11
unnamed: U1.12, U1.13, U202.8
unnamed: U2.6, U4.10
unnamed: U2.8, U6.6 (E3)
unnamed: U2.9, U3.11
unnamed: U2.11, U6.14 (O1)
unnamed: U2.13, U6.9 (O6)
unnamed: U3.1, U5.11
unnamed: U3.3, U3.5, U3.9
unnamed: U8.10 (~S), U8.11 (C), U8.12 (D), U8.13 (~R)
unnamed: U100.2, U100.3
unnamed: U100.4, U100.5
unnamed: U100.6, U100.9
unnamed: U100.10, U100.13
unnamed: U4.6, U100.11
unnamed: U5.3, U102.5 (E2)
unnamed: U8.3 (C), U202.2
unnamed: U8.6 (~Q), U202.3
unnamed: U202.4, U202.5
unnamed: U5.9, U5.10, U202.6
unnamed: U5.8, U202.9
unnamed: U202.10, U202.13

Notes on the sheet:
o pino (21) não pode tocar GND (1) senão os dados vao a merda
~~12ns
A combinação de ~CSFX0~,~3~: ~CSFX~ = { 0,1 } comando ~CSFX~ = { 1,0 } controlo outra opção IDE afasta o databus (coloca o databus em alta impedância)
2 presas controlam em dois acessos o que é lido e escrito na interface IDE
_______________
aqui nao se justifica transceiver... nao tem bus local
se porta 1 (A0=1) é possivel ler/escrever no endereço prendido antes pelo RTC
0x3Fx
0x1Fx
0x7x
0x17x
0xFx
0x27x
0x2Fx
0x37x
desligado por agora
se FOR o registo de dados A1=0, A2=0, A3=0
leitura: 1F0 (byte low), seguido 1F1 (byte hi) - faz 1 leitura escrita 1F1 (byte hi), seguido de 1F0 (byte low) - faz 2 escritas (a 1ª com o byte baixo inválido, 2ª já com os 2 bytes)
IDE poem os dados por mais tempo e dá tempo à latch2 de agarrar os dados altos na 1ª leitura
se porta 0 e WRITE, é feito um pulso (ADS) para que o RTC prenda o "endereço do registo " que está no databus
o pulso para o RTC é feito com o Flipflop

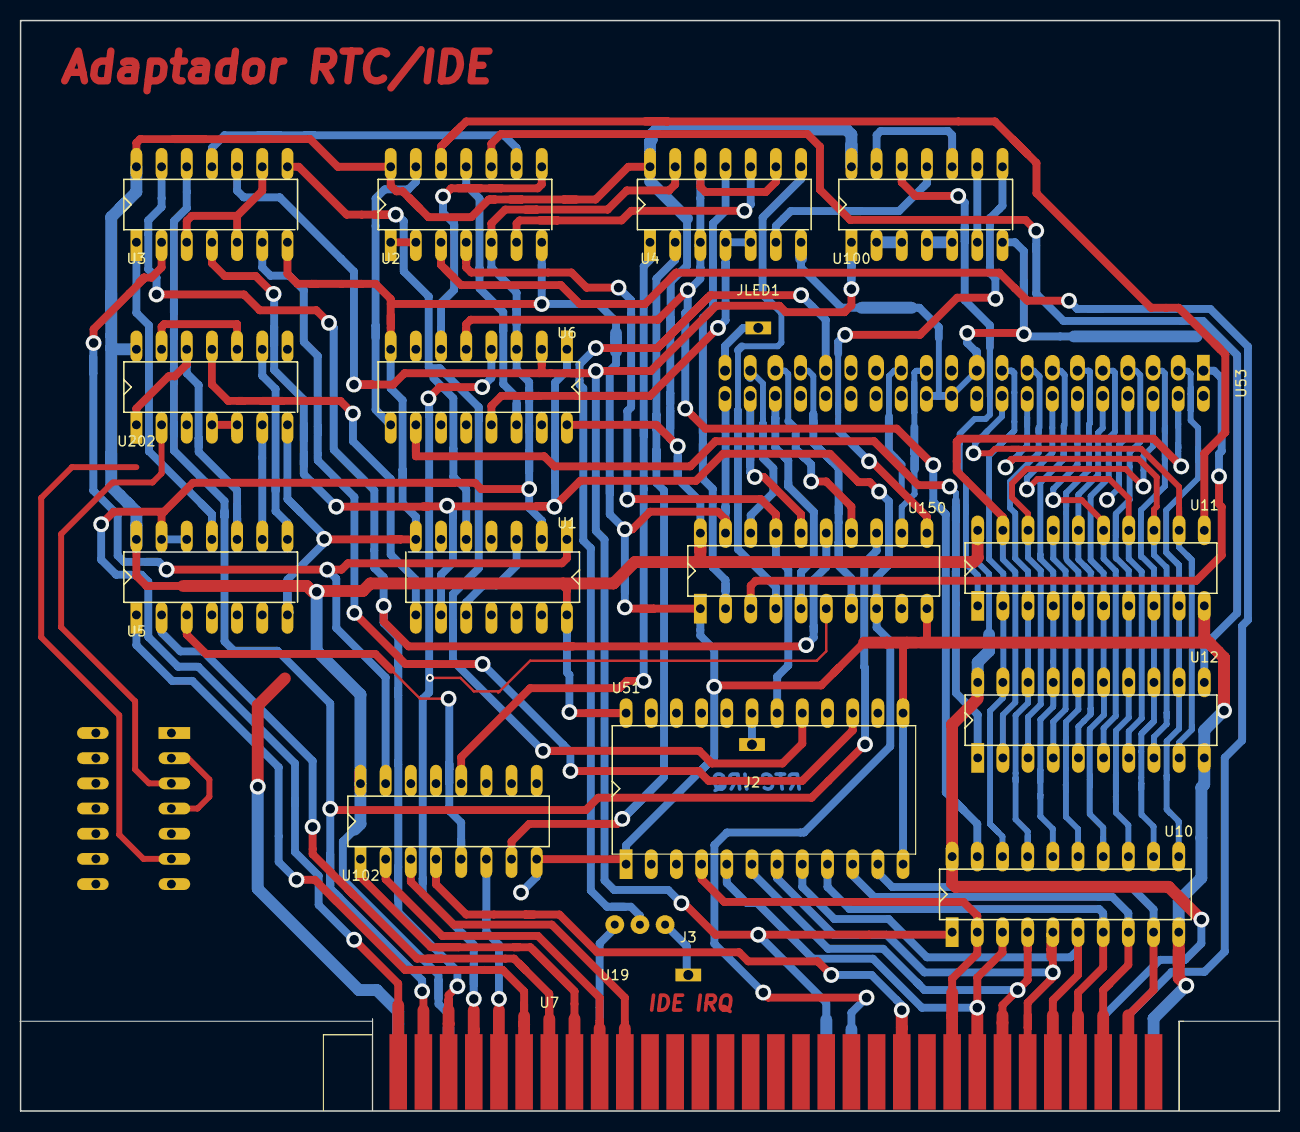
[picture p18: board ide.kicad_pcb from above]

Board: 2 copper layers, 127.0 x 110.0 mm, 21 parts (1 on the bottom side), 96 nets.
