woreno/IBM-PC-XT-compatible/KICAD/dram/dram.kicad_pcb

## KiCad design KICAD/dram/dram.kicad_pcb (2026-11-09)

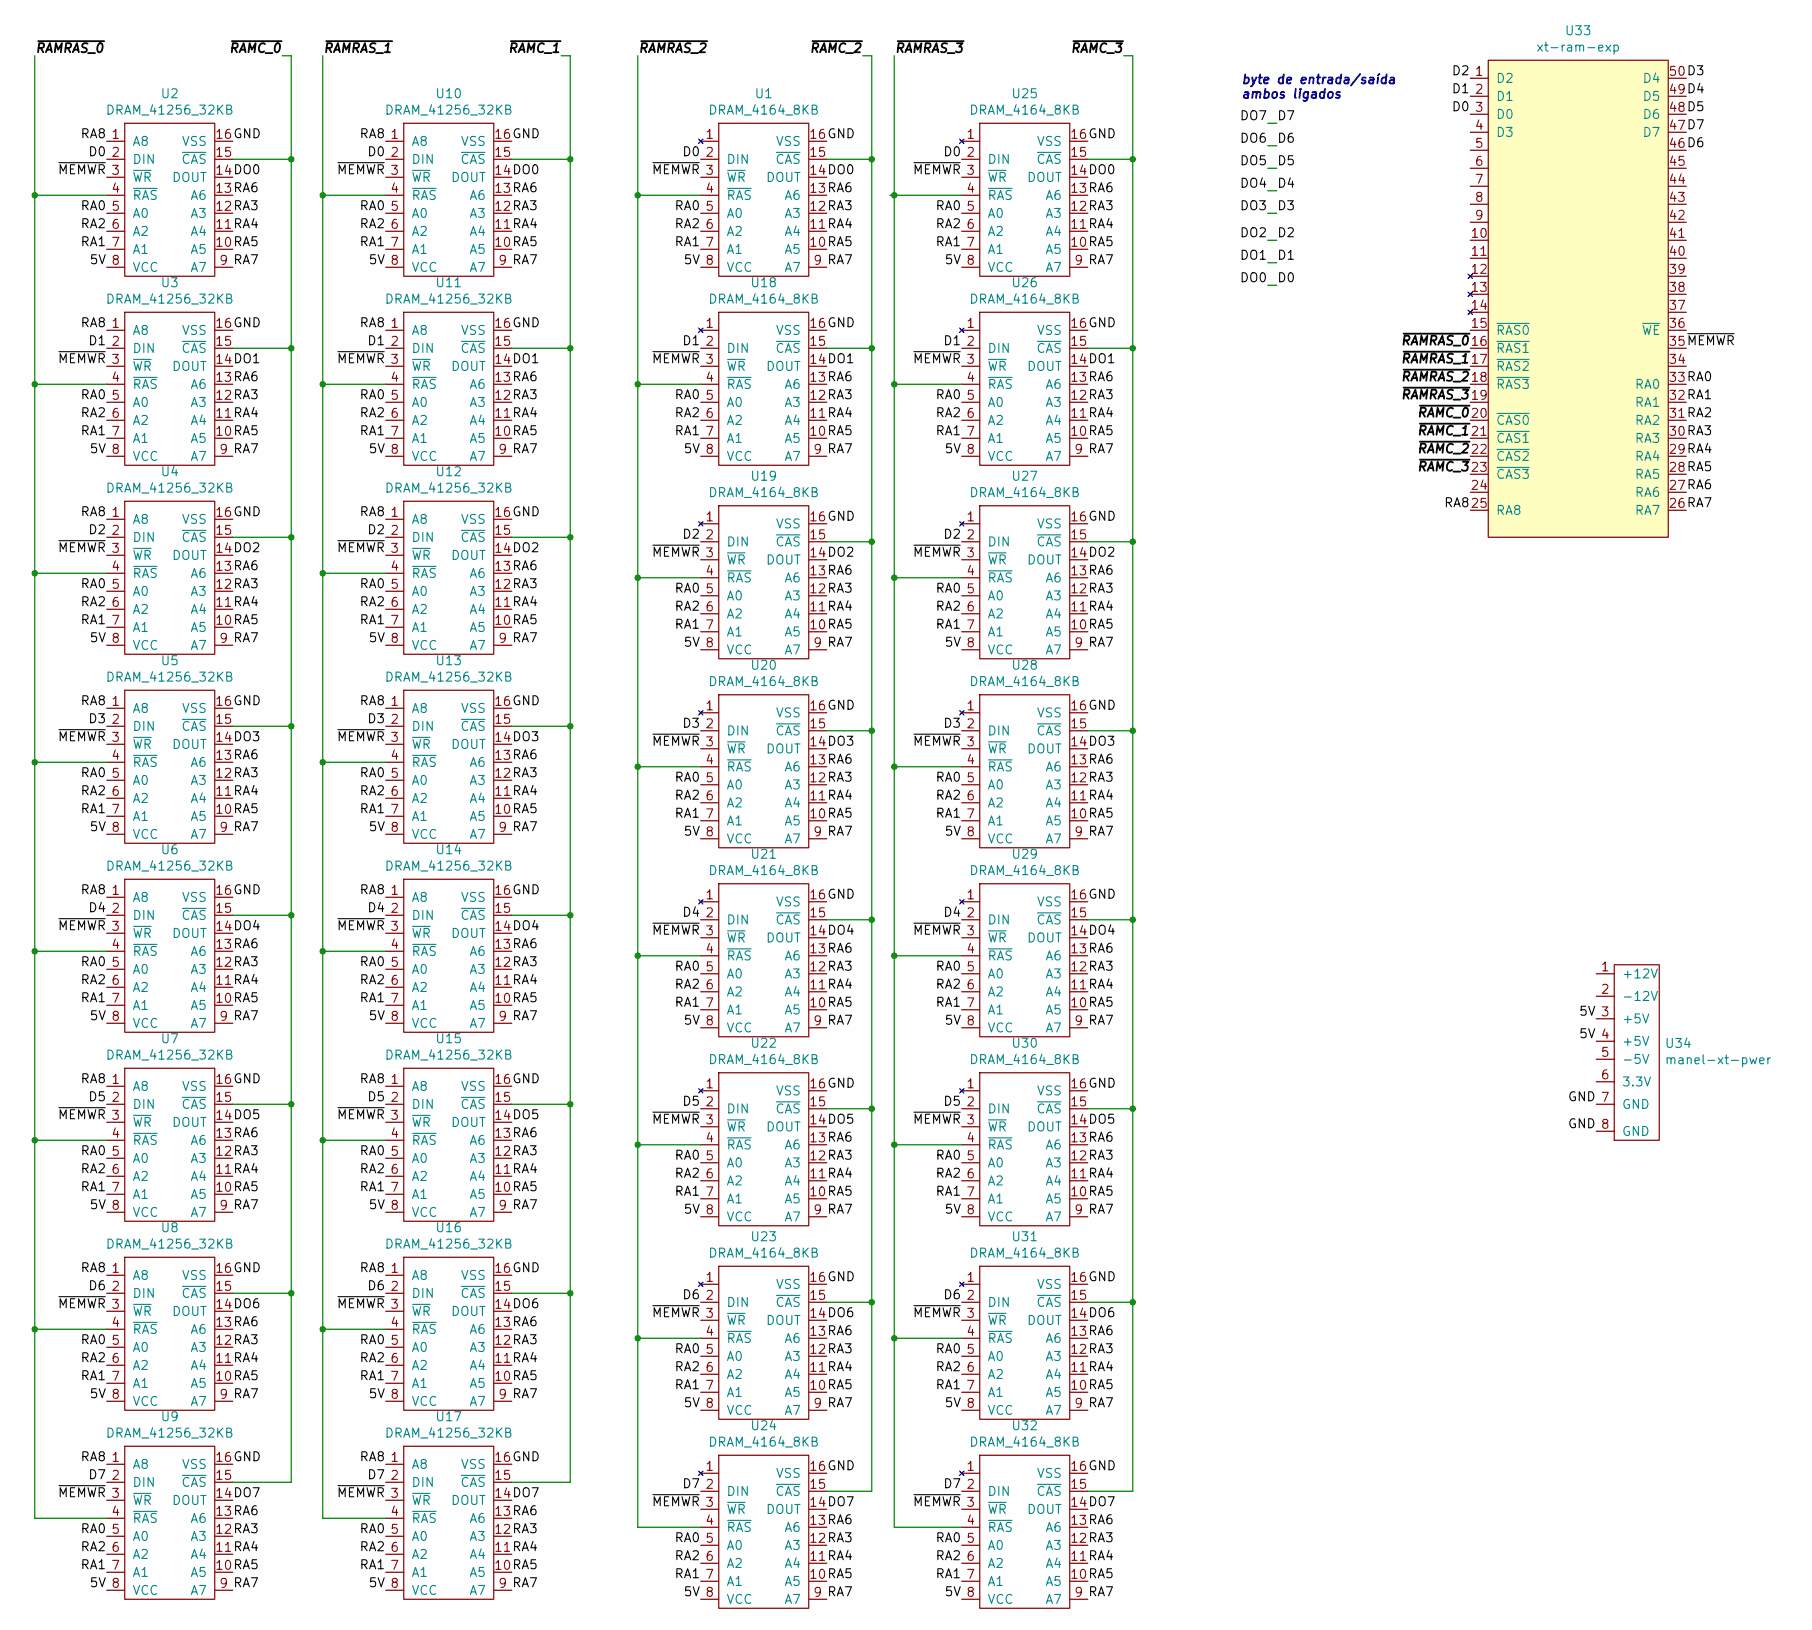
[picture p19: schematic dram.sch]

Parts:
U1, U18, U19, U20, U21, U22, U23, U24, U25, U26, U27, U28, U29, U30, U31, U32: DRAM_4164_8KB; standard_DIP_16OvalPins
U2, U3, U4, U5, U6, U7, U8, U9, U10, U11, U12, U13, U14, U15, U16, U17: DRAM_41256_32KB; standard_DIP_16OvalPins
U33: xt-ram-exp; xt-ram-edge
U34: manel-xt-pwer; manel-xt-power

Connections:
/5V: U1.8 (VCC), U2.8 (VCC), U3.8 (VCC), U4.8 (VCC), U5.8 (VCC), U6.8 (VCC), U7.8 (VCC), U8.8 (VCC), U9.8 (VCC), U10.8 (VCC), U11.8 (VCC), U12.8 (VCC), U13.8 (VCC), U14.8 (VCC), U15.8 (VCC), U16.8 (VCC), U17.8 (VCC), U18.8 (VCC), U19.8 (VCC), U20.8 (VCC), U21.8 (VCC), U22.8 (VCC), U23.8 (VCC), U24.8 (VCC), U25.8 (VCC), U26.8 (VCC), U27.8 (VCC), U28.8 (VCC), U29.8 (VCC), U30.8 (VCC), U31.8 (VCC), U32.8 (VCC), U34.3 (+5V), U34.4 (+5V)
/D0: U1.2 (DIN), U1.14 (DOUT), U2.2 (DIN), U2.14 (DOUT), U10.2 (DIN), U10.14 (DOUT), U25.2 (DIN), U25.14 (DOUT), U33.3 (D0)
/D1: U3.2 (DIN), U3.14 (DOUT), U11.2 (DIN), U11.14 (DOUT), U18.2 (DIN), U18.14 (DOUT), U26.2 (DIN), U26.14 (DOUT), U33.2 (D1)
/D2: U4.2 (DIN), U4.14 (DOUT), U12.2 (DIN), U12.14 (DOUT), U19.2 (DIN), U19.14 (DOUT), U27.2 (DIN), U27.14 (DOUT), U33.1 (D2)
/D3: U5.2 (DIN), U5.14 (DOUT), U13.2 (DIN), U13.14 (DOUT), U20.2 (DIN), U20.14 (DOUT), U28.2 (DIN), U28.14 (DOUT), U33.50 (D4)
/D4: U6.2 (DIN), U6.14 (DOUT), U14.2 (DIN), U14.14 (DOUT), U21.2 (DIN), U21.14 (DOUT), U29.2 (DIN), U29.14 (DOUT), U33.49 (D5)
/D5: U7.2 (DIN), U7.14 (DOUT), U15.2 (DIN), U15.14 (DOUT), U22.2 (DIN), U22.14 (DOUT), U30.2 (DIN), U30.14 (DOUT), U33.48 (D6)
/D6: U8.2 (DIN), U8.14 (DOUT), U16.2 (DIN), U16.14 (DOUT), U23.2 (DIN), U23.14 (DOUT), U31.2 (DIN), U31.14 (DOUT), U33.46
/D7: U9.2 (DIN), U9.14 (DOUT), U17.2 (DIN), U17.14 (DOUT), U24.2 (DIN), U24.14 (DOUT), U32.2 (DIN), U32.14 (DOUT), U33.47 (D7)
/GND: U1.16 (VSS), U2.16 (VSS), U3.16 (VSS), U4.16 (VSS), U5.16 (VSS), U6.16 (VSS), U7.16 (VSS), U8.16 (VSS), U9.16 (VSS), U10.16 (VSS), U11.16 (VSS), U12.16 (VSS), U13.16 (VSS), U14.16 (VSS), U15.16 (VSS), U16.16 (VSS), U17.16 (VSS), U18.16 (VSS), U19.16 (VSS), U20.16 (VSS), U21.16 (VSS), U22.16 (VSS), U23.16 (VSS), U24.16 (VSS), U25.16 (VSS), U26.16 (VSS), U27.16 (VSS), U28.16 (VSS), U29.16 (VSS), U30.16 (VSS), U31.16 (VSS), U32.16 (VSS), U34.7 (GND), U34.8 (GND)
/RA0: U1.5 (A0), U2.5 (A0), U3.5 (A0), U4.5 (A0), U5.5 (A0), U6.5 (A0), U7.5 (A0), U8.5 (A0), U9.5 (A0), U10.5 (A0), U11.5 (A0), U12.5 (A0), U13.5 (A0), U14.5 (A0), U15.5 (A0), U16.5 (A0), U17.5 (A0), U18.5 (A0), U19.5 (A0), U20.5 (A0), U21.5 (A0), U22.5 (A0), U23.5 (A0), U24.5 (A0), U25.5 (A0), U26.5 (A0), U27.5 (A0), U28.5 (A0), U29.5 (A0), U30.5 (A0), U31.5 (A0), U32.5 (A0), U33.33 (RA0)
/RA1: U1.7 (A1), U2.7 (A1), U3.7 (A1), U4.7 (A1), U5.7 (A1), U6.7 (A1), U7.7 (A1), U8.7 (A1), U9.7 (A1), U10.7 (A1), U11.7 (A1), U12.7 (A1), U13.7 (A1), U14.7 (A1), U15.7 (A1), U16.7 (A1), U17.7 (A1), U18.7 (A1), U19.7 (A1), U20.7 (A1), U21.7 (A1), U22.7 (A1), U23.7 (A1), U24.7 (A1), U25.7 (A1), U26.7 (A1), U27.7 (A1), U28.7 (A1), U29.7 (A1), U30.7 (A1), U31.7 (A1), U32.7 (A1), U33.32 (RA1)
/RA2: U1.6 (A2), U2.6 (A2), U3.6 (A2), U4.6 (A2), U5.6 (A2), U6.6 (A2), U7.6 (A2), U8.6 (A2), U9.6 (A2), U10.6 (A2), U11.6 (A2), U12.6 (A2), U13.6 (A2), U14.6 (A2), U15.6 (A2), U16.6 (A2), U17.6 (A2), U18.6 (A2), U19.6 (A2), U20.6 (A2), U21.6 (A2), U22.6 (A2), U23.6 (A2), U24.6 (A2), U25.6 (A2), U26.6 (A2), U27.6 (A2), U28.6 (A2), U29.6 (A2), U30.6 (A2), U31.6 (A2), U32.6 (A2), U33.31 (RA2)
/RA3: U1.12 (A3), U2.12 (A3), U3.12 (A3), U4.12 (A3), U5.12 (A3), U6.12 (A3), U7.12 (A3), U8.12 (A3), U9.12 (A3), U10.12 (A3), U11.12 (A3), U12.12 (A3), U13.12 (A3), U14.12 (A3), U15.12 (A3), U16.12 (A3), U17.12 (A3), U18.12 (A3), U19.12 (A3), U20.12 (A3), U21.12 (A3), U22.12 (A3), U23.12 (A3), U24.12 (A3), U25.12 (A3), U26.12 (A3), U27.12 (A3), U28.12 (A3), U29.12 (A3), U30.12 (A3), U31.12 (A3), U32.12 (A3), U33.30 (RA3)
/RA4: U1.11 (A4), U2.11 (A4), U3.11 (A4), U4.11 (A4), U5.11 (A4), U6.11 (A4), U7.11 (A4), U8.11 (A4), U9.11 (A4), U10.11 (A4), U11.11 (A4), U12.11 (A4), U13.11 (A4), U14.11 (A4), U15.11 (A4), U16.11 (A4), U17.11 (A4), U18.11 (A4), U19.11 (A4), U20.11 (A4), U21.11 (A4), U22.11 (A4), U23.11 (A4), U24.11 (A4), U25.11 (A4), U26.11 (A4), U27.11 (A4), U28.11 (A4), U29.11 (A4), U30.11 (A4), U31.11 (A4), U32.11 (A4), U33.29 (RA4)
/RA5: U1.10 (A5), U2.10 (A5), U3.10 (A5), U4.10 (A5), U5.10 (A5), U6.10 (A5), U7.10 (A5), U8.10 (A5), U9.10 (A5), U10.10 (A5), U11.10 (A5), U12.10 (A5), U13.10 (A5), U14.10 (A5), U15.10 (A5), U16.10 (A5), U17.10 (A5), U18.10 (A5), U19.10 (A5), U20.10 (A5), U21.10 (A5), U22.10 (A5), U23.10 (A5), U24.10 (A5), U25.10 (A5), U26.10 (A5), U27.10 (A5), U28.10 (A5), U29.10 (A5), U30.10 (A5), U31.10 (A5), U32.10 (A5), U33.28 (RA5)
/RA6: U1.13 (A6), U2.13 (A6), U3.13 (A6), U4.13 (A6), U5.13 (A6), U6.13 (A6), U7.13 (A6), U8.13 (A6), U9.13 (A6), U10.13 (A6), U11.13 (A6), U12.13 (A6), U13.13 (A6), U14.13 (A6), U15.13 (A6), U16.13 (A6), U17.13 (A6), U18.13 (A6), U19.13 (A6), U20.13 (A6), U21.13 (A6), U22.13 (A6), U23.13 (A6), U24.13 (A6), U25.13 (A6), U26.13 (A6), U27.13 (A6), U28.13 (A6), U29.13 (A6), U30.13 (A6), U31.13 (A6), U32.13 (A6), U33.27 (RA6)
/RA7: U1.9 (A7), U2.9 (A7), U3.9 (A7), U4.9 (A7), U5.9 (A7), U6.9 (A7), U7.9 (A7), U8.9 (A7), U9.9 (A7), U10.9 (A7), U11.9 (A7), U12.9 (A7), U13.9 (A7), U14.9 (A7), U15.9 (A7), U16.9 (A7), U17.9 (A7), U18.9 (A7), U19.9 (A7), U20.9 (A7), U21.9 (A7), U22.9 (A7), U23.9 (A7), U24.9 (A7), U25.9 (A7), U26.9 (A7), U27.9 (A7), U28.9 (A7), U29.9 (A7), U30.9 (A7), U31.9 (A7), U32.9 (A7), U33.26 (RA7)
/RA8: U2.1 (A8), U3.1 (A8), U4.1 (A8), U5.1 (A8), U6.1 (A8), U7.1 (A8), U8.1 (A8), U9.1 (A8), U10.1 (A8), U11.1 (A8), U12.1 (A8), U13.1 (A8), U14.1 (A8), U15.1 (A8), U16.1 (A8), U17.1 (A8), U33.25 (RA8)
/~MEMWR: U1.3 (~WR), U2.3 (~WR), U3.3 (~WR), U4.3 (~WR), U5.3 (~WR), U6.3 (~WR), U7.3 (~WR), U8.3 (~WR), U9.3 (~WR), U10.3 (~WR), U11.3 (~WR), U12.3 (~WR), U13.3 (~WR), U14.3 (~WR), U15.3 (~WR), U16.3 (~WR), U17.3 (~WR), U18.3 (~WR), U19.3 (~WR), U20.3 (~WR), U21.3 (~WR), U22.3 (~WR), U23.3 (~WR), U24.3 (~WR), U25.3 (~WR), U26.3 (~WR), U27.3 (~WR), U28.3 (~WR), U29.3 (~WR), U30.3 (~WR), U31.3 (~WR), U32.3 (~WR), U33.35
/~RAMC_0: U2.15 (~CAS), U3.15 (~CAS), U4.15 (~CAS), U5.15 (~CAS), U6.15 (~CAS), U7.15 (~CAS), U8.15 (~CAS), U9.15 (~CAS), U33.20 (~CAS0)
/~RAMC_1: U10.15 (~CAS), U11.15 (~CAS), U12.15 (~CAS), U13.15 (~CAS), U14.15 (~CAS), U15.15 (~CAS), U16.15 (~CAS), U17.15 (~CAS), U33.21 (~CAS1)
/~RAMC_2: U1.15 (~CAS), U18.15 (~CAS), U19.15 (~CAS), U20.15 (~CAS), U21.15 (~CAS), U22.15 (~CAS), U23.15 (~CAS), U24.15 (~CAS), U33.22 (~CAS2)
/~RAMC_3: U25.15 (~CAS), U26.15 (~CAS), U27.15 (~CAS), U28.15 (~CAS), U29.15 (~CAS), U30.15 (~CAS), U31.15 (~CAS), U32.15 (~CAS), U33.23 (~CAS3)
/~RAMRAS_0: U2.4 (~RAS), U3.4 (~RAS), U4.4 (~RAS), U5.4 (~RAS), U6.4 (~RAS), U7.4 (~RAS), U8.4 (~RAS), U9.4 (~RAS), U33.16 (~RAS1)
/~RAMRAS_1: U10.4 (~RAS), U11.4 (~RAS), U12.4 (~RAS), U13.4 (~RAS), U14.4 (~RAS), U15.4 (~RAS), U16.4 (~RAS), U17.4 (~RAS), U33.17 (~RAS2)
/~RAMRAS_2: U1.4 (~RAS), U18.4 (~RAS), U19.4 (~RAS), U20.4 (~RAS), U21.4 (~RAS), U22.4 (~RAS), U23.4 (~RAS), U24.4 (~RAS), U33.18 (~RAS3)
/~RAMRAS_3: U25.4 (~RAS), U26.4 (~RAS), U27.4 (~RAS), U28.4 (~RAS), U29.4 (~RAS), U30.4 (~RAS), U31.4 (~RAS), U32.4 (~RAS), U33.19

Notes on the sheet:
byte de entrada/saída ambos ligados

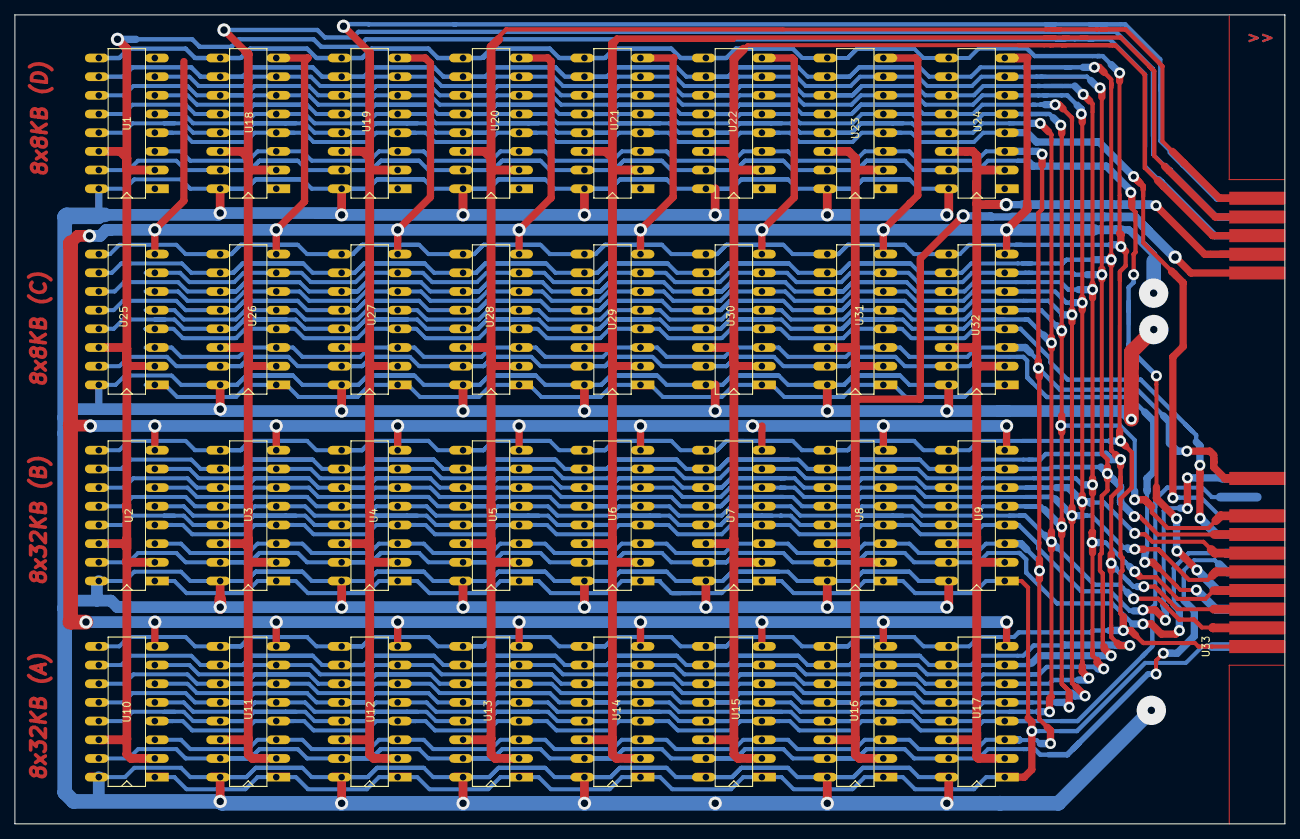
[picture p20: board dram.kicad_pcb from above]

Board: 2 copper layers, 172.7 x 110.0 mm, 33 parts (0 on the bottom side), 28 nets.
