woreno/IBM-PC-XT-compatible/KICAD/fdc/fdc.kicad_pcb

## KiCad design KICAD/fdc/fdc.kicad_pcb (2026-11-09)

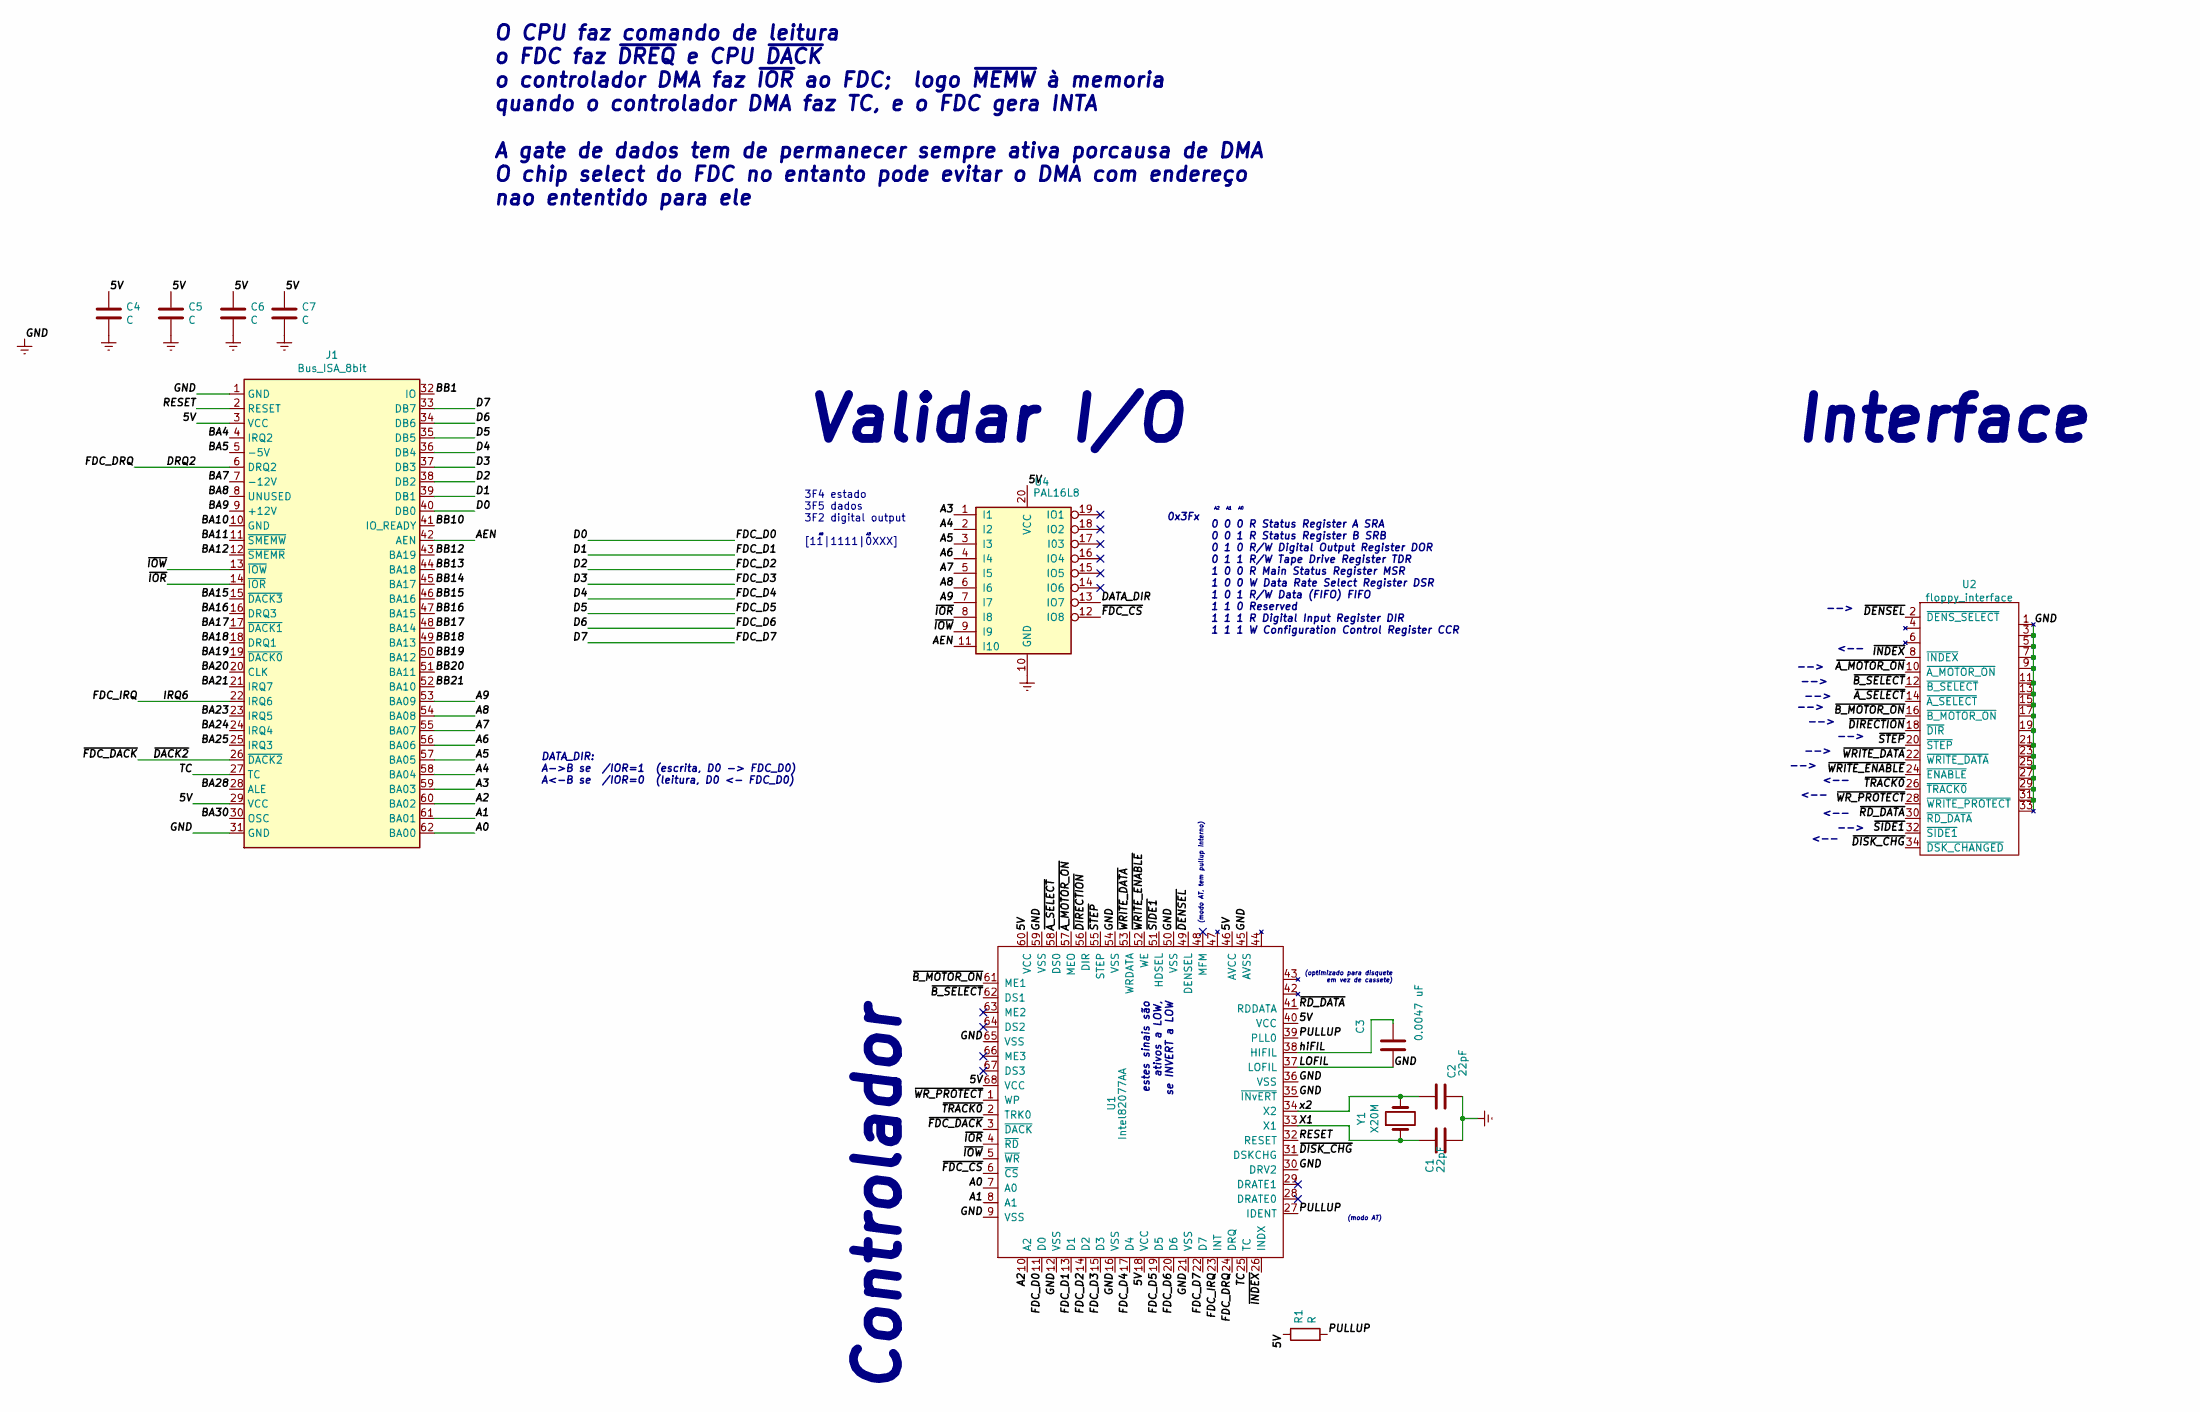
[picture p21: schematic fdc.sch]

Parts:
C1: 22pF; standard_2pins
C2: 22pF; standard_2pins_half
C3: 0.0047 uF; standard_2pins
C4, C5, C6: C; standard_2pins
C7: C; standard_2pins_half
J1: Bus_ISA_8bit; ISA_8bit_edge
R1: R; standard_2pins
U1: Intel82077AA; PLCC-68_SMD-Socket
U2: floppy_interface; PinSocket_2x17_P2.54mm_Vertical
U4: PAL16L8; standard_DIP_20pins_thin_body
Y1: X20M; standard_2pins_half

Connections:
/5V: C4.1, C5.1, C6.1, C7.1, J1.3 (VCC), J1.29 (VCC), R1.1, U1.18 (VCC), U1.40 (VCC), U1.46 (AVCC), U1.60 (VCC), U1.68 (VCC), U4.20 (VCC)
/A0: J1.62 (BA00), U1.7 (A0)
/A1: J1.61 (BA01), U1.8 (A1)
/A2: J1.60 (BA02), U1.10 (A2)
/A3: J1.59 (BA03), U4.1 (I1)
/A4: J1.58 (BA04), U4.2 (I2)
/A5: J1.57 (BA05), U4.3 (I3)
/A6: J1.56 (BA06), U4.4 (I4)
/A7: J1.55 (BA07), U4.5 (I5)
/A8: J1.54 (BA08), U4.6 (I6)
/A9: J1.53 (BA09), U4.7 (I7)
/AEN: J1.42 (AEN), U4.11 (I10)
/BA4: J1.4 (IRQ2)
/BA5: J1.5 (-5V)
/BA7: J1.7 (-12V)
/BA8: J1.8 (UNUSED)
/BA9: J1.9 (+12V)
/BA10: J1.10 (GND)
/BA11: J1.11 (~SMEMW)
/BA12: J1.12 (~SMEMR)
/BA15: J1.15 (~DACK3)
/BA16: J1.16 (DRQ3)
/BA17: J1.17 (~DACK1)
/BA18: J1.18 (DRQ1)
/BA19: J1.19 (~DACK0)
/BA20: J1.20 (CLK)
/BA21: J1.21 (IRQ7)
/BA23: J1.23 (IRQ5)
/BA24: J1.24 (IRQ4)
/BA25: J1.25 (IRQ3)
/BA28: J1.28 (ALE)
/BA30: J1.30 (OSC)
/BB1: J1.32 (IO)
/BB10: J1.41 (IO_READY)
/BB12: J1.43 (BA19)
/BB13: J1.44 (BA18)
/BB14: J1.45 (BA17)
/BB15: J1.46 (BA16)
/BB16: J1.47 (BA15)
/BB17: J1.48 (BA14)
/BB18: J1.49 (BA13)
/BB19: J1.50 (BA12)
/BB20: J1.51 (BA11)
/BB21: J1.52 (BA10)
/D0: J1.40 (DB0), U1.11 (D0)
/D1: J1.39 (DB1), U1.13 (D1)
/D2: J1.38 (DB2), U1.14 (D2)
/D3: J1.37 (DB3), U1.15 (D3)
/D4: J1.36 (DB4), U1.17 (D4)
/D5: J1.35 (DB5), U1.19 (D5)
/D6: J1.34 (DB6), U1.20 (D6)
/D7: J1.33 (DB7), U1.22 (D7)
/DATA_DIR: U4.13 (IO7)
/DRQ2: J1.6 (DRQ2), U1.24 (DRQ)
/FDC_IRQ: J1.22 (IRQ6), U1.23 (INT)
/PULLUP: R1.2, U1.27 (IDENT), U1.39 (PLL0)
/RESET: J1.2 (RESET), U1.32 (RESET)
/TC: J1.27 (TC), U1.25 (TC)
/X1: C1.1, U1.33 (X1), Y1.1
/hiFIL: C3.1, U1.38 (HIFIL)
/x2: C2.2, U1.34 (X2), Y1.2
/~A_MOTOR_ON: U1.57 (MEO), U2.10 (~A_MOTOR_ON)
/~A_SELECT: U1.58 (DS0), U2.14 (~A_SELECT)
/~B_MOTOR_ON: U1.61 (ME1), U2.16 (~B_MOTOR_ON)
/~B_SELECT: U1.62 (DS1), U2.12 (~B_SELECT)
/~DACK2: J1.26 (~DACK2), U1.3 (~DACK)
/~DENSEL: U1.49 (DENSEL), U2.2 (~DENS_SELECT)
/~DIRECTION: U1.56 (DIR), U2.18 (~DIR)
/~DISK_CHG: U1.31 (DSKCHG), U2.34 (~DSK_CHANGED)
/~FDC_CS: U1.6 (~CS), U4.12 (IO8)
/~INDEX: U1.26 (INDX), U2.8 (~INDEX)
/~IOR: J1.14 (~IOR), U1.4 (~RD), U4.8 (I8)
/~IOW: J1.13 (~IOW), U1.5 (~WR), U4.9 (I9)
/~RD_DATA: U1.41 (RDDATA), U2.30 (~RD_DATA)
/~SIDE1: U1.51 (HDSEL), U2.32 (~SIDE1)
/~STEP: U1.55 (STEP), U2.20 (~STEP)
/~TRACK0: U1.2 (TRK0), U2.26 (~TRACK0)
/~WRITE_DATA: U1.53 (WRDATA), U2.22 (~WRITE_DATA)
/~WRITE_ENABLE: U1.52 (WE), U2.24 (~ENABLE)
/~WR_PROTECT: U1.1 (WP), U2.28 (~WRITE_PROTECT)
Earth: C1.2, C2.1, C3.2, C4.2, C5.2, C6.2, C7.2, J1.1 (GND), J1.31 (GND), U1.9 (VSS), U1.12 (VSS), U1.16 (VSS), U1.21 (VSS), U1.30 (DRV2), U1.35 (~INvERT), U1.36 (VSS), U1.37 (LOFIL), U1.45 (AVSS), U1.50 (VSS), U1.54 (VSS), U1.59 (VSS), U1.65 (VSS), U2.1, U2.3, U2.5, U2.7, U2.9, U2.11, U2.13, U2.15, U2.17, U2.19, U2.21, U2.23, U2.25, U2.27, U2.29, U2.31, U2.33, U4.10 (GND)

Notes on the sheet:
0 0 0 R Status Register A SRA 0 0 1 R Status Register B SRB 0 1 0 R/W Digital Output Register DOR 0 1 1 R/W Tape Drive Register TDR 1 0 0 R Main Status Register MSR 1 0 0 W Data Rate Select Register DSR 1 0 1 R/W Data (FIFO) FIFO 1 1 0 Reserved 1 1 1 R Digital Input Register DIR 1 1 1 W Configurati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
A2 A1 A0
0x3Fx
(modo AT)
estes sinais são ativos a LOW, se INVERT a LOW
(modo AT, tem pullup interno)
(optimizado para disquete em vez de cassete)
3F4 estado 3F5 dados 3F2 digital output [11|1111|0XXX]
<--
-->
Controlador
Interface
Validar I/O
O CPU faz comando de leitura o FDC faz ~DREQ~ e CPU ~DACK~ o controlador DMA faz ~IOR~ ao FDC; logo ~MEMW~ à memoria quando o controlador DMA faz TC, e o FDC gera INTA A gate de dados tem de permanecer sempre ativa porcausa de DMA O chip select do FDC no entanto pode evitar o DMA com endereço nao e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
DATA_DIR: A->B se /IOR=1 (escrita, D0 -> FDC_D0) A<-B se /IOR=0 (leitura, D0 <- FDC_D0)

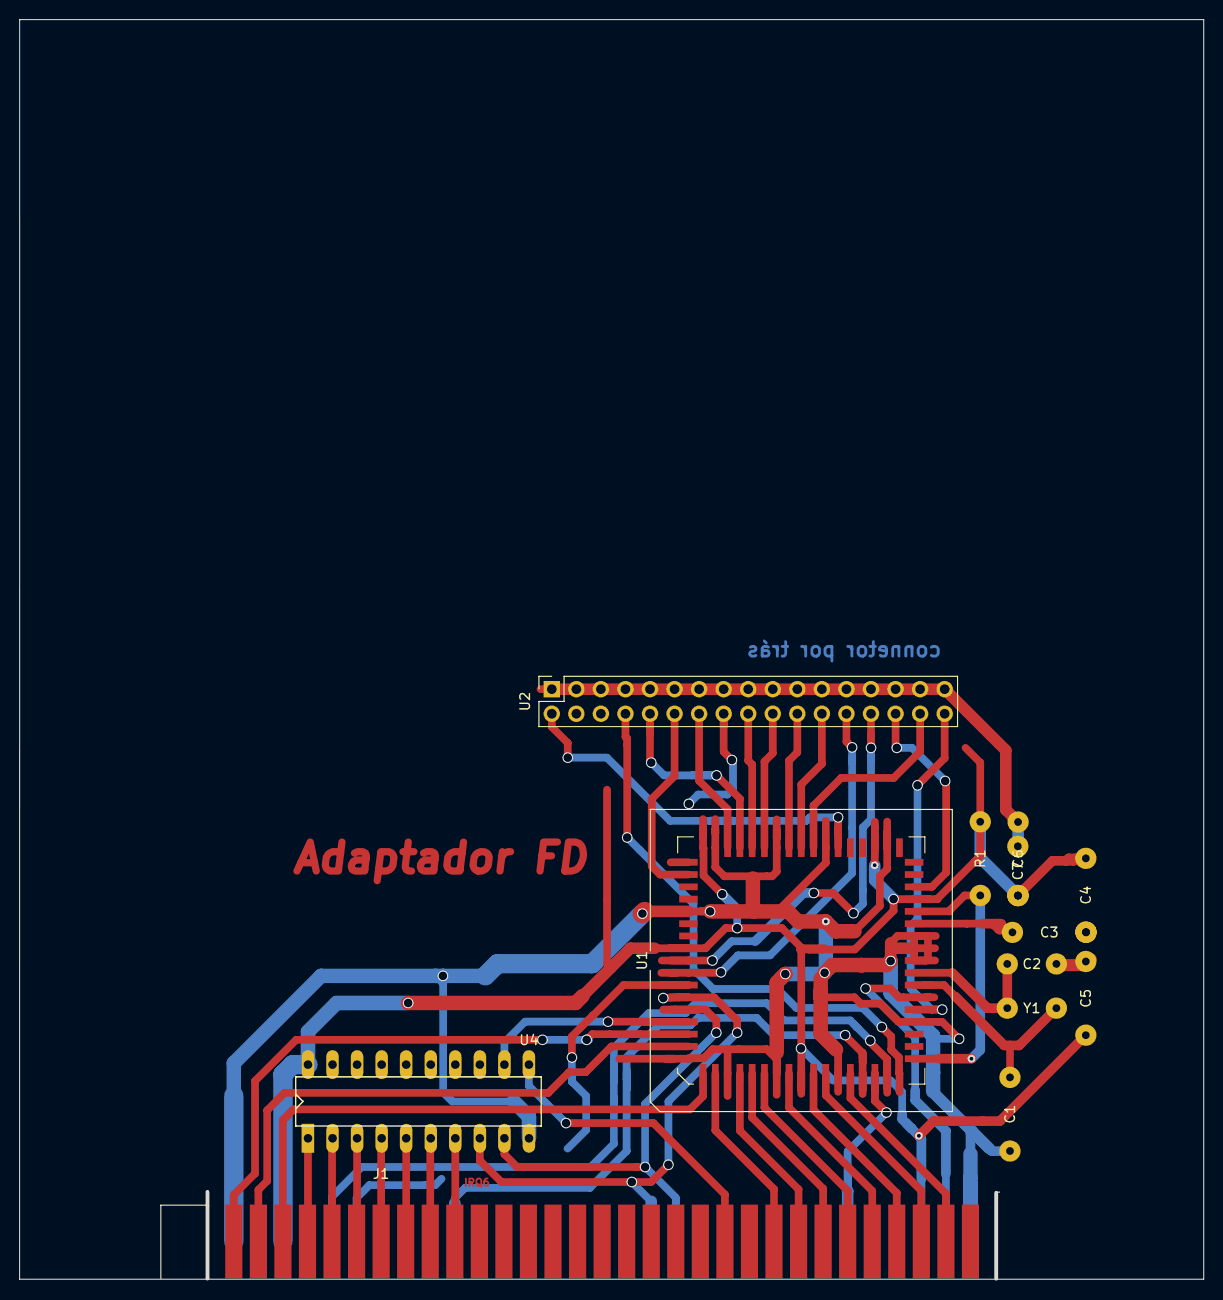
[picture p22: board fdc.kicad_pcb from above]

Board: 2 copper layers, 122.5 x 130.3 mm, 13 parts (0 on the bottom side), 47 nets.
