woreno/IBM-PC-XT-compatible/KICAD/aux_display_board/auxdisplay/auxdisplay.kicad_pcb

## KiCad design KICAD/aux_display_board/auxdisplay/auxdisplay.kicad_pcb (2026-11-09)

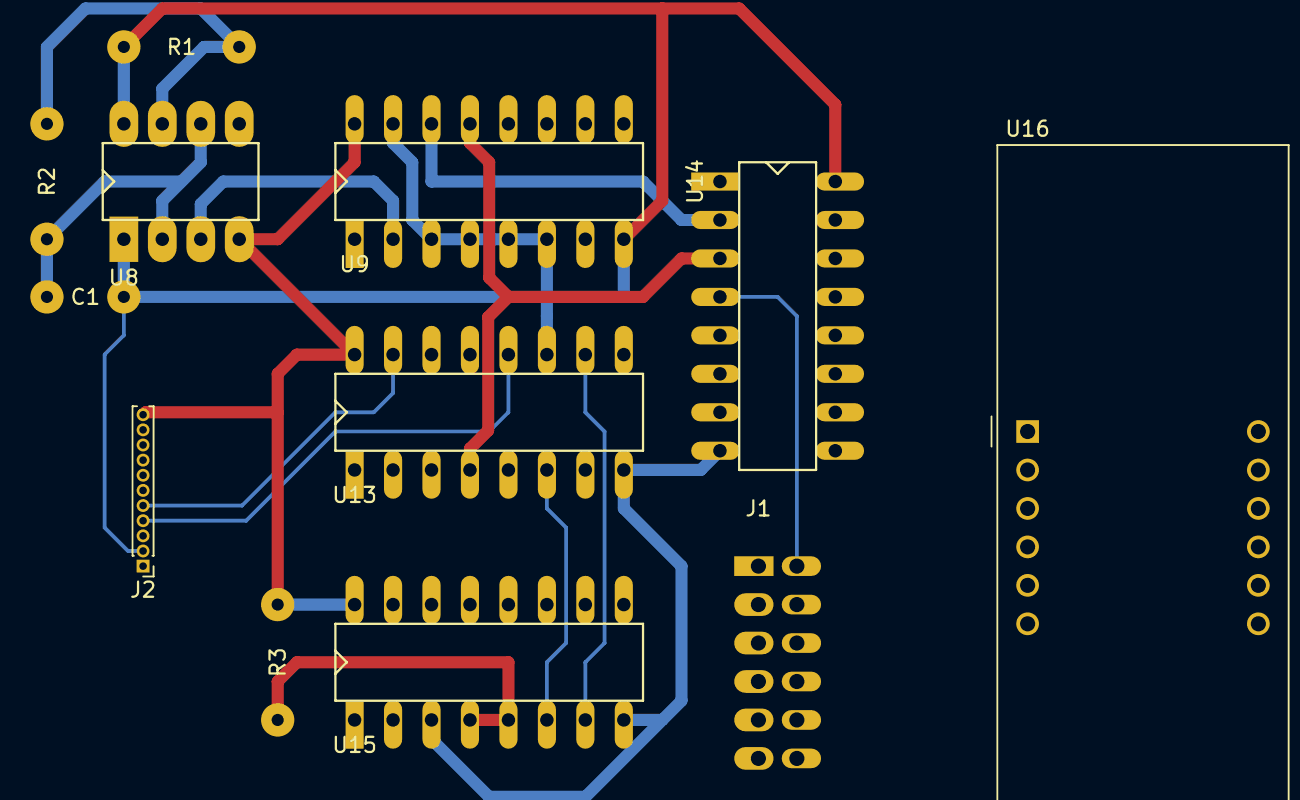
[picture p23: board auxdisplay.kicad_pcb from above]

Board: 2 copper layers, 12 parts (0 on the bottom side), 30 nets.

Parts:
C1: C; standard_2pins_half
J1: Conn_02x06_Counter_Clockwise; Conector2x6_Oval_anticlock
J2: Conn_01x11_Female; PinHeader_1x11_P1.00mm_Vertical
R1, R2, R3: R; standard_2pins
U8: 555; standard_DIP_8pins
U9: 74LS161; standard_DIP_16OvalPins
U13: 74LS670; standard_DIP_16OvalPins
U14: 74LS139; standard_DIP_16OvalPins
U15: DM9368; standard_DIP_16OvalPins
U16: CC56-12SRWA; CA56-12SRWA

Connections:
/5V: J2.11, R1.1, R3.2, U8.4, U8.8, U9.16, U13.16, U14.16, U15.16
/A0: J2.9, U13.14
/A1: J2.10, U13.13
/D0: J2.5, U13.15
/D1: J2.6, U13.1
/D2: J2.7, U13.2
/D3: J2.8, U13.3
/dispA_11: J1.11, U15.13, U16.11
/dispB_7: J1.7, U15.12, U16.7
/dispC0: U9.14, U13.5, U14.2
/dispC1: U9.13, U13.4, U14.3
/dispCLK~: U8.3, U9.2
/dispC_4: J1.4, U15.11, U16.4
/dispD_2: J1.2, U15.10, U16.2
/dispDigit0_12: J1.12, U14.4, U16.6
/dispDigit1_9: J1.9, U14.5, U16.8
/dispDigit2_8: J1.8, U14.6, U16.9
/dispDigit3_6: J1.6, U14.7, U16.12
/dispE_1: J1.1, U15.9, U16.1
/dispF_10: J1.10, U15.15, U16.10
/dispG_5: J1.5, U15.14, U16.5
/dispPullup: R3.1, U9.1, U15.4, U15.5
/~dispCS: J2.4, U13.12
Earth: C1.2, J1.3, J2.2, U8.1, U9.3, U9.4, U9.5, U9.6, U9.8, U9.15, U13.8, U13.11, U14.8, U15.3, U15.8, U16.3
unnamed: C1.1, R2.2, U8.2, U8.6
unnamed: R1.2, R2.1, U8.7
unnamed: U13.6, U15.6
unnamed: U13.7, U15.2
unnamed: U13.9, U15.1
unnamed: U13.10, U15.7
