woreno/IBM-PC-XT-compatible/KICAD/display/display.kicad_pcb

## KiCad design KICAD/display/display.kicad_pcb (2026-11-09)

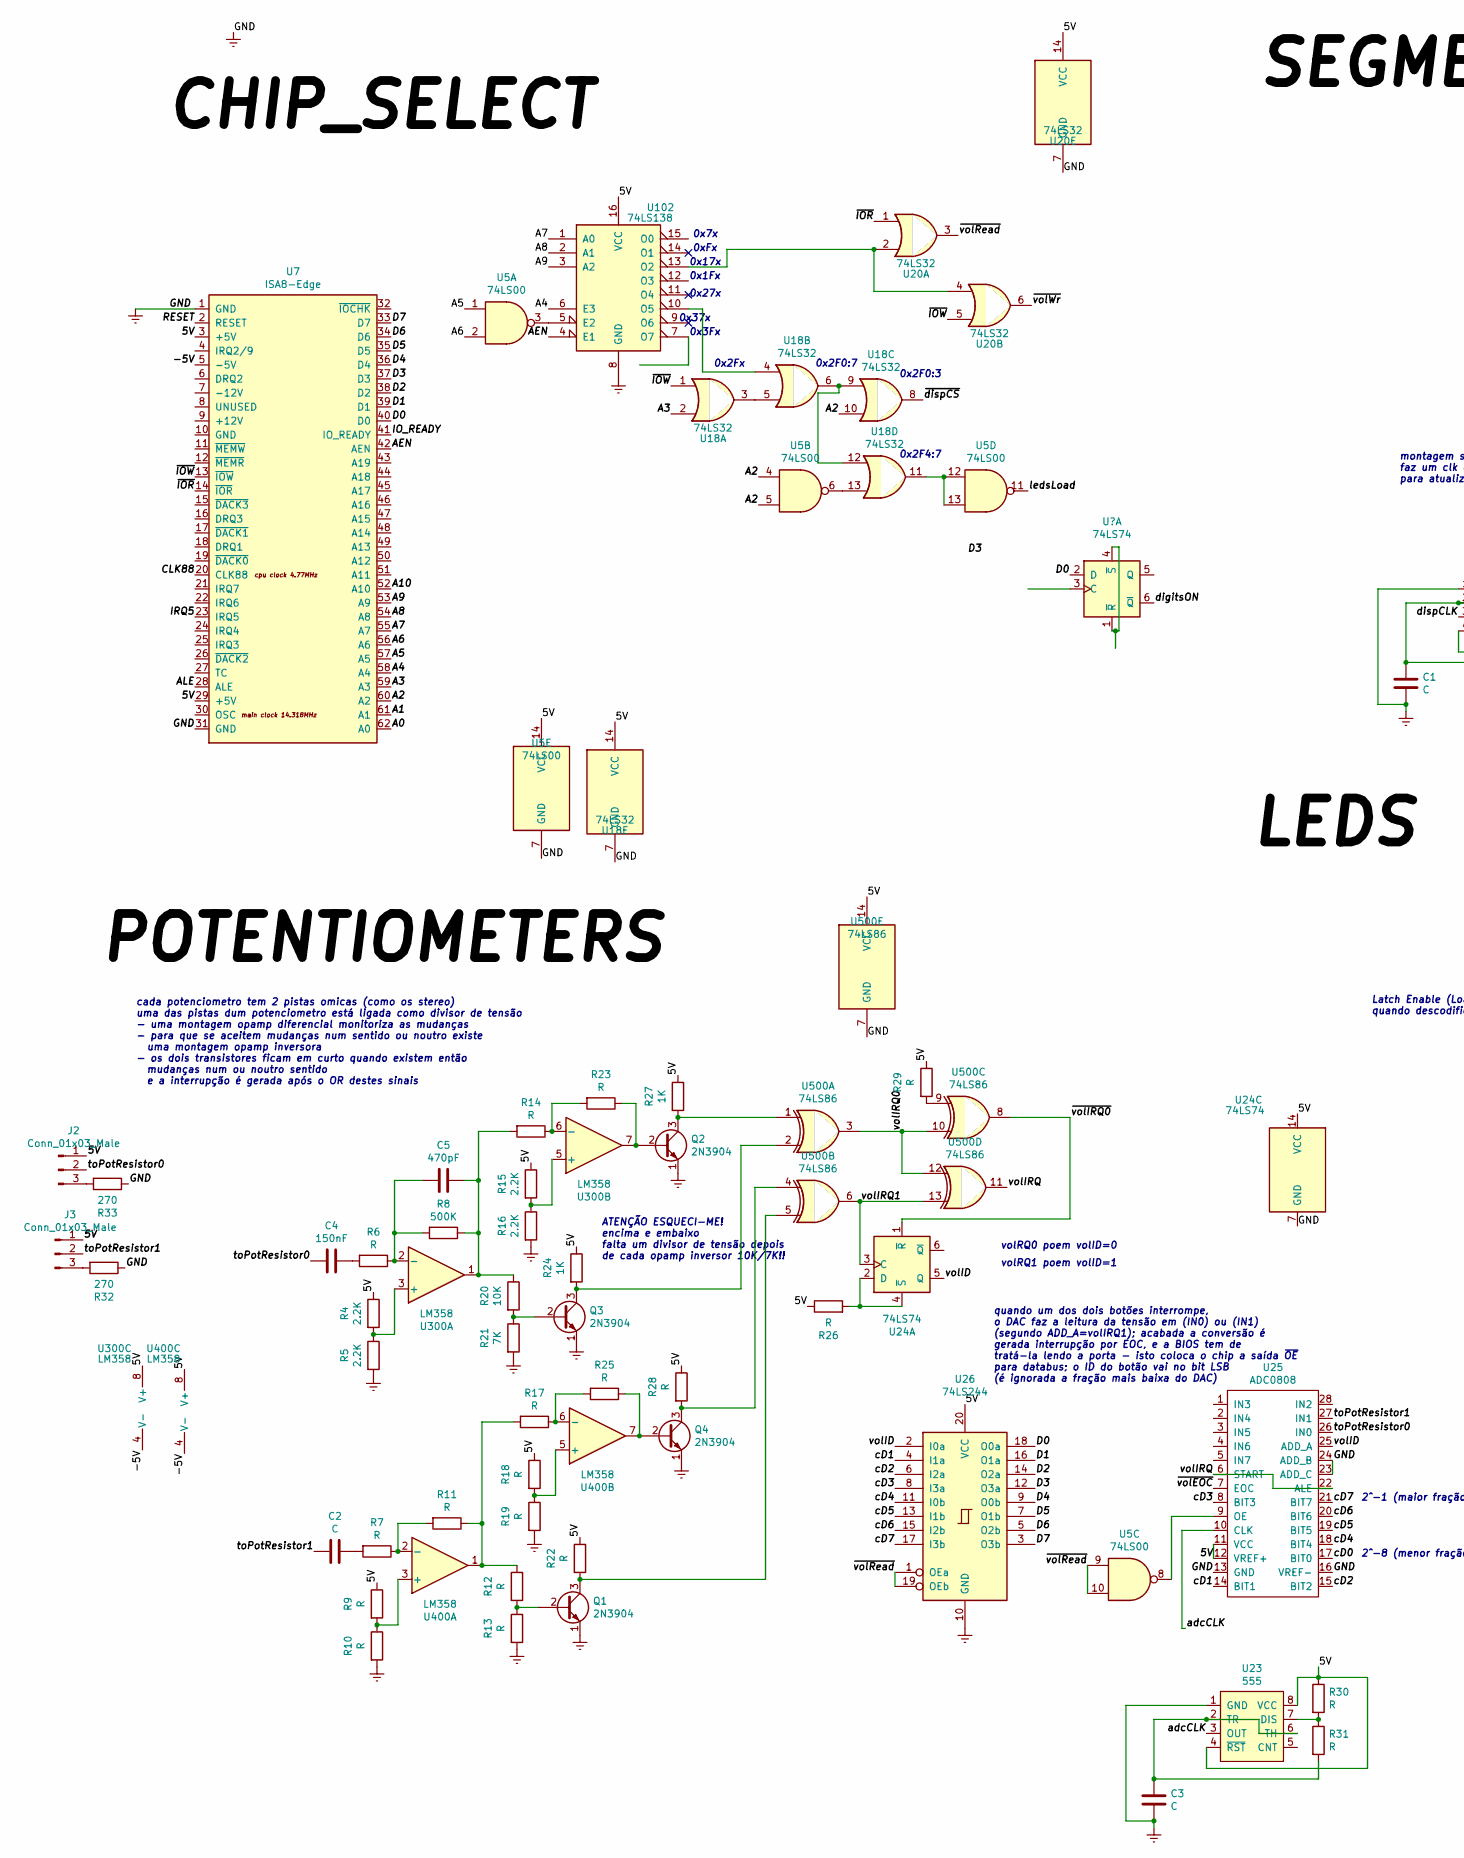
[picture p24: schematic display.sch, part in row 1, column 1]

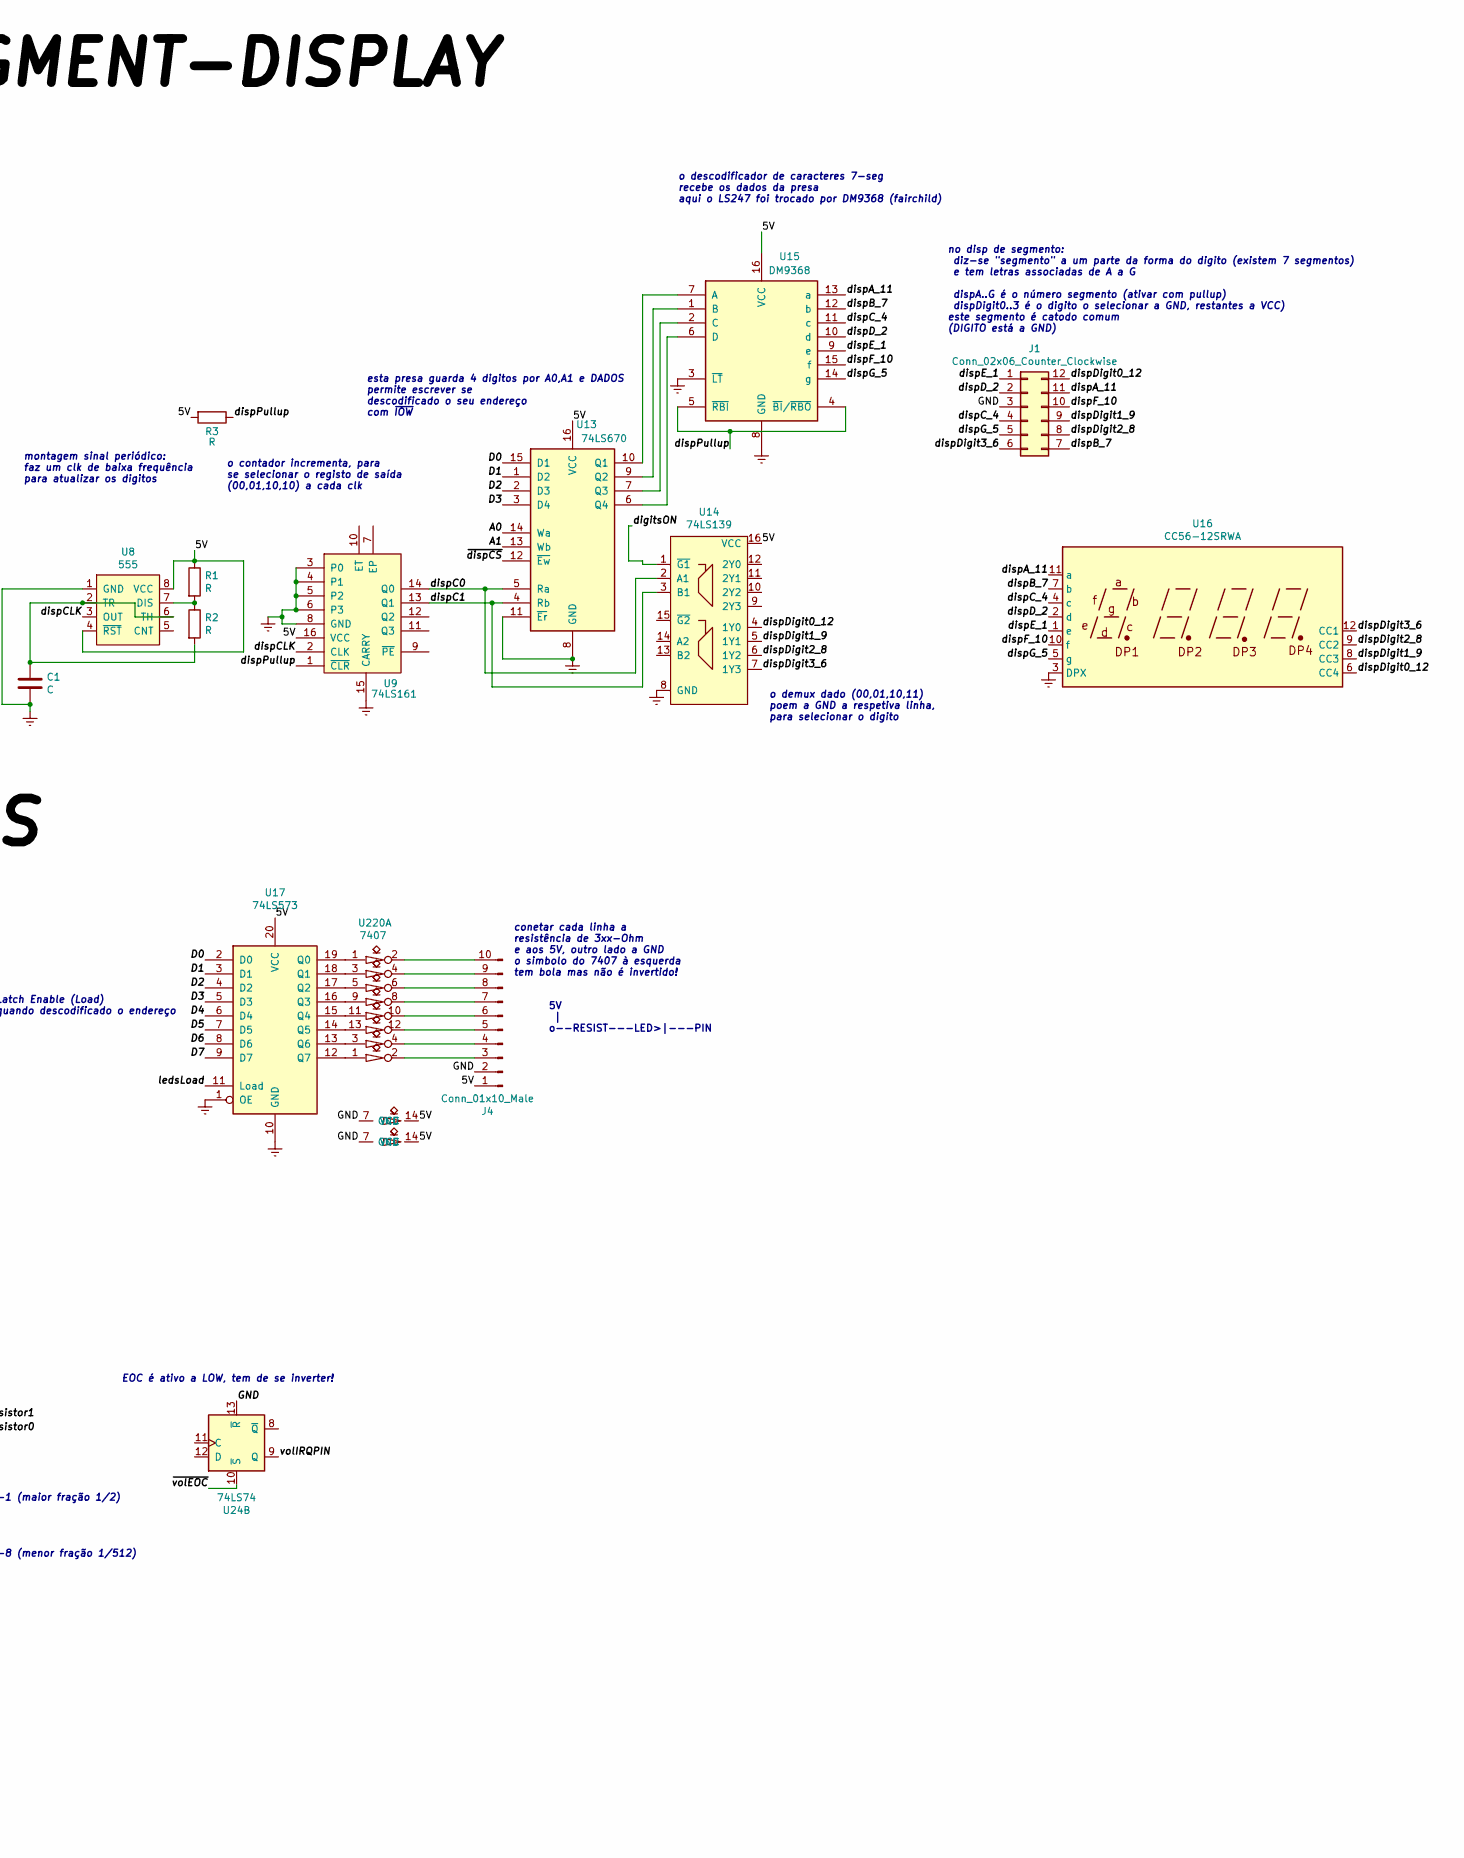
[picture p25: schematic display.sch, part in row 1, column 2]

Parts:
C1, C2, C3: C; standard_2pins_half
C4: 150nF; standard_2pins_half
C5: 470pF
J1: Conn_02x06_Counter_Clockwise; Conector2x6_Oval_anticlock
J2, J3: Conn_01x03_Male; PinHeader_1x03_P2.54mm_Vertical
J4: Conn_01x10_Male; Conector2x5_Oval_alternado
Q1, Q2, Q3, Q4: 2N3904; TO-92_Inline
R1, R2, R3, R6, R7, R9, R10, R11, R12, R13, R14, R17, R18, R19, R22, R23, R25, R26, R28, R29, R30, R31: R; standard_2pins
R4, R5, R15, R16: 2.2K; standard_2pins
R8: 500K; standard_2pins
R20: 10K; standard_2pins
R21: 7K; standard_2pins
R24, R27: 1K; standard_2pins
R32, R33: 270
U5: 74LS00; standard_DIP_14OvalPins
U7: ISA8-Edge; ISA_8bit_edge
U8, U23: 555; standard_DIP_8pins
U9: 74LS161; standard_DIP_16OvalPins
U13: 74LS670; standard_DIP_16OvalPins
U14: 74LS139; standard_DIP_16OvalPins
U15: DM9368; standard_DIP_16OvalPins
U16: CC56-12SRWA; CA56-12SRWA
U17: 74LS573; standard_DIP_20pins_thin_body
U18, U20: 74LS32; standard_DIP_14OvalPins
U24: 74LS74; standard_DIP_14OvalPins
U25: ADC0808; standard_DIP_28pins_thin_doubleBody
U26: 74LS244; standard_DIP_20pins_thin_body
U102: 74LS138; standard_DIP_16OvalPins
U220, U221: 7407; standard_DIP_14OvalPins
U300, U400: LM358; LM386
U500: 74LS86; standard_DIP_14OvalPins

Connections:
/5V: J2.1, J3.1, J4.1, R1.1, R3.2, R4.1, R9.1, R15.1, R18.1, R22.1, R24.1, R26.1, R27.1, R28.1, R29.1, R30.1, U5.14 (VCC), U7.3 (+5V), U7.29 (+5V), U8.4 (~RST), U8.8 (VCC), U9.16 (VCC), U13.16 (VCC), U14.16 (VCC), U15.16 (VCC), U17.20 (VCC), U18.14 (VCC), U20.14 (VCC), U23.4 (~RST), U23.8 (VCC), U24.14 (VCC), U25.11 (VCC), U25.12 (VREF+), U26.20 (VCC), U102.16 (VCC), U220.14 (VCC), U221.14 (VCC), U300.8 (V+), U400.8 (V+), U500.14 (VCC)
/-5V: U7.5 (-5V), U300.4 (V-), U400.4 (V-)
/A0: U7.62 (A0), U13.14 (Wa)
/A1: U7.61 (A1), U13.13 (Wb)
/A2: U5.4, U5.5, U7.60 (A2), U18.10
/A3: U7.59 (A3), U18.2
/A4: U7.58 (A4), U102.6 (E3)
/A5: U5.1, U7.57 (A5)
/A6: U5.2, U7.56 (A6)
/A7: U7.55 (A7), U102.1 (A0)
/A8: U7.54 (A8), U102.2 (A1)
/A9: U7.53 (A9), U102.3 (A2)
/A10: U7.52 (A10)
/AEN: U7.42 (AEN), U102.4 (E1)
/ALE: U7.28 (ALE)
/CLK88: U7.20 (CLK88)
/D0: U7.40 (D0), U13.15 (D1), U17.2 (D0), U26.18 (O0a)
/D1: U7.39 (D1), U13.1 (D2), U17.3 (D1), U26.16 (O1a)
/D2: U7.38 (D2), U13.2 (D3), U17.4 (D2), U26.14 (O2a)
/D3: U7.37 (D3), U13.3 (D4), U17.5 (D3), U26.12 (O3a)
/D4: U7.36 (D4), U17.6 (D4), U26.9 (O0b)
/D5: U7.35 (D5), U17.7 (D5), U26.7 (O1b)
/D6: U7.34 (D6), U17.8 (D6), U26.5 (O2b)
/D7: U7.33 (D7), U17.9 (D7), U26.3 (O3b)
/IO_READY: U7.41 (IO_READY)
/IRQ5: U7.23 (IRQ5)
/RESET: U7.2 (RESET)
/adcCLK: U23.3 (OUT), U25.10 (CLK)
/cD0: U25.17 (BIT0)
/cD1: U25.14 (BIT1), U26.4 (I1a)
/cD2: U25.15 (BIT2), U26.6 (I2a)
/cD3: U25.8 (BIT3), U26.8 (I3a)
/cD4: U25.18 (BIT4), U26.11 (I0b)
/cD5: U25.19 (BIT5), U26.13 (I1b)
/cD6: U25.20 (BIT6), U26.15 (I2b)
/cD7: U25.21 (BIT7), U26.17 (I3b)
/dispA_11: J1.11, U15.13 (a), U16.11 (a)
/dispB_7: J1.7, U15.12 (b), U16.7 (b)
/dispC0: U9.14 (Q0), U13.5 (Ra), U14.2 (A1)
/dispC1: U9.13 (Q1), U13.4 (Rb), U14.3 (B1)
/dispCLK~: U8.3 (OUT), U9.2 (CLK)
/dispC_4: J1.4, U15.11 (c), U16.4 (c)
/dispD_2: J1.2, U15.10 (d), U16.2 (d)
/dispDigit0_12: J1.12, U14.4 (1Y0), U16.6 (CC4)
/dispDigit1_9: J1.9, U14.5 (1Y1), U16.8 (CC3)
/dispDigit2_8: J1.8, U14.6 (1Y2), U16.9 (CC2)
/dispDigit3_6: J1.6, U14.7 (1Y3), U16.12 (CC1)
/dispE_1: J1.1, U15.9 (e), U16.1 (e)
/dispF_10: J1.10, U15.15 (f), U16.10 (f)
/dispG_5: J1.5, U15.14 (g), U16.5 (g)
/dispPullup: R3.1, U9.1 (~CLR), U15.4 (~BI~/~RBO), U15.5 (~RBI)
/ledsLoad: U5.11, U17.11 (Load)
/toPotResistor0: C4.2, J2.2, U25.26 (IN0)
/toPotResistor1: C2.2, J3.2, U25.27 (IN1)
/volID: U24.5 (Q), U25.25 (ADD_A), U26.2 (I0a)
/volIRQ: U25.6 (START), U25.22 (ALE), U500.11
/volIRQ0: U500.3, U500.10, U500.12
/volIRQ1: U24.3 (C), U500.6, U500.13
/volIRQPIN: U24.9 (Q)
/~IOR: U7.14 (~IOR), U20.1
/~IOW: U7.13 (~IOW), U18.1, U20.5
/~dispCS: U13.12 (~Ew), U18.8
/~volEOC: U24.10 (~S), U25.7 (EOC)
/~volIRQ0: U24.1 (~R), U500.8
/~volRead: U5.9, U5.10, U20.3, U26.1 (OEa), U26.19 (OEb)
/~volWr: U20.6
unnamed: C1.1, R2.2, U8.2 (TR), U8.6 (TH)
unnamed: C2.1, R7.2
unnamed: C3.1, R31.2, U23.2 (TR), U23.6 (TH)
unnamed: C4.1, R6.2
unnamed: C5.1, R8.1, R14.2, R20.1, U300.1
unnamed: C5.2, R6.1, R8.2, U300.2 (-)
unnamed: J2.3, R33.2
unnamed: J3.3, R32.2
unnamed: J4.3, U221.2
unnamed: J4.4, U221.4
unnamed: J4.5, U220.12
unnamed: J4.6, U220.10
unnamed: J4.7, U220.8
unnamed: J4.8, U220.6
unnamed: J4.9, U220.4
unnamed: J4.10, U220.2
unnamed: Q1.2 (B), R12.2, R13.1
unnamed: Q1.3 (C), R22.2, U500.5
unnamed: Q2.2 (B), R23.1, U300.7
unnamed: Q2.3 (C), R27.2, U500.1
unnamed: Q3.2 (B), R20.2, R21.1
unnamed: Q3.3 (C), R24.2, U500.2
unnamed: Q4.2 (B), R25.1, U400.7
unnamed: Q4.3 (C), R28.2, U500.4
unnamed: R1.2, R2.1, U8.7 (DIS)
unnamed: R4.2, R5.1, U300.3 (+)
unnamed: R9.2, R10.1, U400.3 (+)
unnamed: R11.1, R12.1, R17.2, U400.1
unnamed: R7.1, R11.2, U400.2 (-)
unnamed: R14.1, R23.2, U300.6 (-)
unnamed: R15.2, R16.1, U300.5 (+)
unnamed: R17.1, R25.2, U400.6 (-)
unnamed: R18.2, R19.1, U400.5 (+)
unnamed: R26.2, U24.2 (D), U24.4 (~S)
unnamed: R29.2, U500.9
unnamed: R30.2, R31.1, U23.7 (DIS)
unnamed: U13.6 (Q4), U15.6 (D)
unnamed: U13.7 (Q3), U15.2 (C)
unnamed: U13.9 (Q2), U15.1 (B)
unnamed: U13.10 (Q1), U15.7 (A)
unnamed: U17.12 (Q7), U221.1
unnamed: U17.13 (Q6), U221.3
unnamed: U17.14 (Q5), U220.13
unnamed: U17.15 (Q4), U220.11
unnamed: U17.16 (Q3), U220.9
unnamed: U17.17 (Q2), U220.5
unnamed: U17.18 (Q1), U220.3
unnamed: U17.19 (Q0), U220.1
unnamed: U18.3, U18.5
unnamed: U5.12, U5.13, U18.11
unnamed: U18.6, U18.9, U18.12
unnamed: U5.6, U18.13
unnamed: U5.8, U25.9 (OE)
unnamed: U5.3, U102.5 (E2)
unnamed: U18.4, U102.10 (O5)
unnamed: U20.2, U20.4, U102.13 (O2)

Notes on the sheet:
montagem sinal periódico: faz um clk de baixa frequência para atualizar os digitos
o contador incrementa, para se selecionar o registo de saída (00,01,10,10) a cada clk
esta presa guarda 4 digitos por A0,A1 e DADOS permite escrever se descodificado o seu endereço com ~IOW
o demux dado (00,01,10,11) poem a GND a respetiva linha, para selecionar o digito
0x2Fx
0x1Fx
o descodificador de caracteres 7-seg recebe os dados da presa aqui o LS247 foi trocado por DM9368 (fairchild)
0x2F4:7
0x2F0:7
2^-1 (maior fração 1/2)
2^-8 (menor fração 1/512)
quando um dos dois botões interrompe, o DAC faz a leitura da tensão em (IN0) ou (IN1) (segundo ADD_A=volIRQ1); acabada a conversão é gerada interrupção por EOC, e a BIOS tem de tratá-la lendo a porta - isto coloca o chip a saída ~OE~ para databus; o ID do botão vai no bit LSB (é ignorada a fração m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
no disp de segmento: diz-se "segmento" a um parte da forma do digito (existem 7 segmentos) e tem letras associadas de A a G dispA..G é o número segmento (ativar com pullup) dispDigit0..3 é o digito o selecionar a GND, restantes a VCC) este segmento é catodo comum (DIGITO está a GND)
cada potenciometro tem 2 pistas omicas (como os stereo) uma das pistas dum potenciometro está ligada como divisor de tensão - uma montagem opamp diferencial monitoriza as mudanças - para que se aceitem mudanças num sentido ou noutro existe uma montagem opamp inversora - os dois transistores ficam e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
5V | o--RESIST---LED>|---PIN
conetar cada linha a resistência de 3xx-Ohm e aos 5V, outro lado a GND o simbolo do 7407 à esquerda tem bola mas não é invertido!
0x17x
0xFx
0x27x
0x37x
volRQ0 poem volID=0
volRQ1 poem volID=1
0x7x
Latch Enable (Load) quando descodificado o endereço
0x2F0:3
ATENÇÃO ESQUECI-ME! encima e embaixo falta um divisor de tensão depois de cada opamp inversor 10K/7K!!
EOC é ativo a LOW, tem de se inverter!
0x3Fx

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
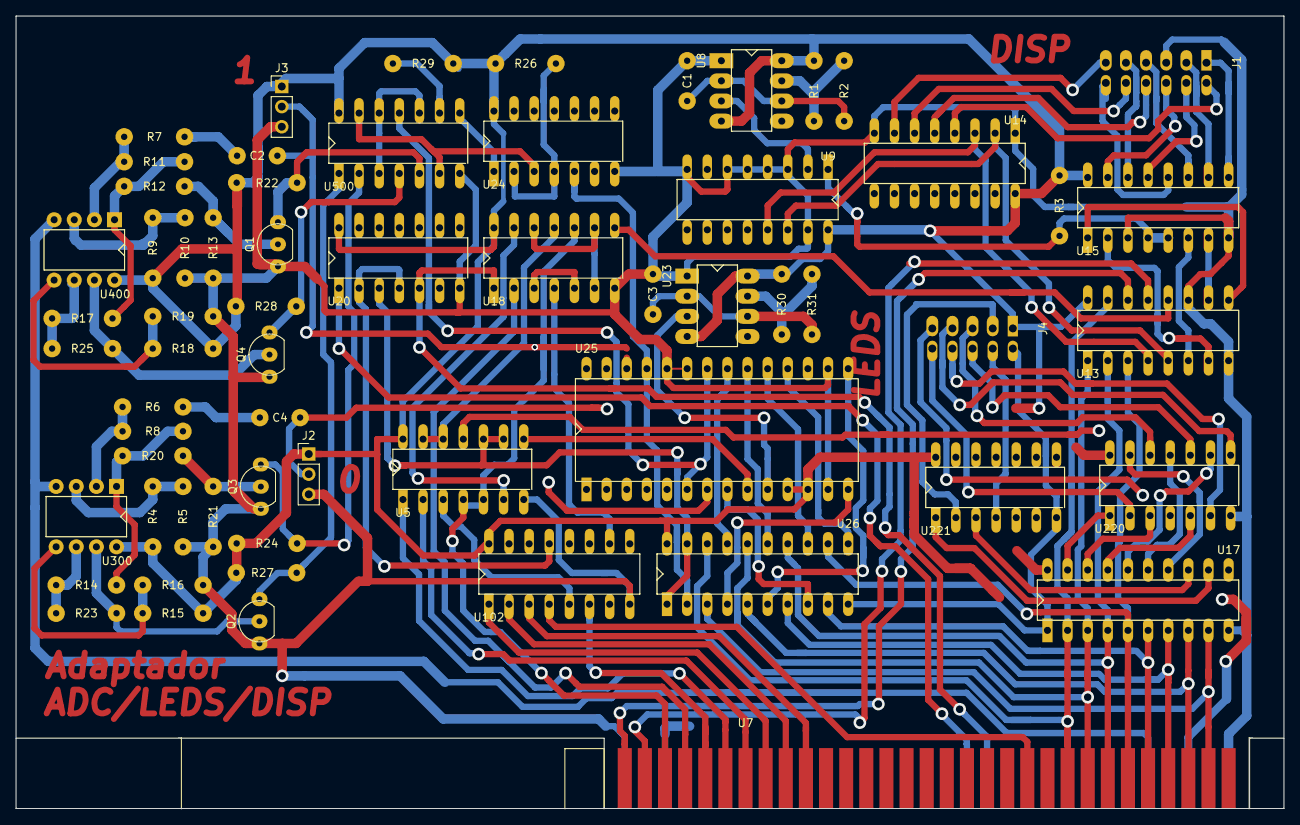
[picture p26: board display.kicad_pcb from above]

Board: 2 copper layers, 160.0 x 100.0 mm, 63 parts (0 on the bottom side), 112 nets.
